rhapsodyv/voron-panel-holder/v12-fase3-juncao-tophat.png

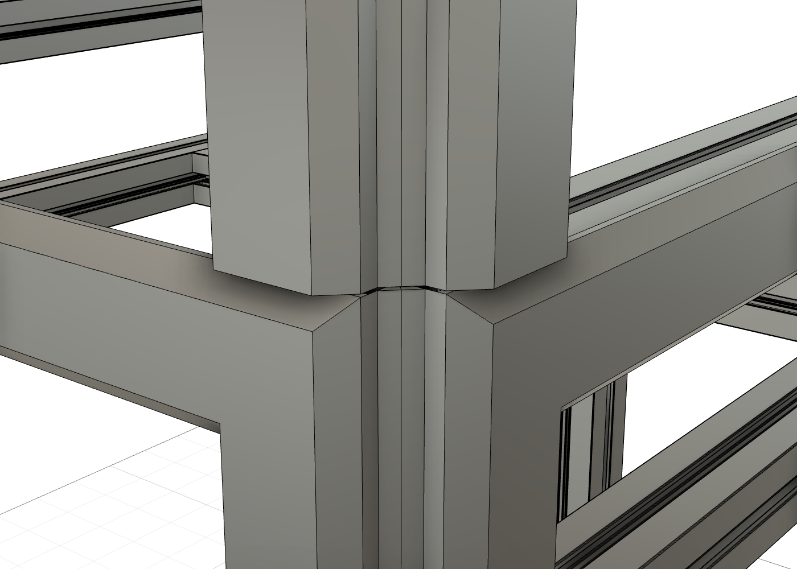
v12-fase3-juncao-tophat.png
