rhapsodyv/voron-panel-holder/aleta-porta-dobradica.png

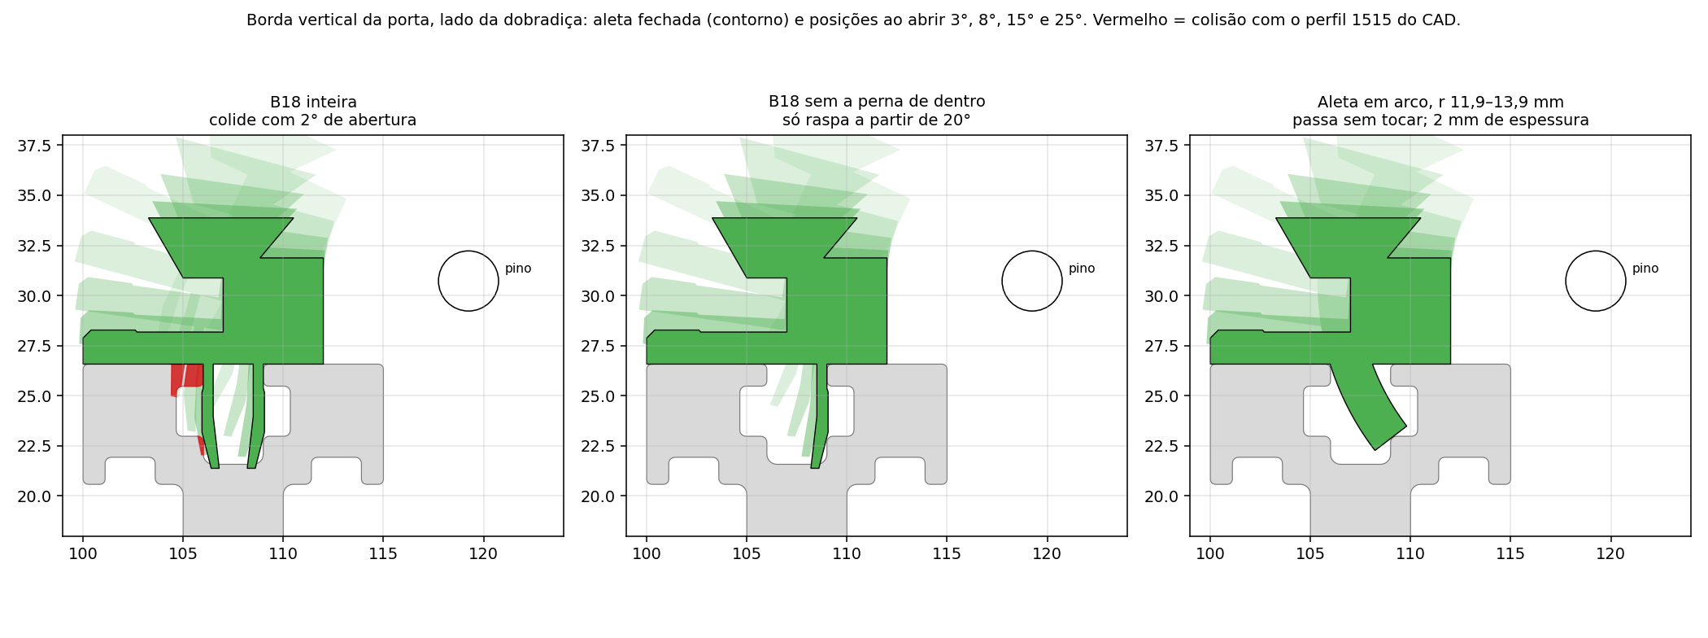
aleta-porta-dobradica.png
