rhapsodyv/voron-panel-holder/b18-rasgo-misumi.png

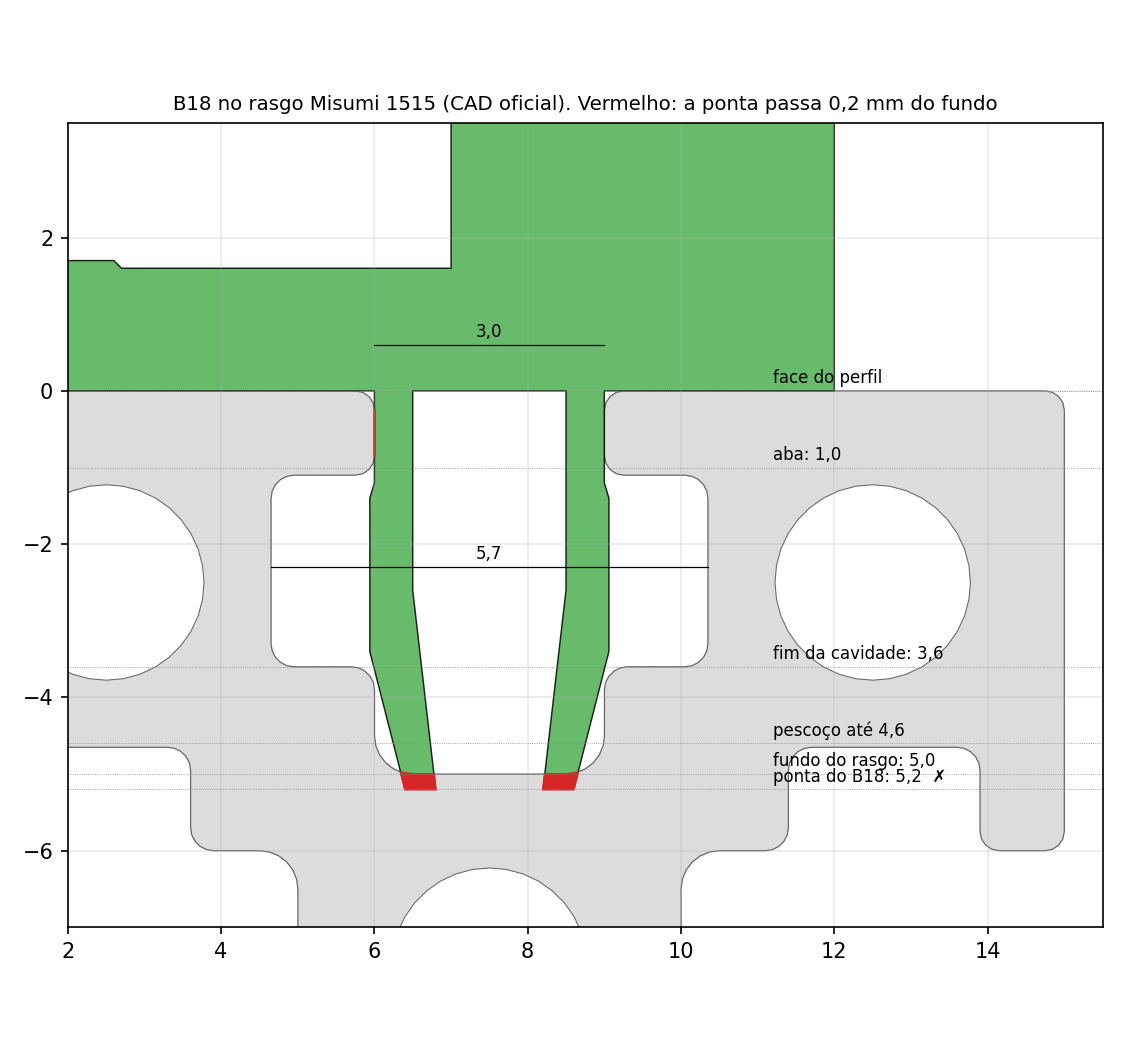
b18-rasgo-misumi.png
