rhapsodyv/voron-panel-holder/camadas-v0.png

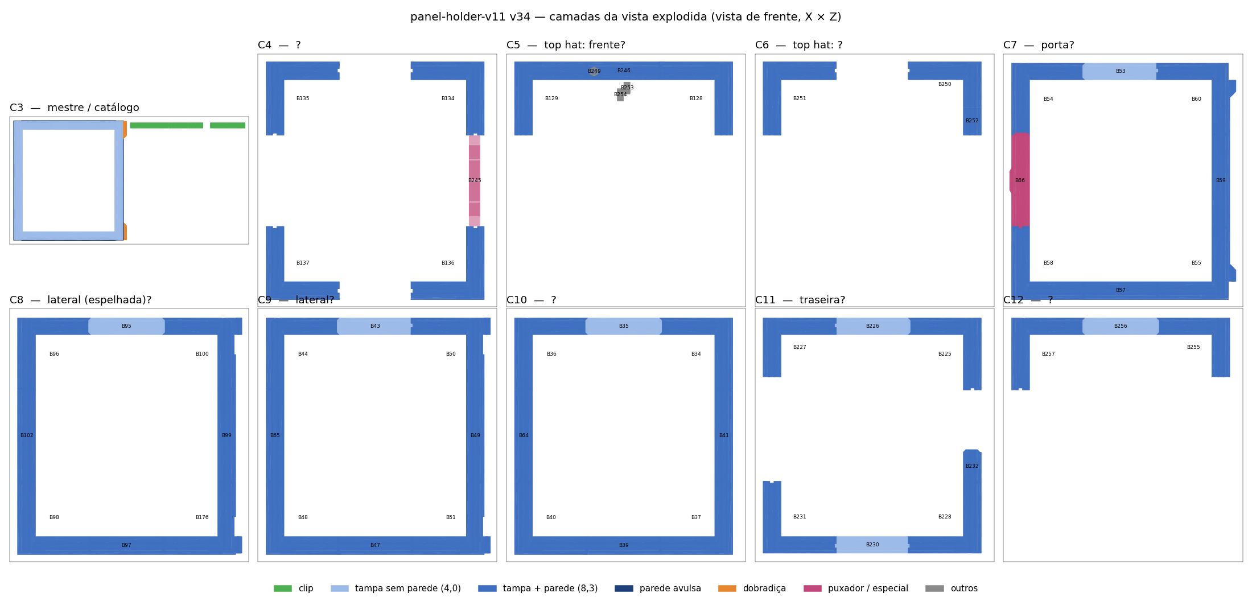
camadas-v0.png
