rhapsodyv/voron-panel-holder/canto-parede-hv-cortes.png

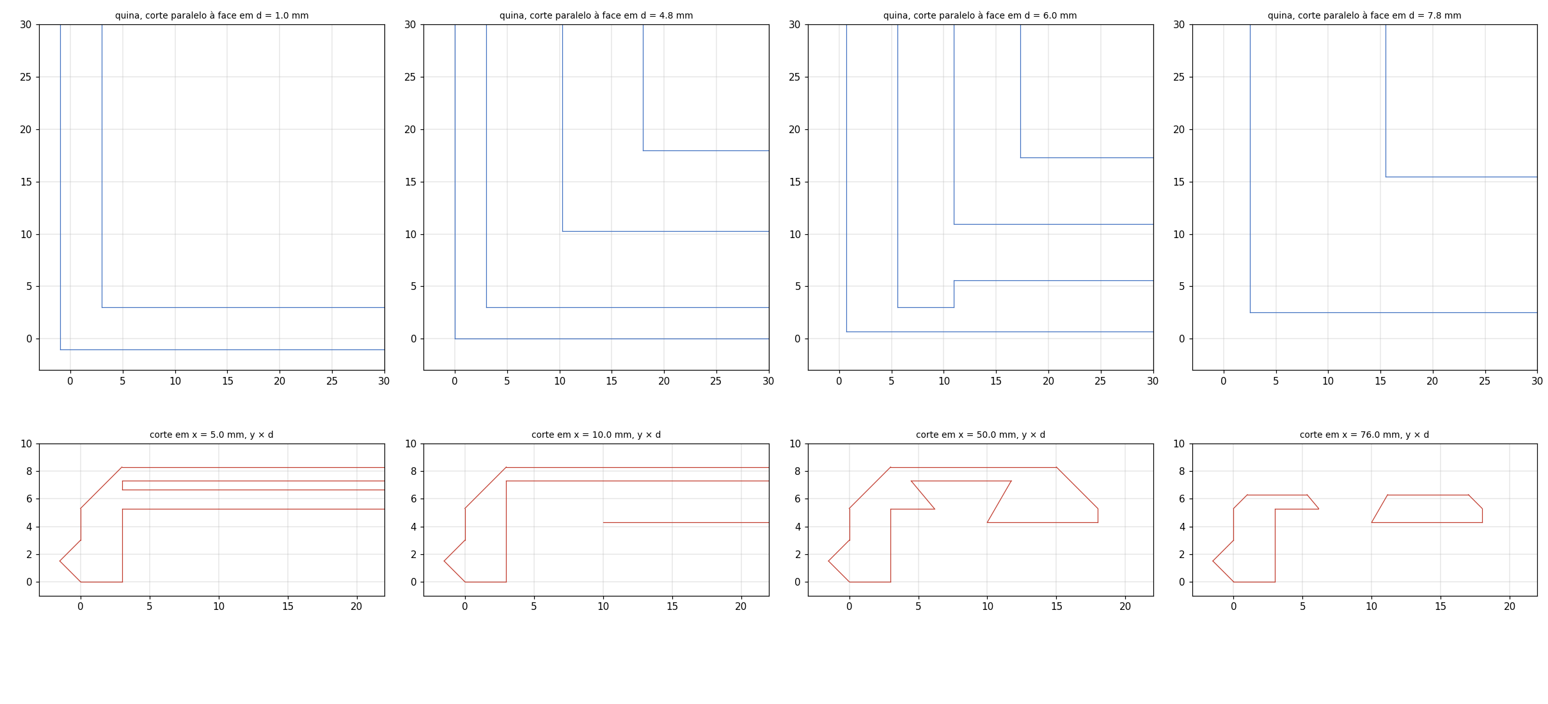
canto-parede-hv-cortes.png
