rhapsodyv/voron-panel-holder/clips-vs-tampa.png

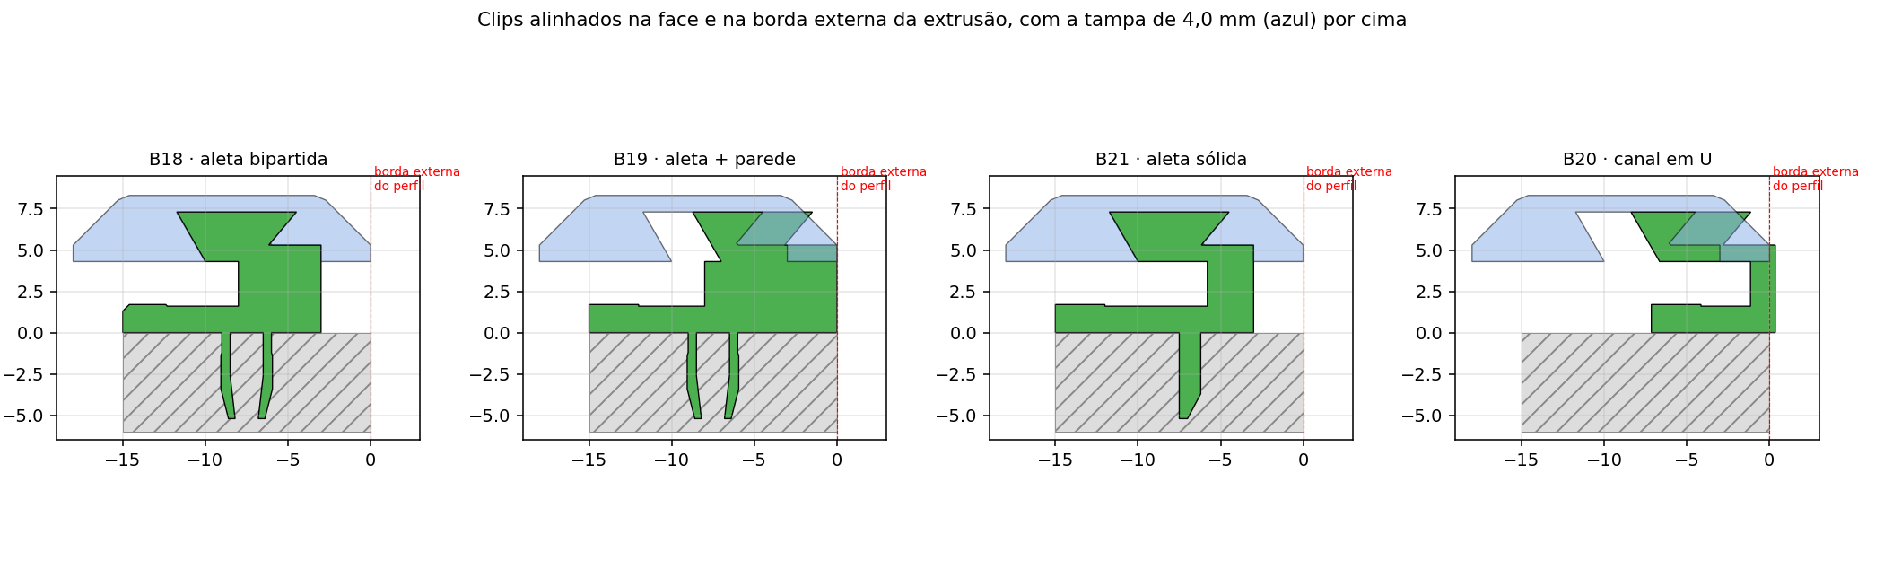
clips-vs-tampa.png
