rhapsodyv/voron-panel-holder/ideias-trava/peca-unica-aleta-iso.png

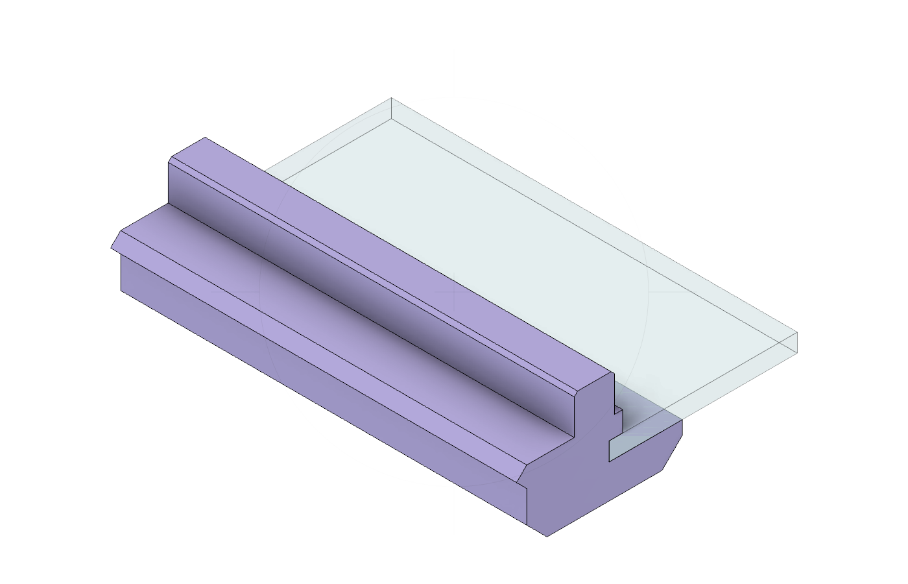
ideias-trava/peca-unica-aleta-iso.png
