rhapsodyv/voron-panel-holder/ideias-trava/peca-unica-aleta-ponta.png

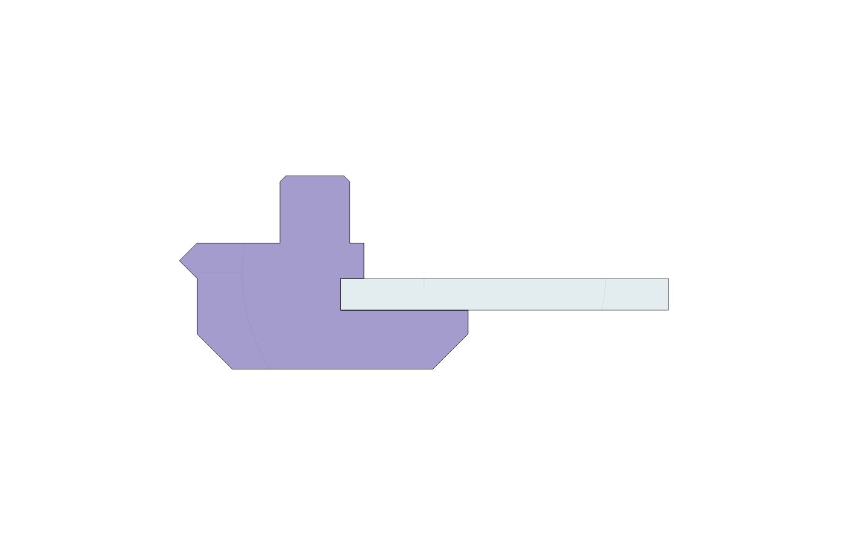
ideias-trava/peca-unica-aleta-ponta.png
