rhapsodyv/voron-panel-holder/ideias-trava/peca-unica-balanco.png

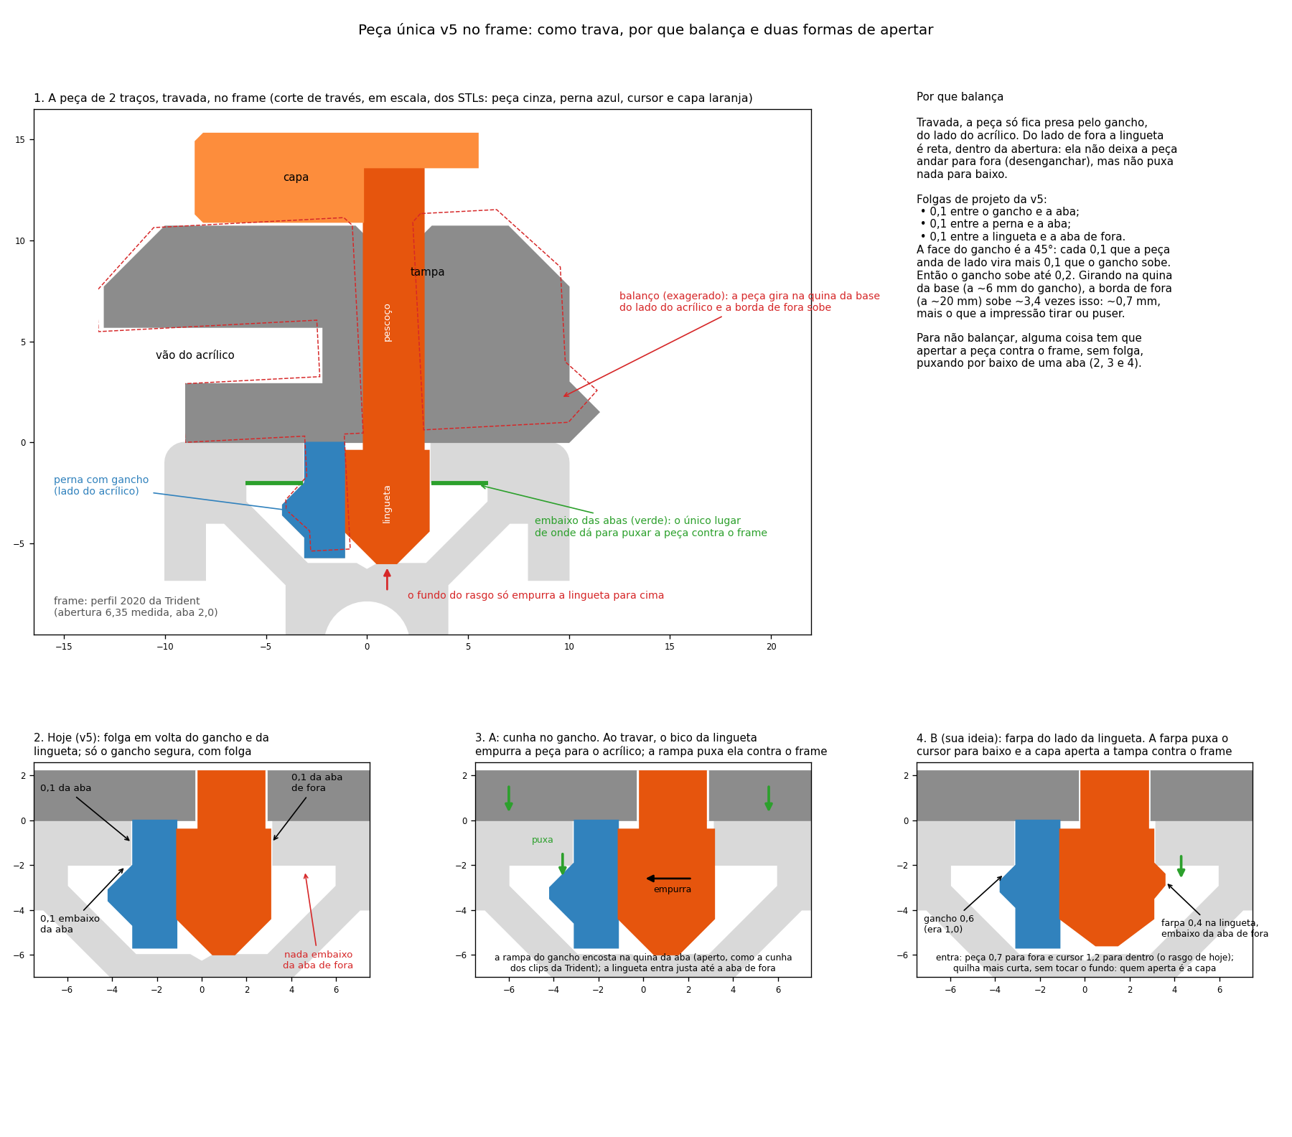
ideias-trava/peca-unica-balanco.png
