rhapsodyv/voron-panel-holder/ideias-trava/peca-unica-base-inteira-iso.png

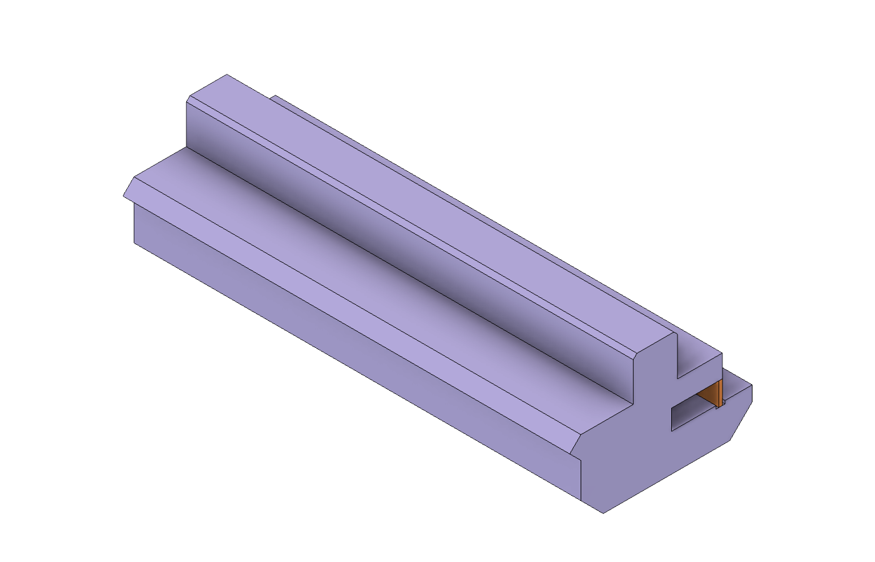
ideias-trava/peca-unica-base-inteira-iso.png
