rhapsodyv/voron-panel-holder/ideias-trava/peca-unica-base-inteira-ponta.png

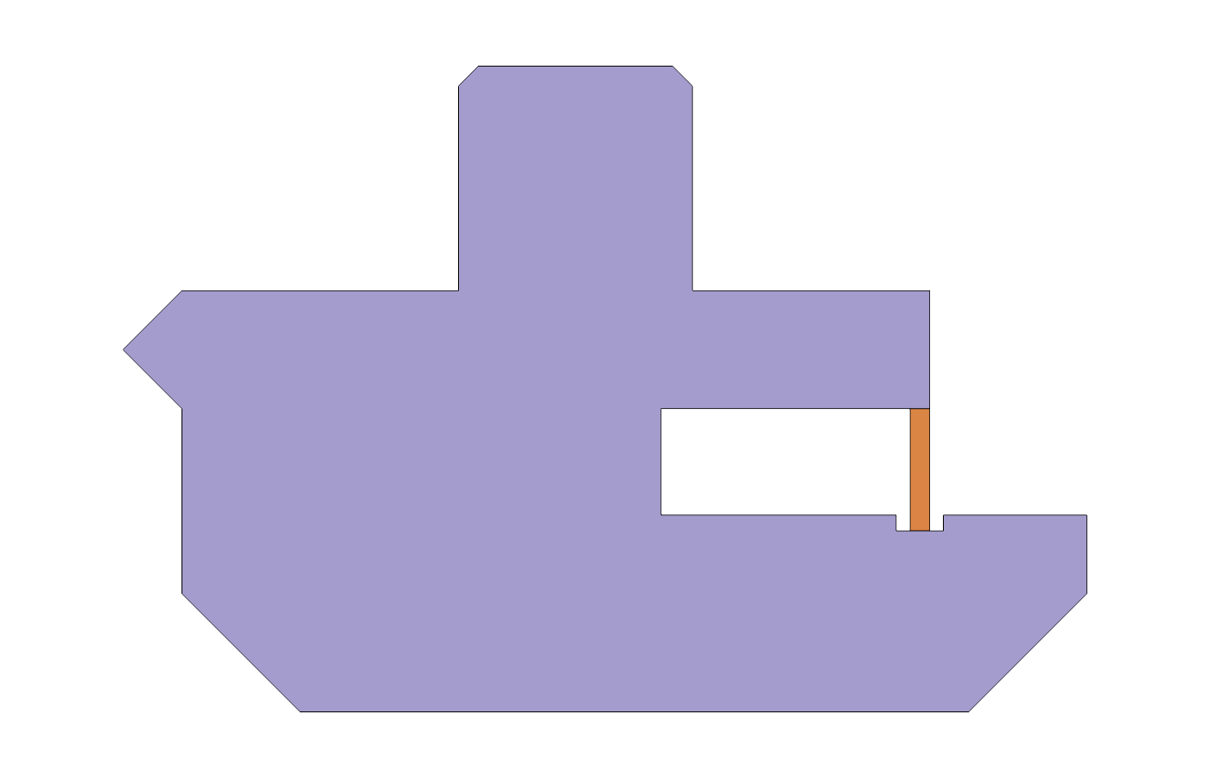
ideias-trava/peca-unica-base-inteira-ponta.png
