rhapsodyv/voron-panel-holder/ideias-trava/peca-unica-canto.png

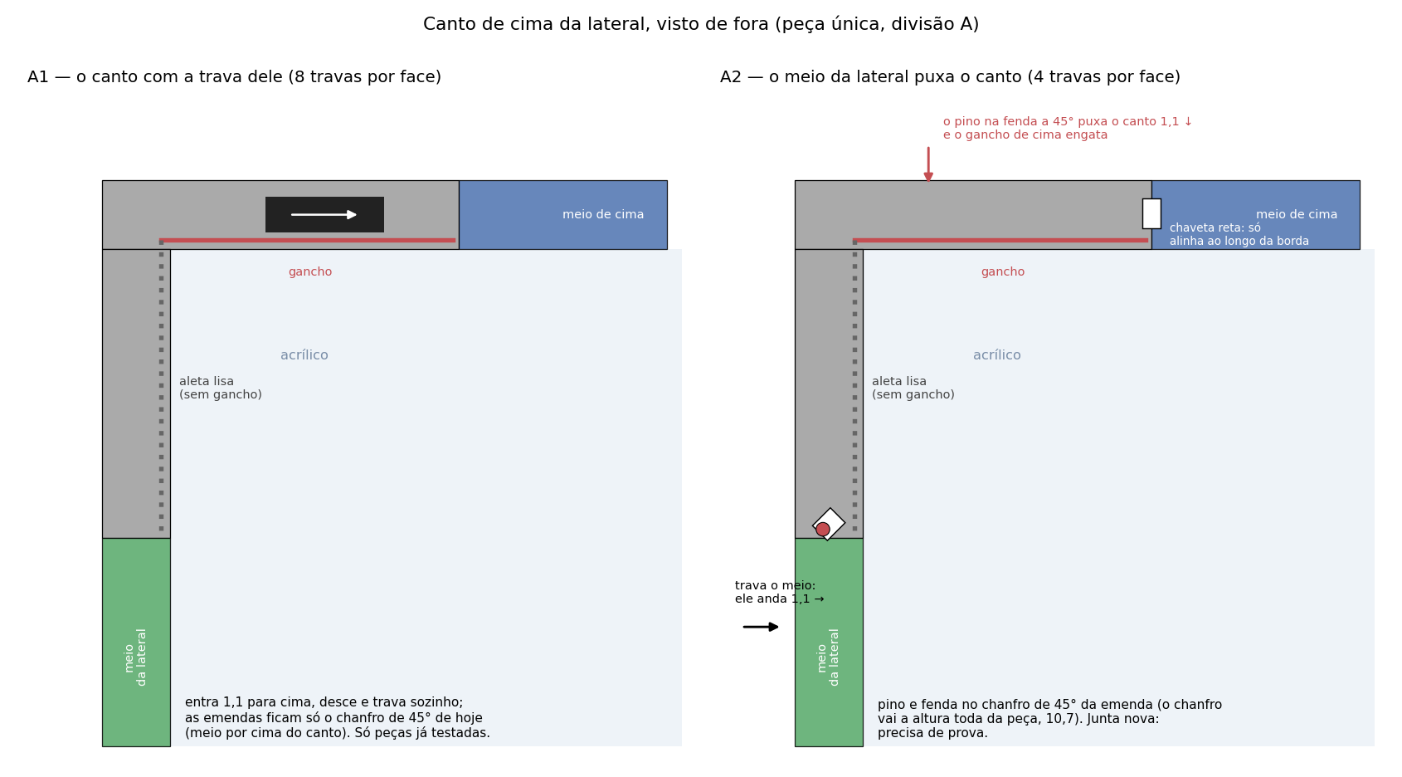
ideias-trava/peca-unica-canto.png
