rhapsodyv/voron-panel-holder/ideias-trava/peca-unica-cunha-canto.png

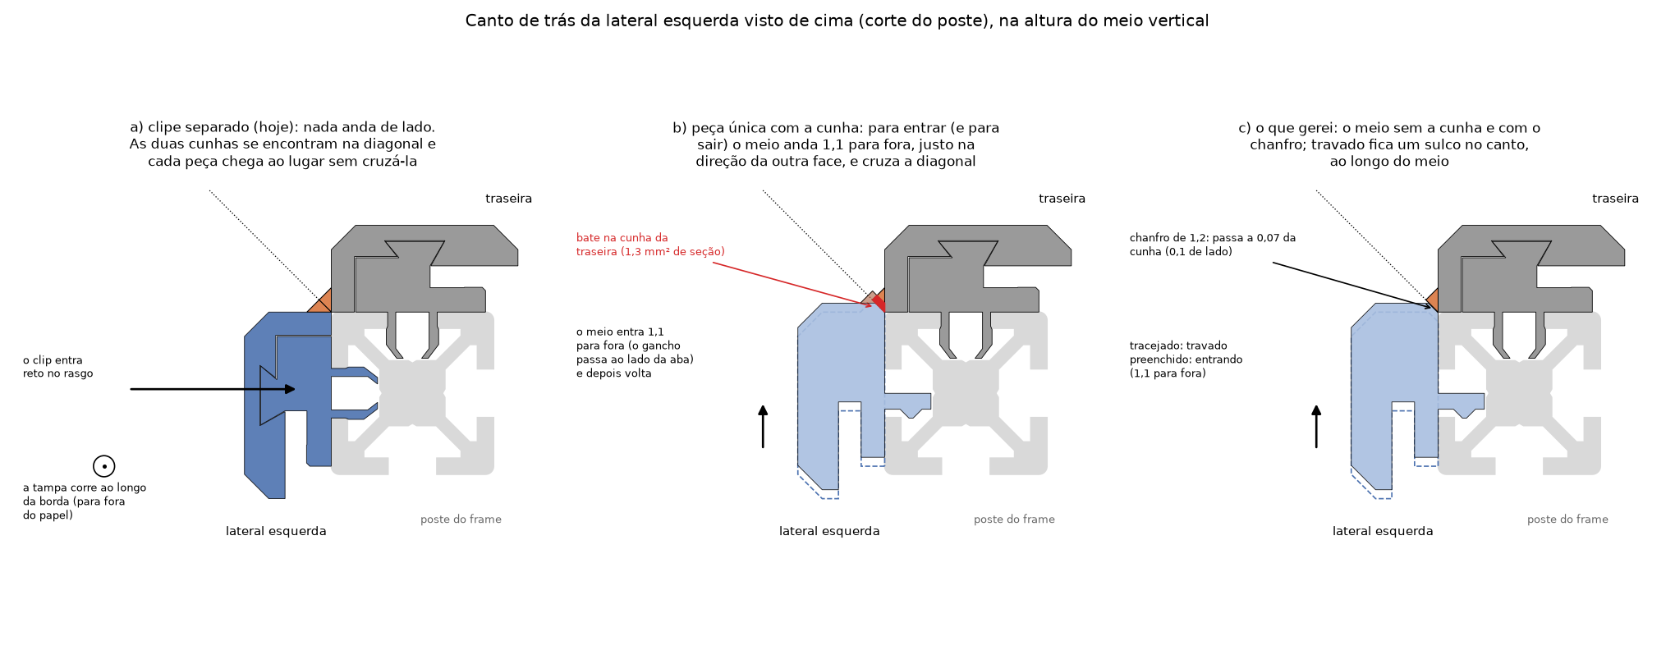
ideias-trava/peca-unica-cunha-canto.png
