rhapsodyv/voron-panel-holder/ideias-trava/peca-unica-deitada.png

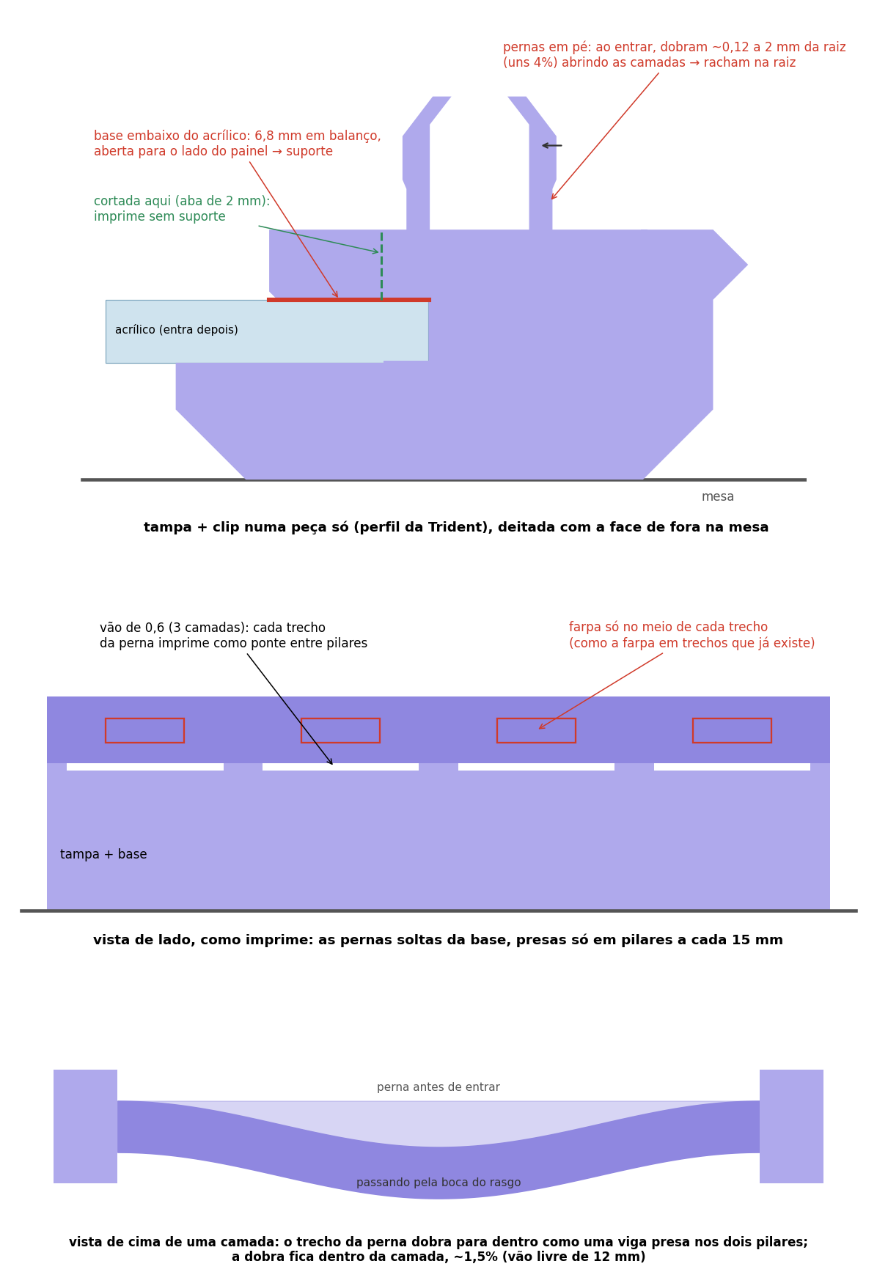
ideias-trava/peca-unica-deitada.png
