rhapsodyv/voron-panel-holder/ideias-trava/peca-unica-divisao.png

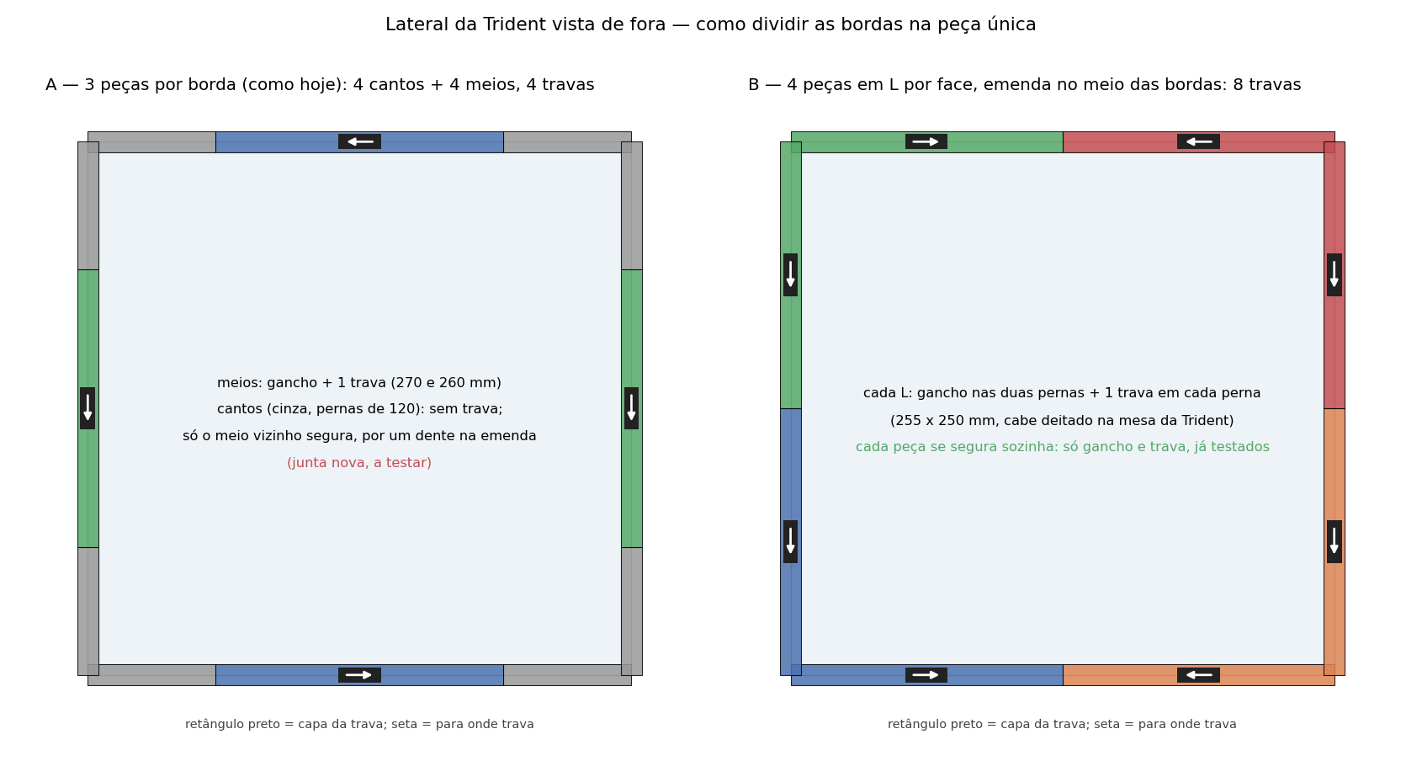
ideias-trava/peca-unica-divisao.png
