rhapsodyv/voron-panel-holder/ideias-trava/peca-unica-emenda.png

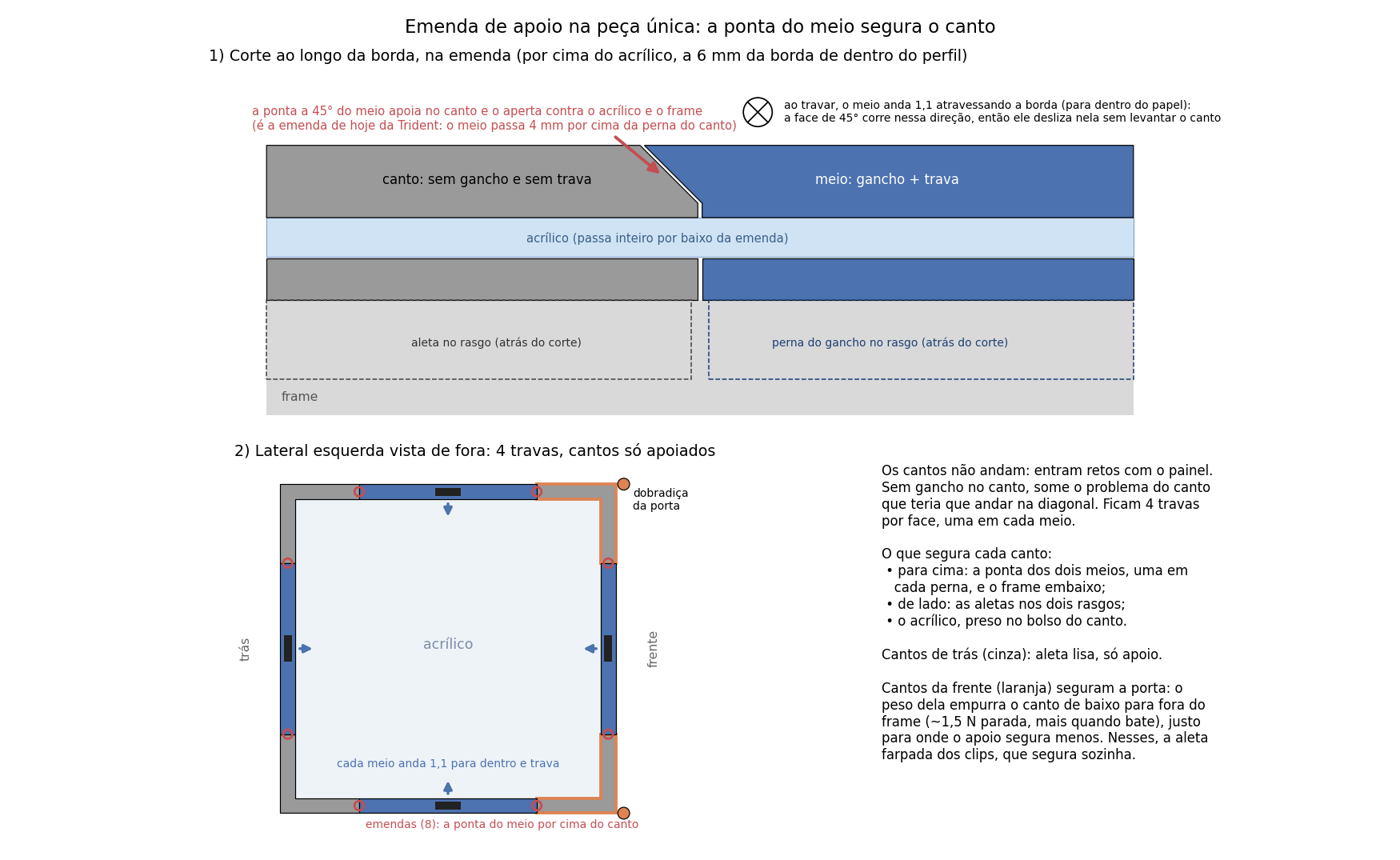
ideias-trava/peca-unica-emenda.png
