rhapsodyv/voron-panel-holder/ideias-trava/peca-unica-fusion-ponta.png

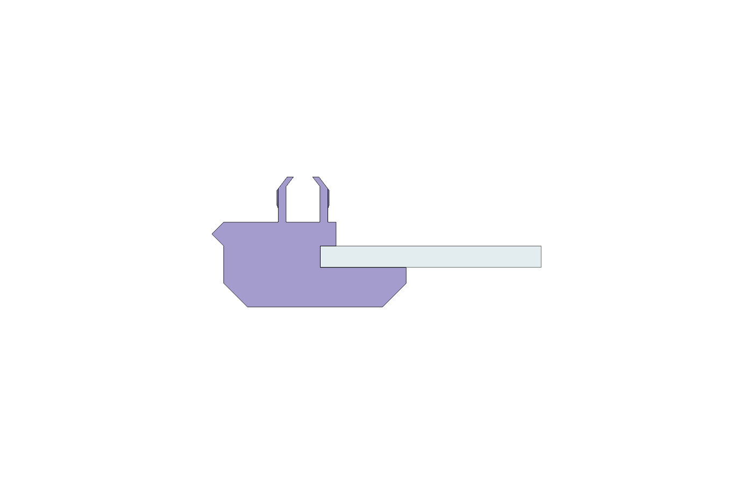
ideias-trava/peca-unica-fusion-ponta.png
