rhapsodyv/voron-panel-holder/ideias-trava/peca-unica-sem-deslocar.png

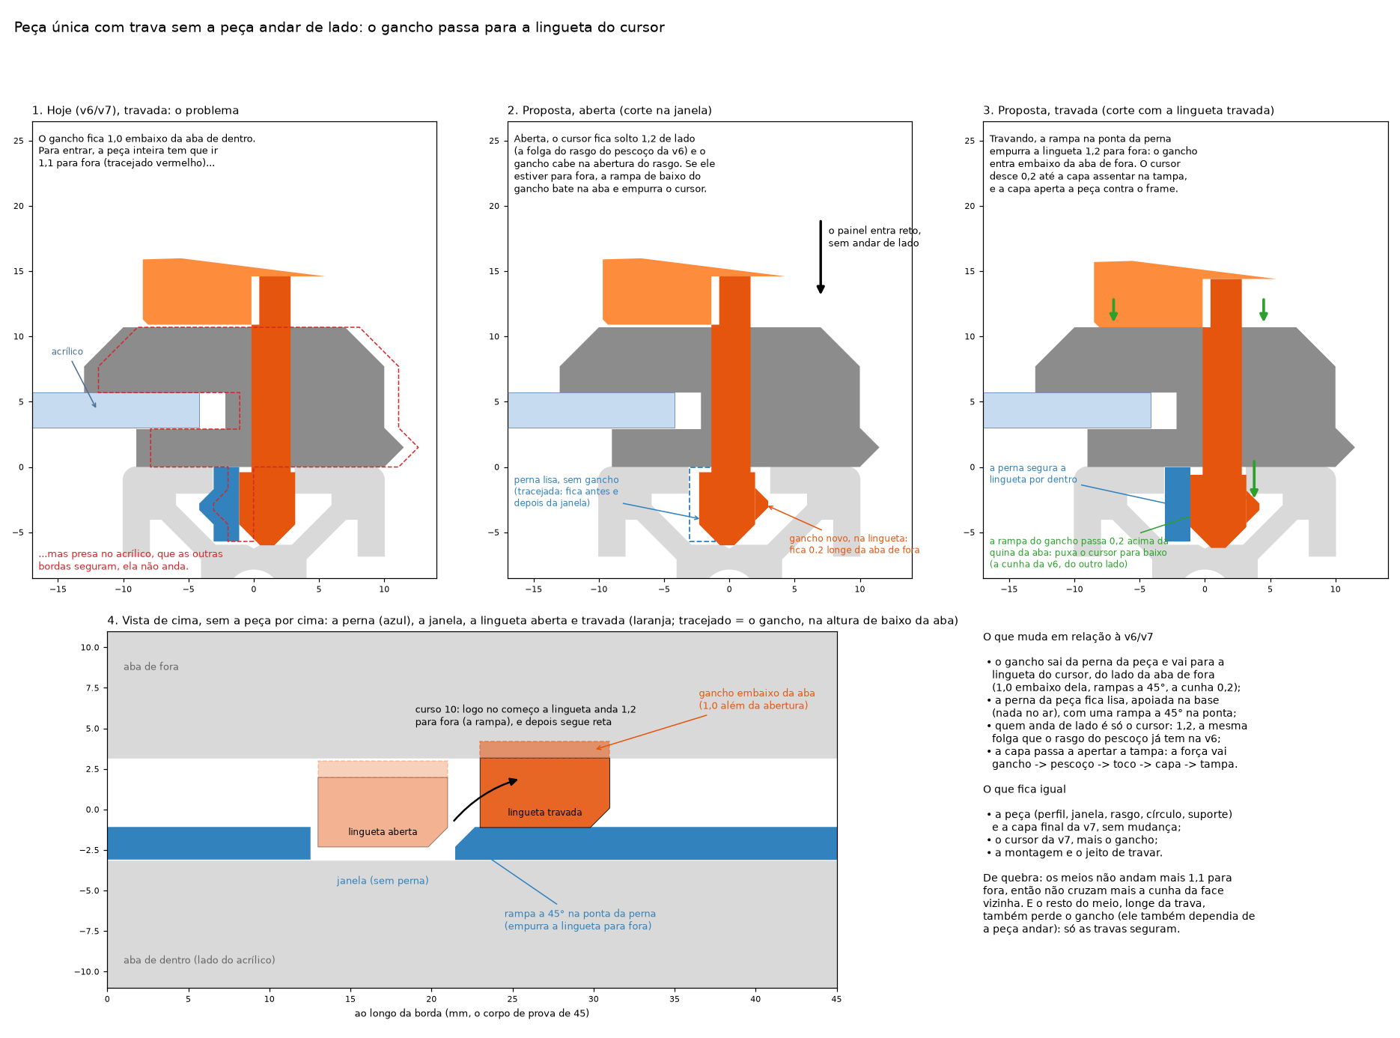
ideias-trava/peca-unica-sem-deslocar.png
