rhapsodyv/voron-panel-holder/ideias-trava/trava-bordas-proposta.png

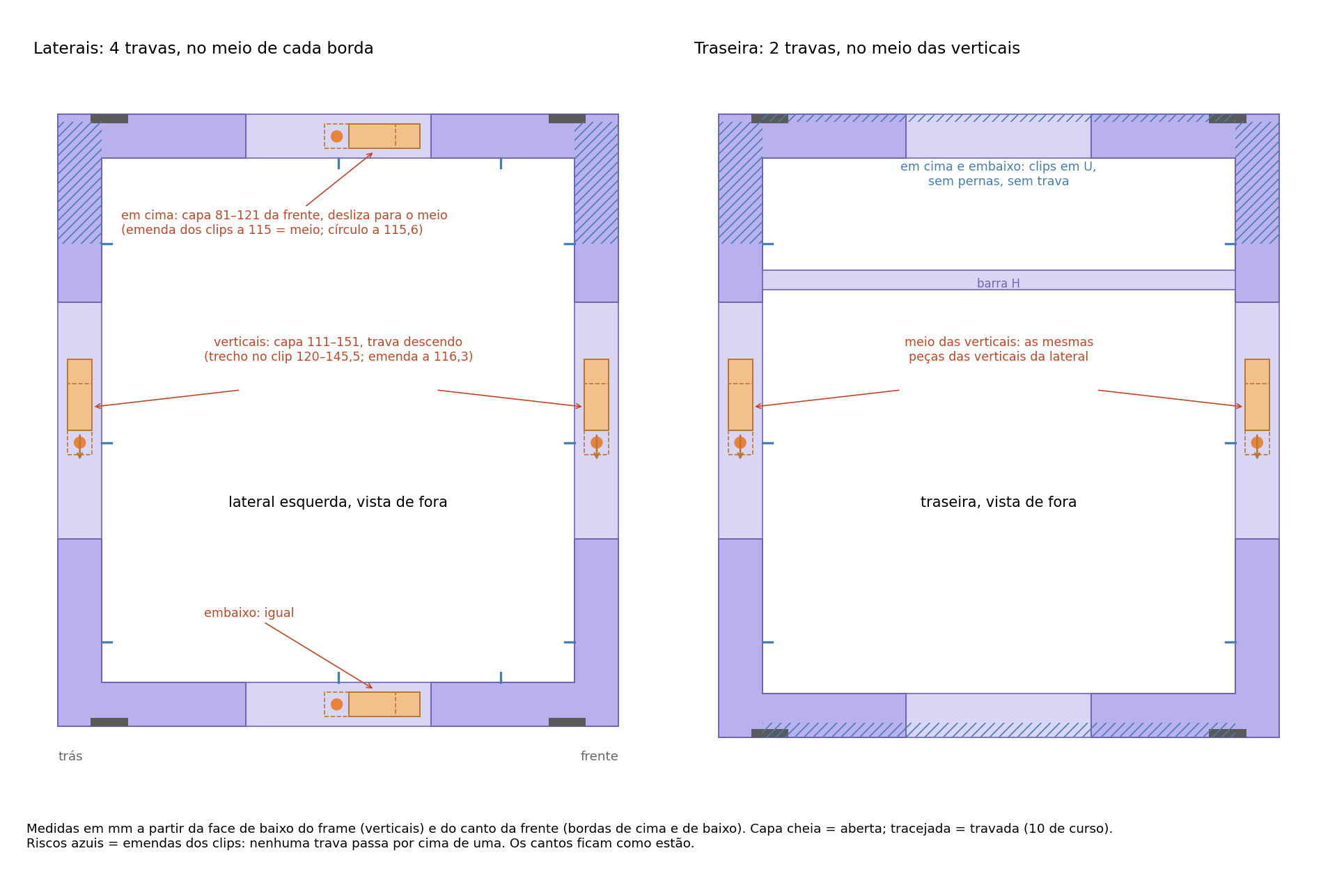
ideias-trava/trava-bordas-proposta.png
