rhapsodyv/voron-panel-holder/ideias-trava/trava-cantos-proposta-v2.png

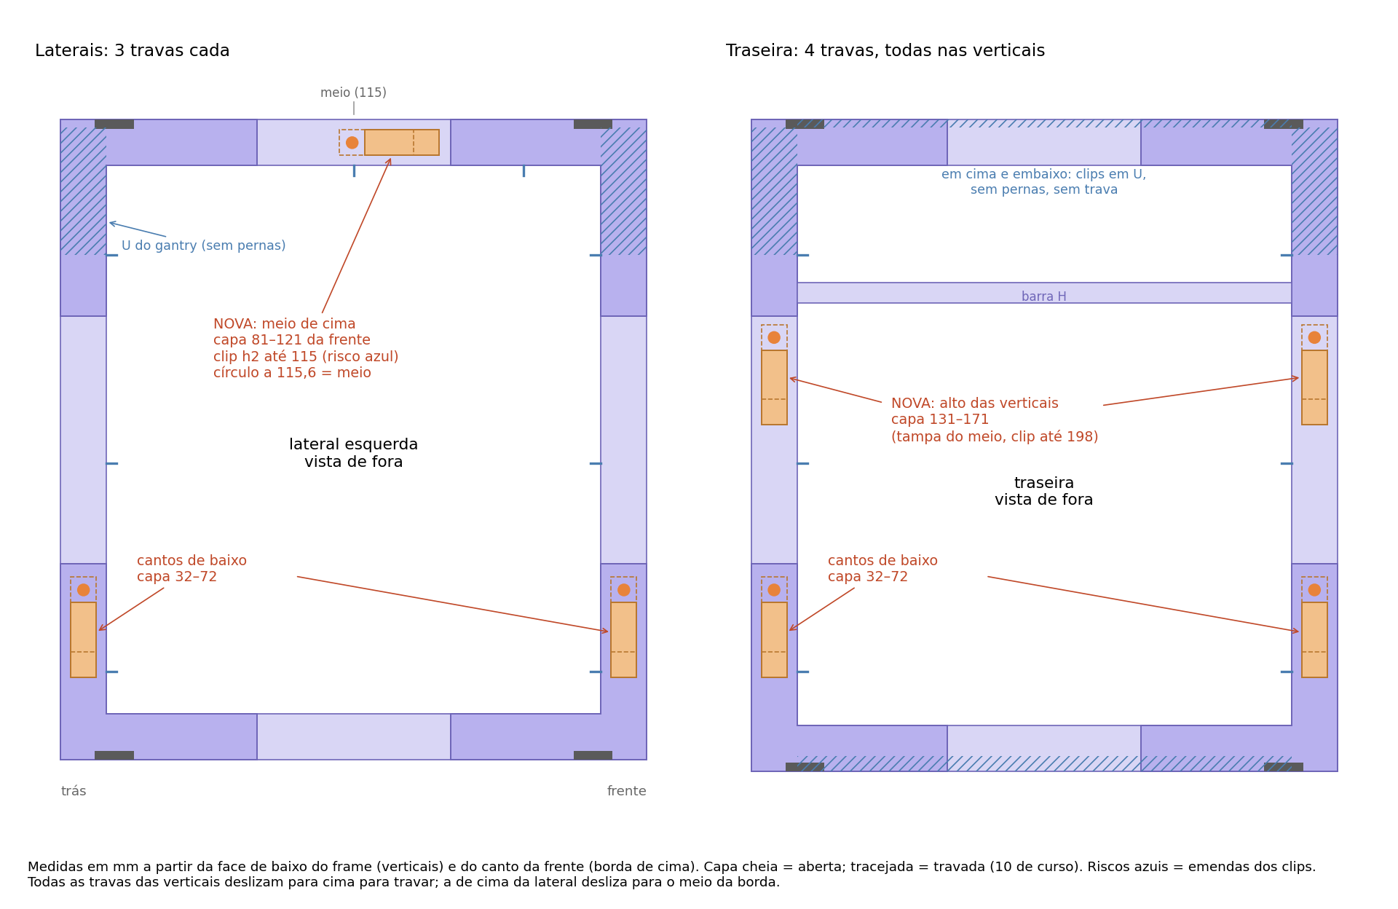
ideias-trava/trava-cantos-proposta-v2.png
