rhapsodyv/voron-panel-holder/ideias-trava/trava-cantos-proposta.png

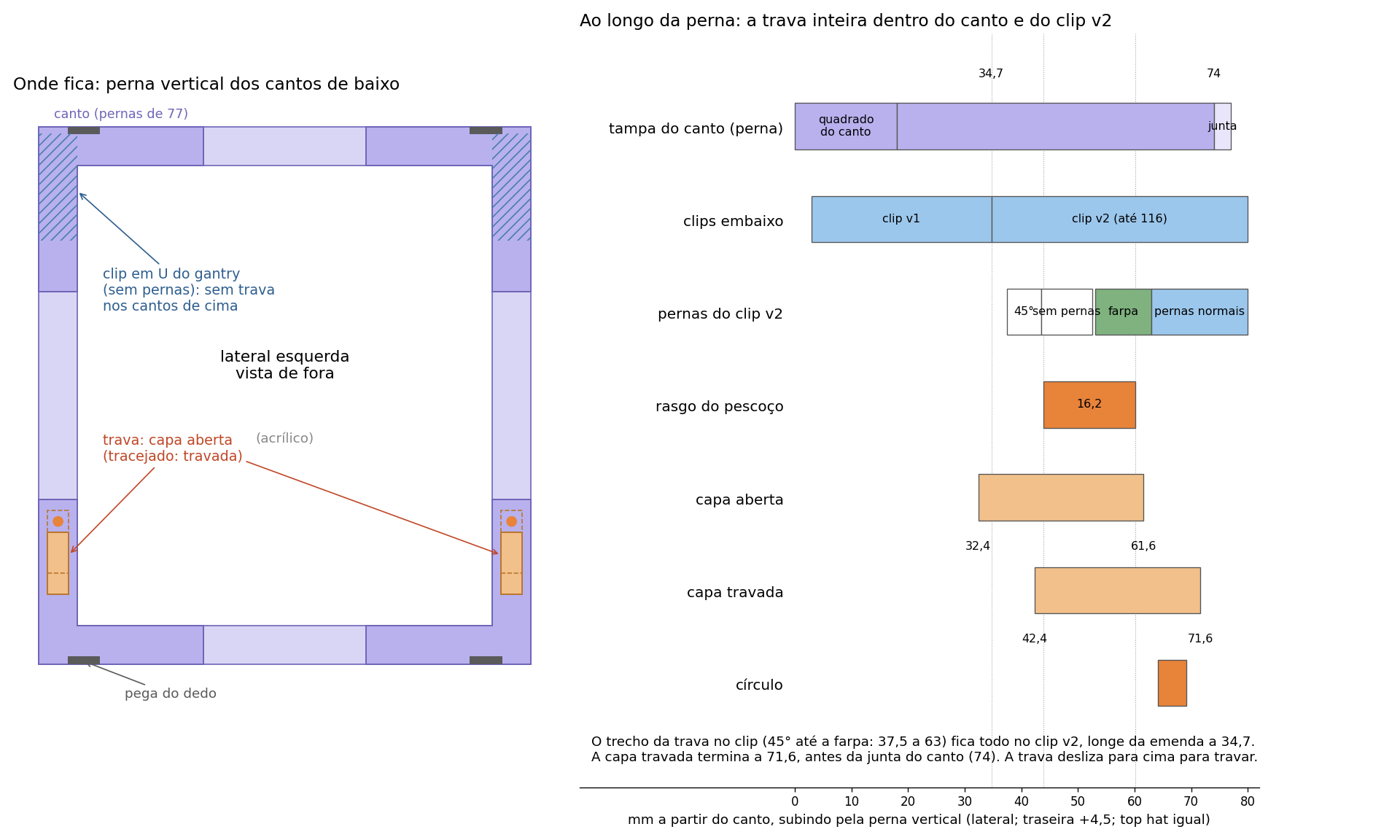
ideias-trava/trava-cantos-proposta.png
