rhapsodyv/voron-panel-holder/ideias-trava/trava-capa-folga.png

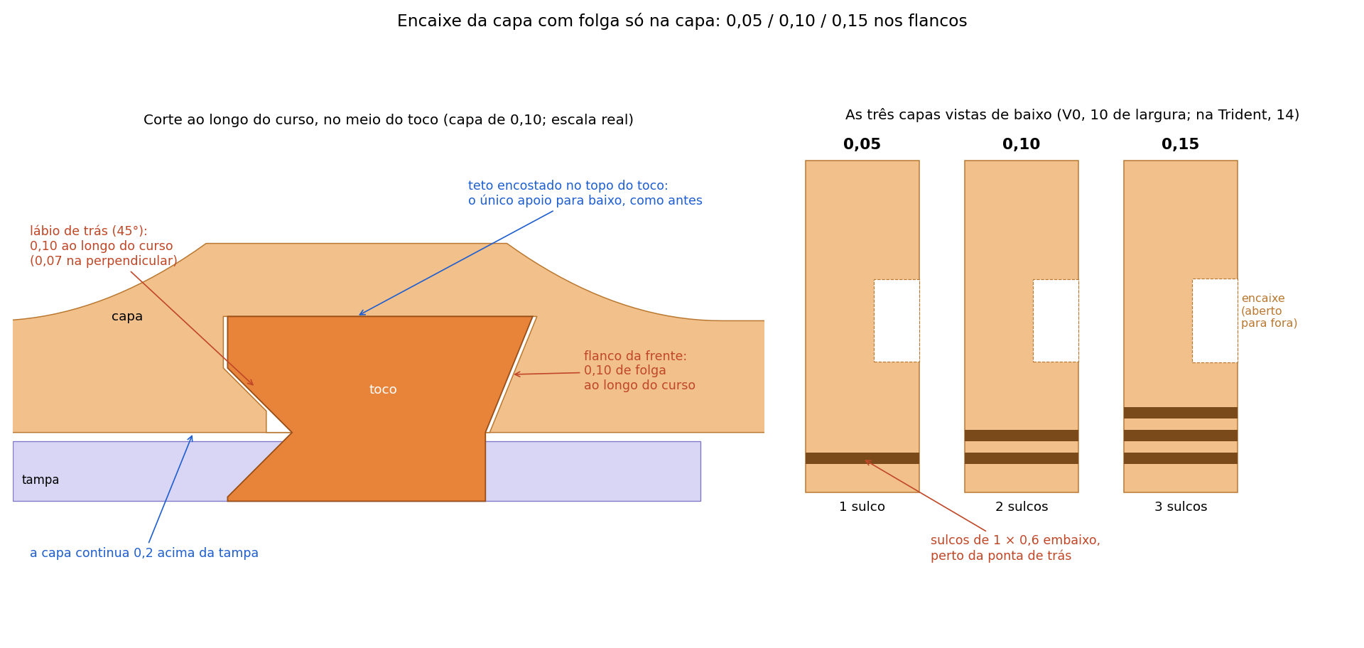
ideias-trava/trava-capa-folga.png
