rhapsodyv/voron-panel-holder/ideias-trava/trava-corpo-de-prova.png

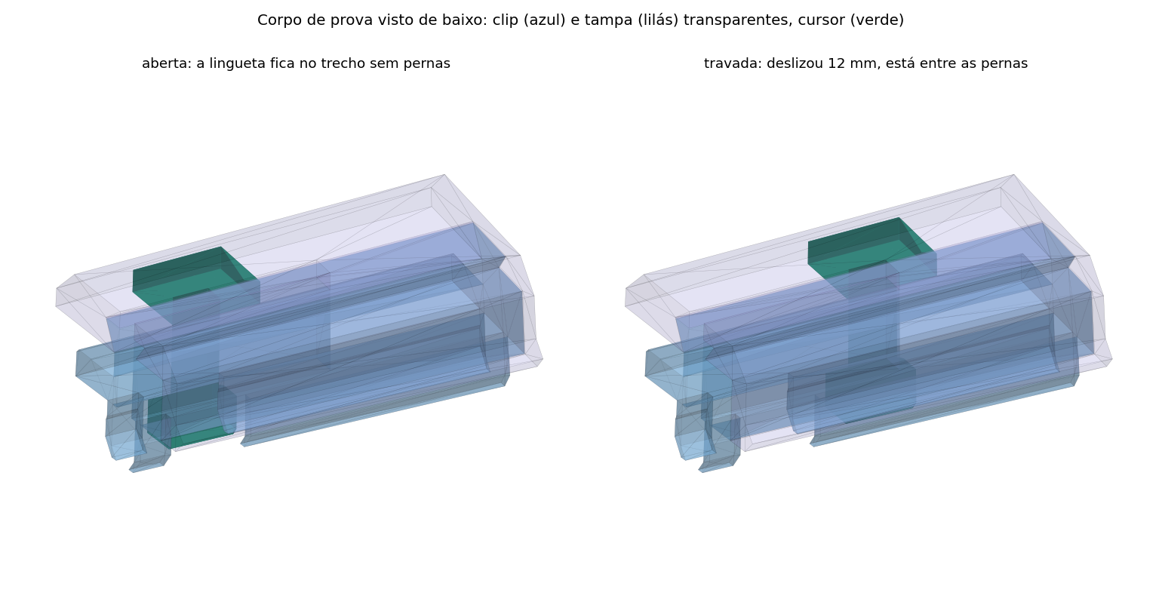
ideias-trava/trava-corpo-de-prova.png
