rhapsodyv/voron-panel-holder/ideias-trava/trava-deslizante.png

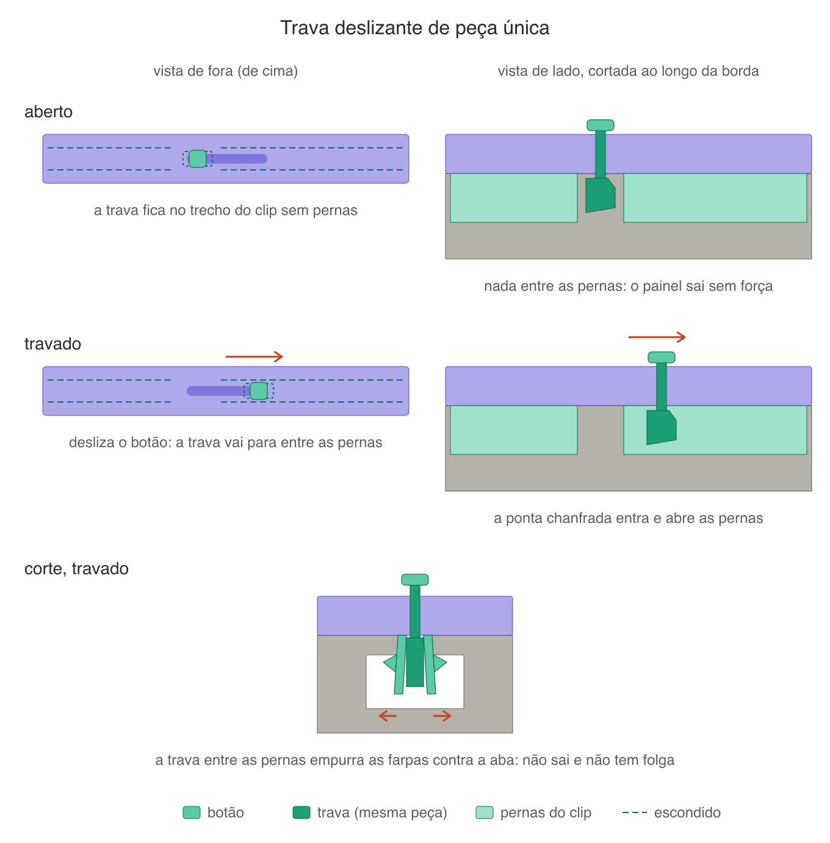
ideias-trava/trava-deslizante.png
