rhapsodyv/voron-panel-holder/ideias-trava/trava-v0-pescoco-largo.png

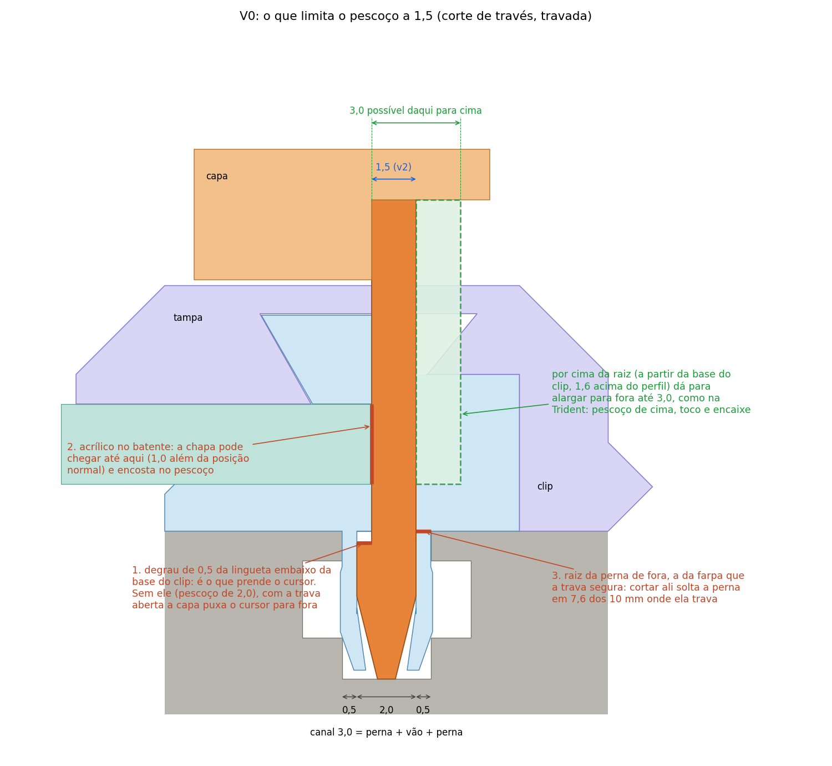
ideias-trava/trava-v0-pescoco-largo.png
