rhapsodyv/voron-panel-holder/ideias-trava/trava-v0-v1.png

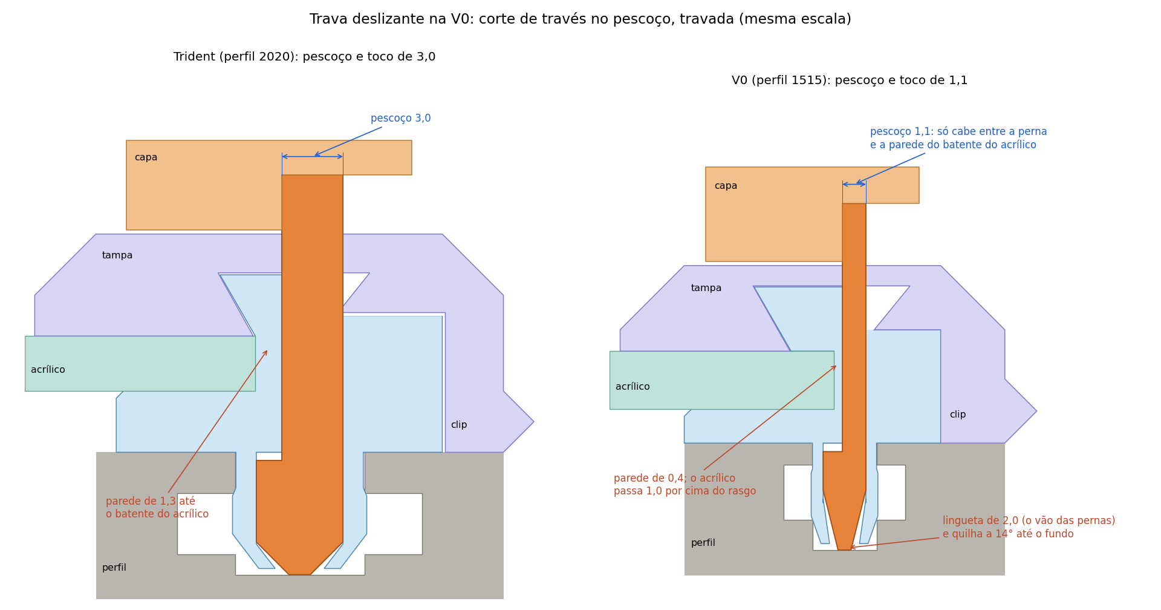
ideias-trava/trava-v0-v1.png
