rhapsodyv/voron-panel-holder/ideias-trava/trava-v0-v3.png

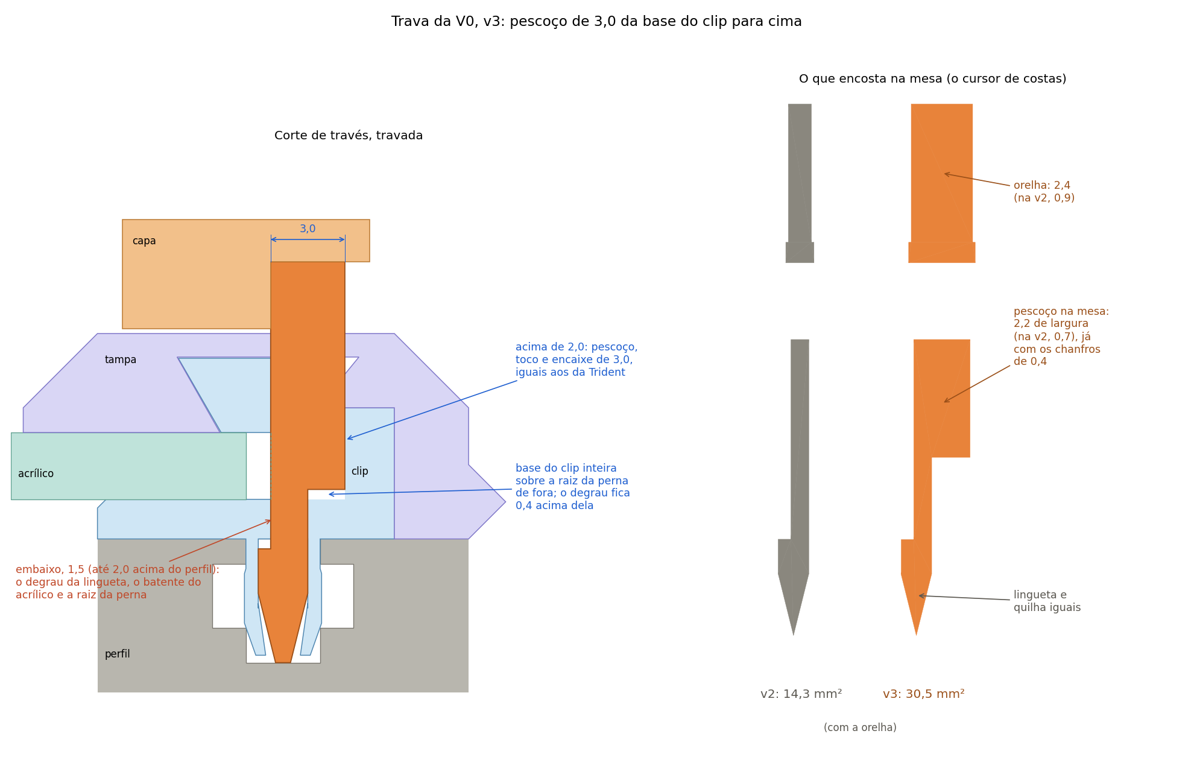
ideias-trava/trava-v0-v3.png
