rhapsodyv/voron-panel-holder/ideias-trava/trava-v3.png

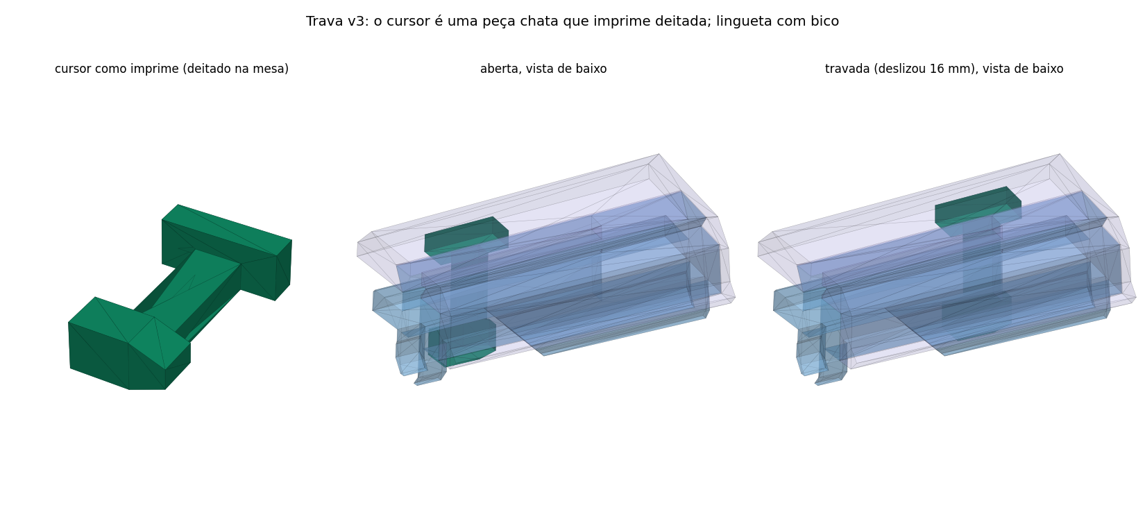
ideias-trava/trava-v3.png
