rhapsodyv/voron-panel-holder/ideias-trava/trava-v4-proposta.png

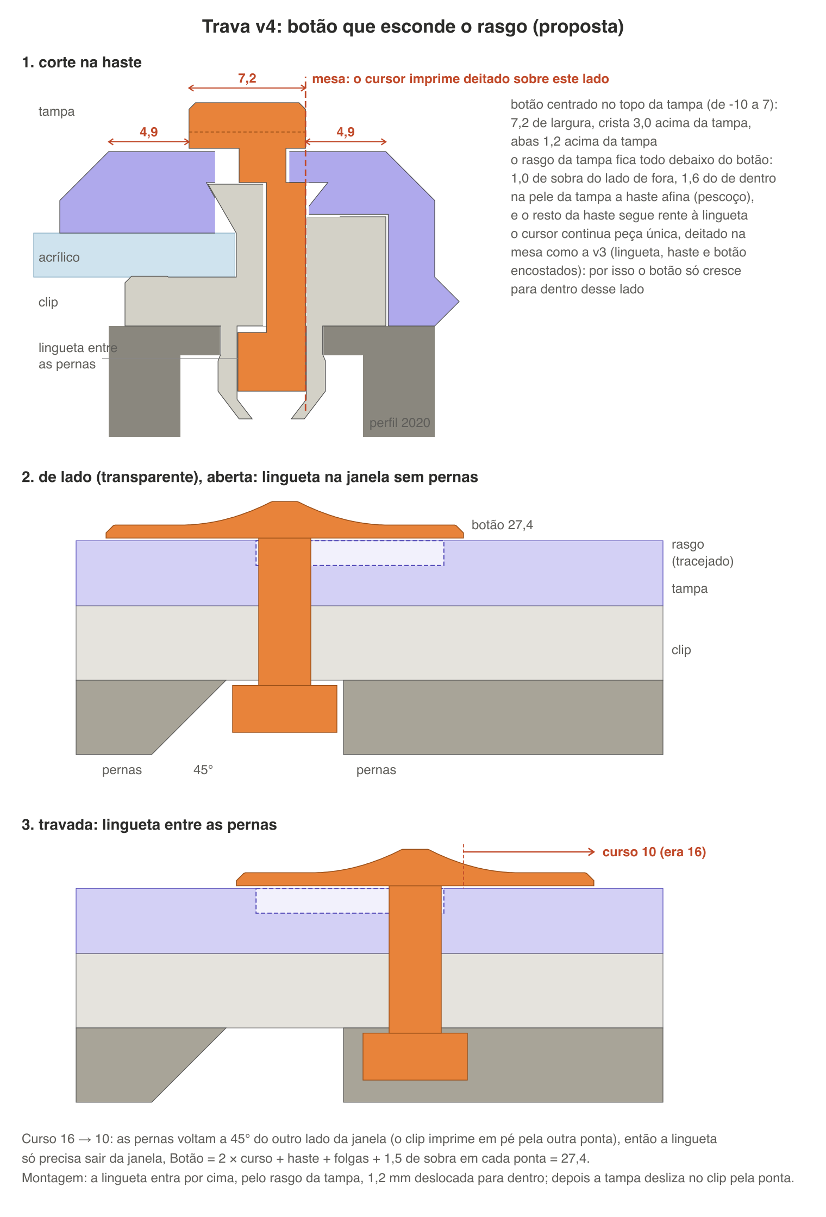
ideias-trava/trava-v4-proposta.png
