rhapsodyv/voron-panel-holder/ideias-trava/trava-v4.png

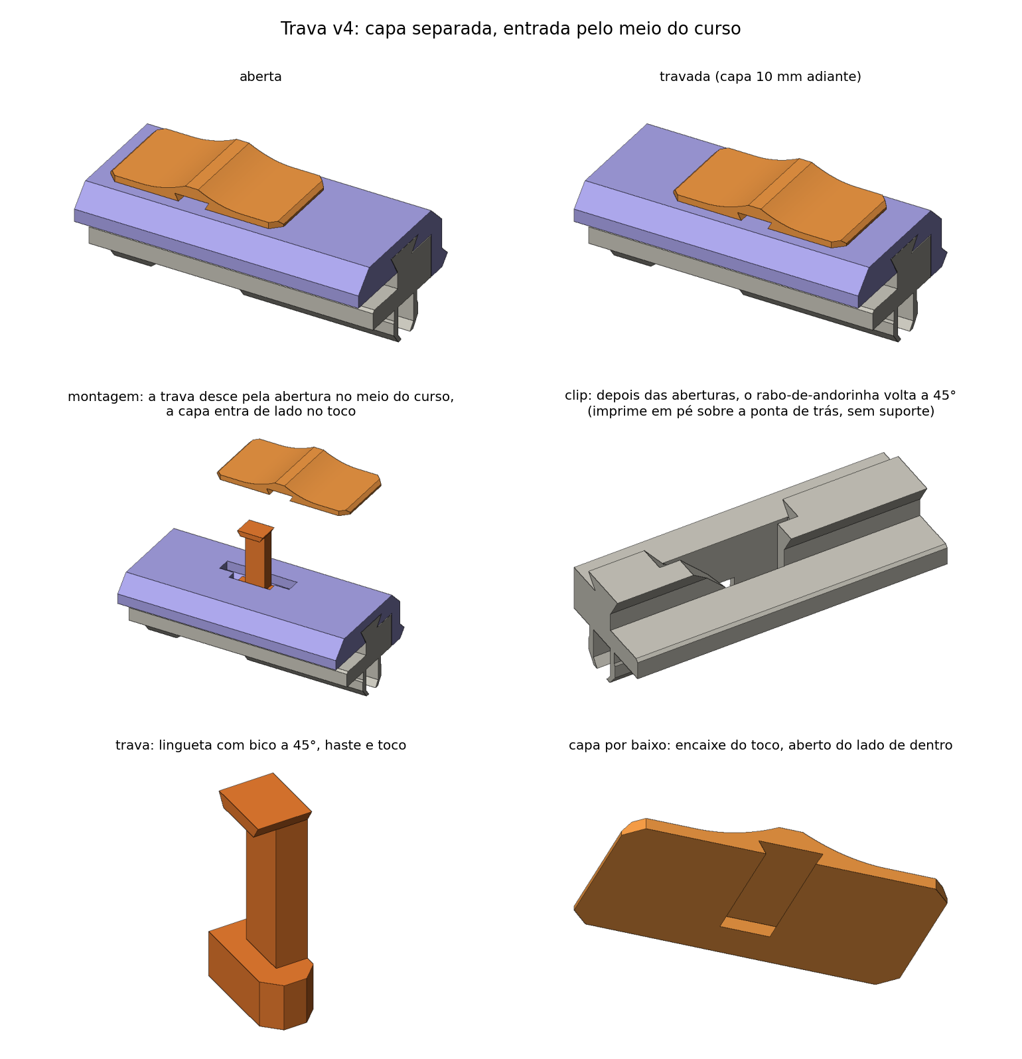
ideias-trava/trava-v4.png
