rhapsodyv/voron-panel-holder/ideias-trava/trava-v5-robusta.png

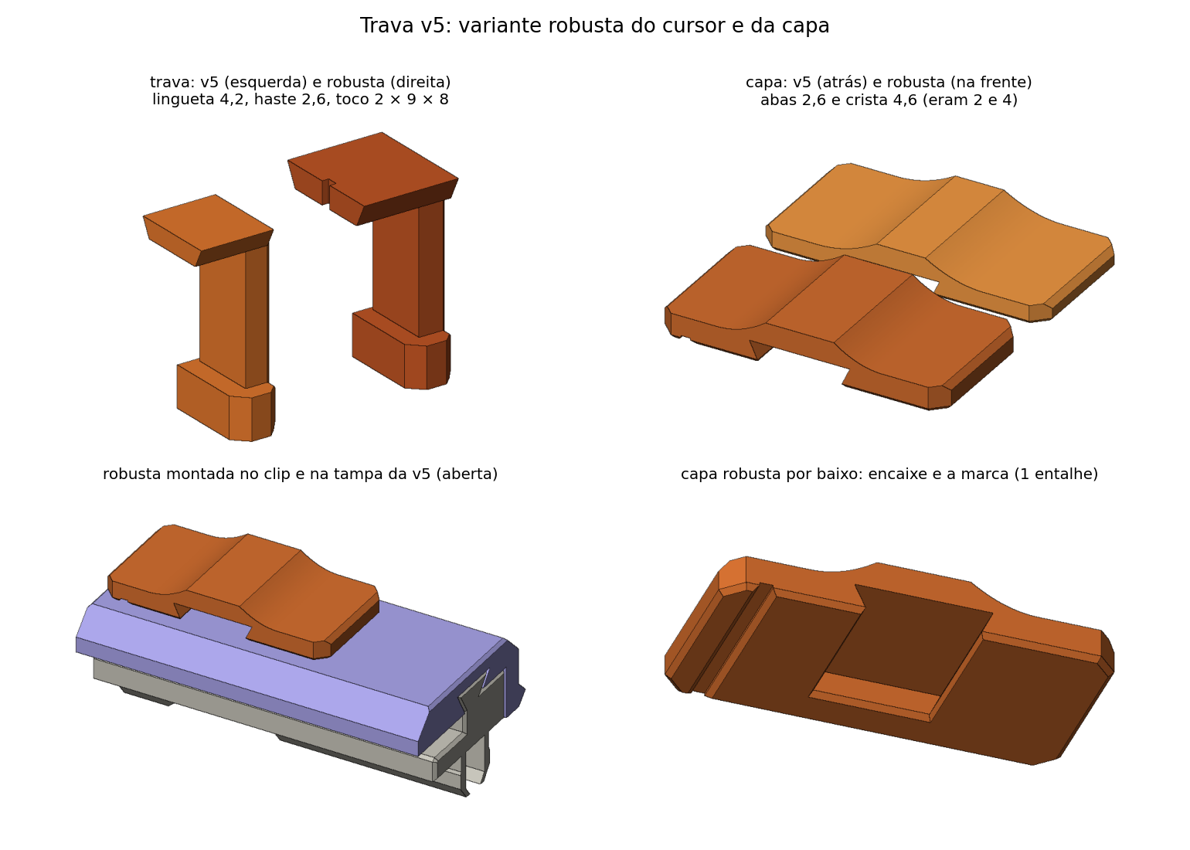
ideias-trava/trava-v5-robusta.png
