rhapsodyv/voron-panel-holder/ideias-trava/trava-v6-corte.png

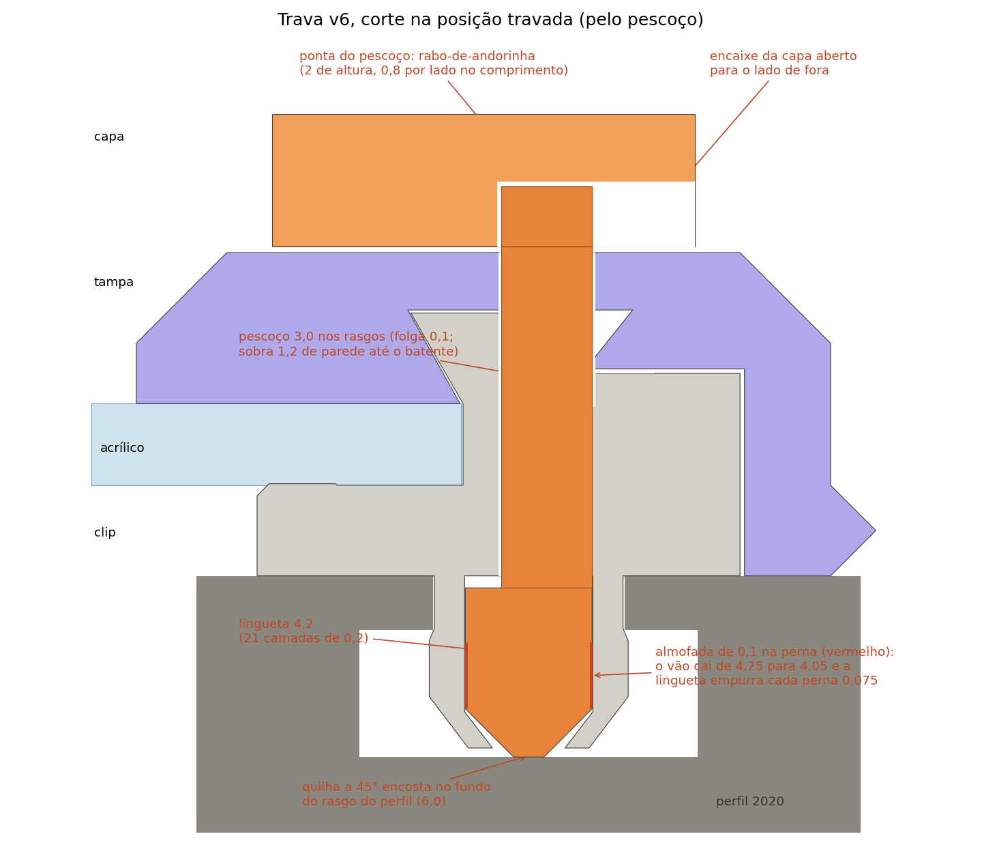
ideias-trava/trava-v6-corte.png
