rhapsodyv/voron-panel-holder/ideias-trava/trava-v6-medidas.png

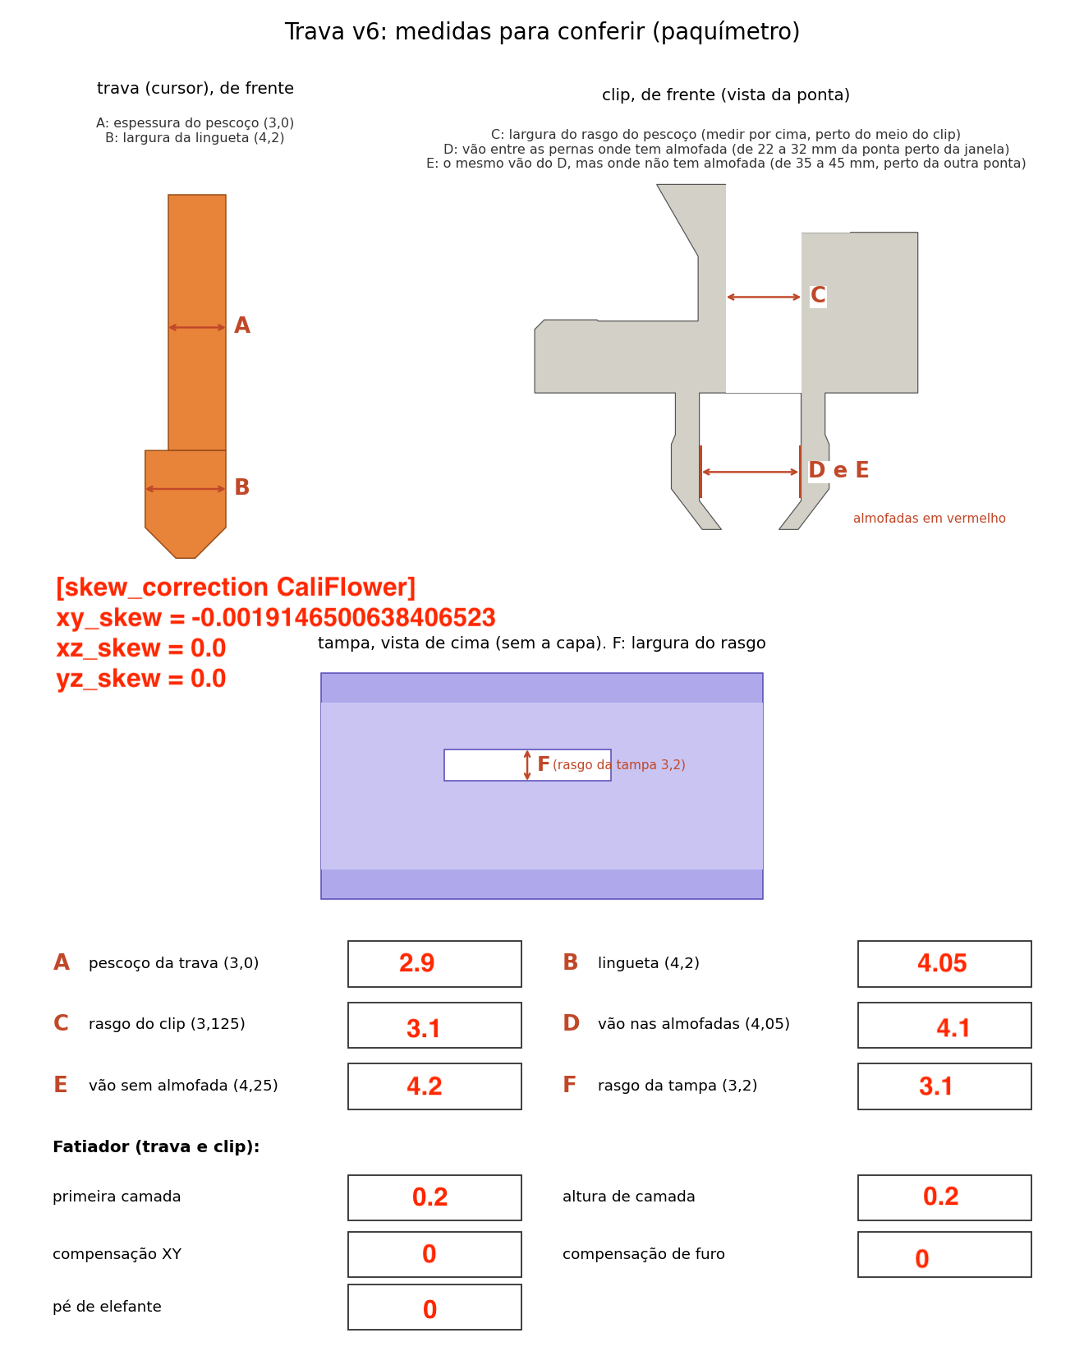
ideias-trava/trava-v6-medidas.png
