rhapsodyv/voron-panel-holder/ideias-trava/trava-v6.png

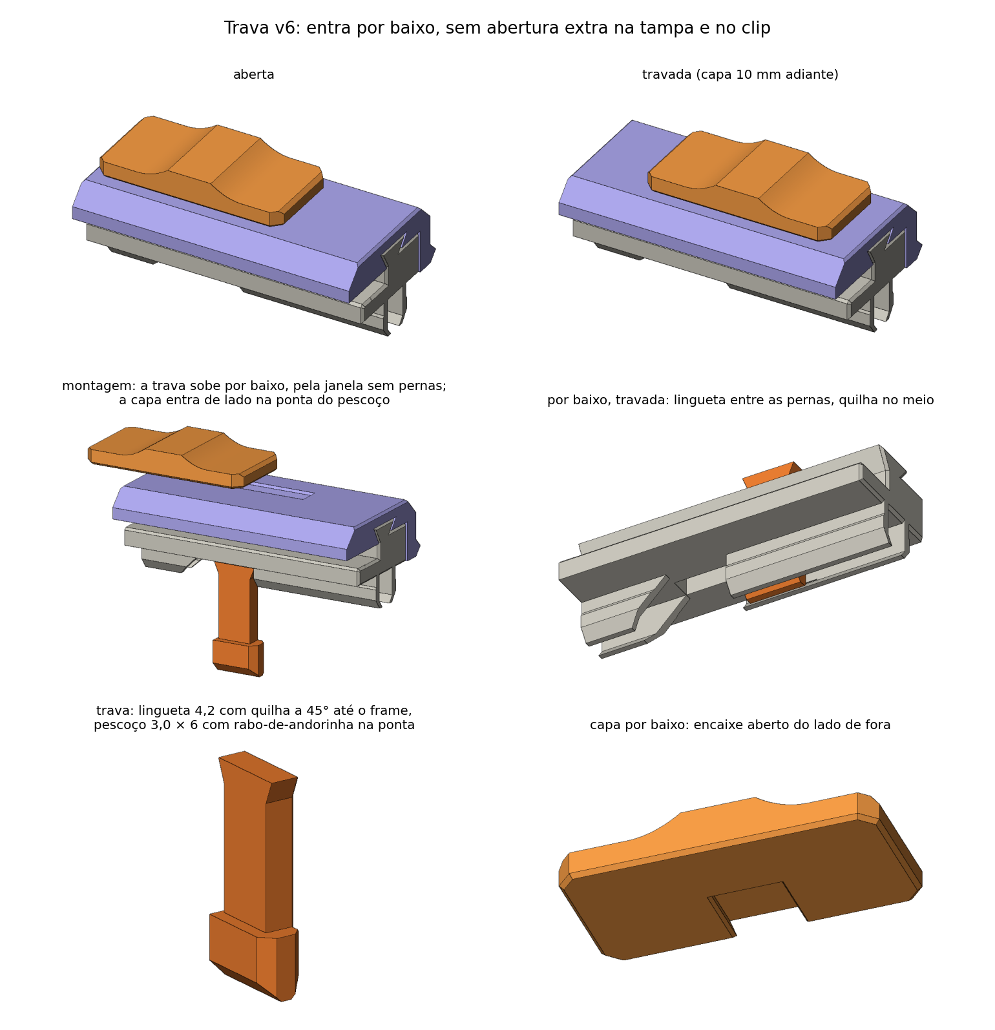
ideias-trava/trava-v6.png
