rhapsodyv/voron-panel-holder/ideias-trava/trava-v8-proposta.png

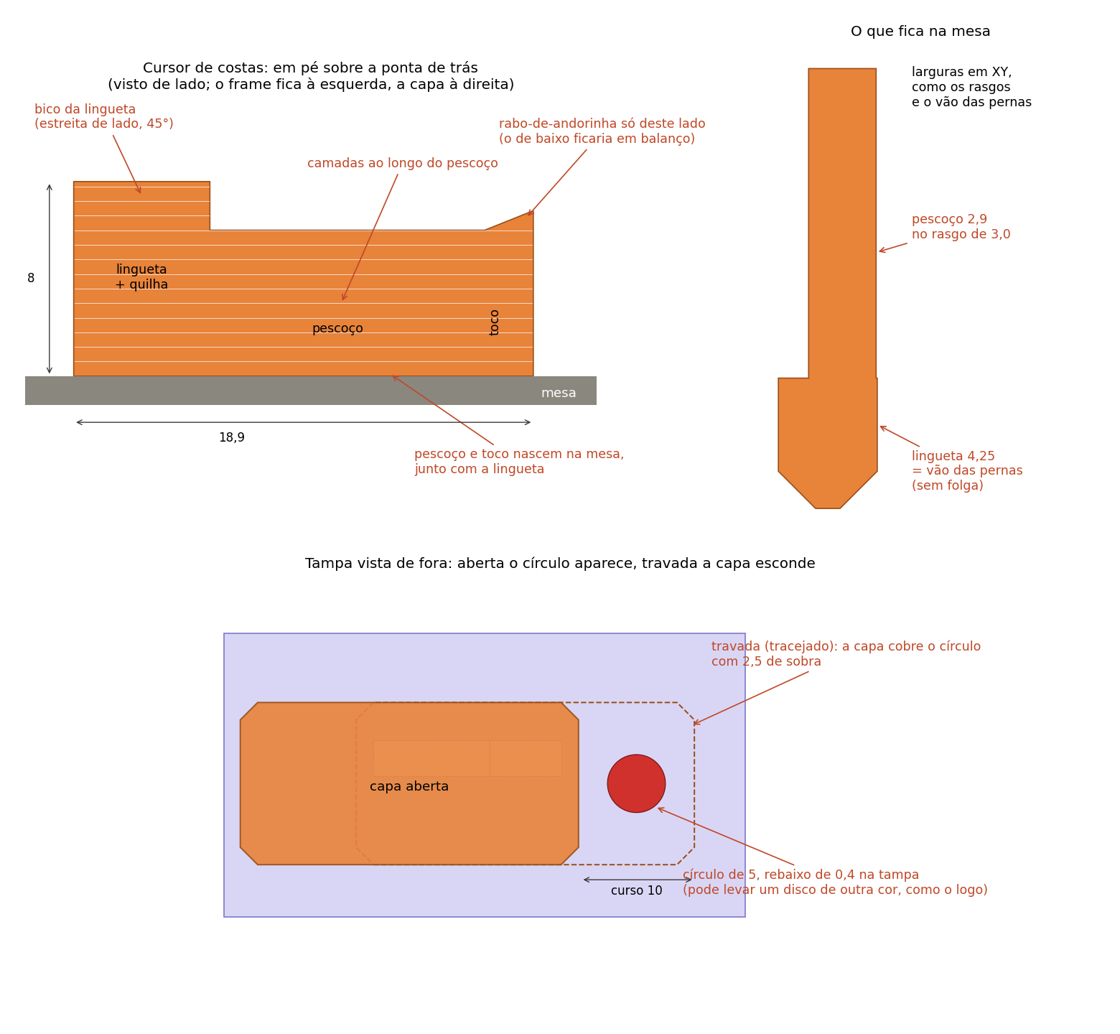
ideias-trava/trava-v8-proposta.png
