rhapsodyv/voron-panel-holder/ideias-trava/trava-v8.png

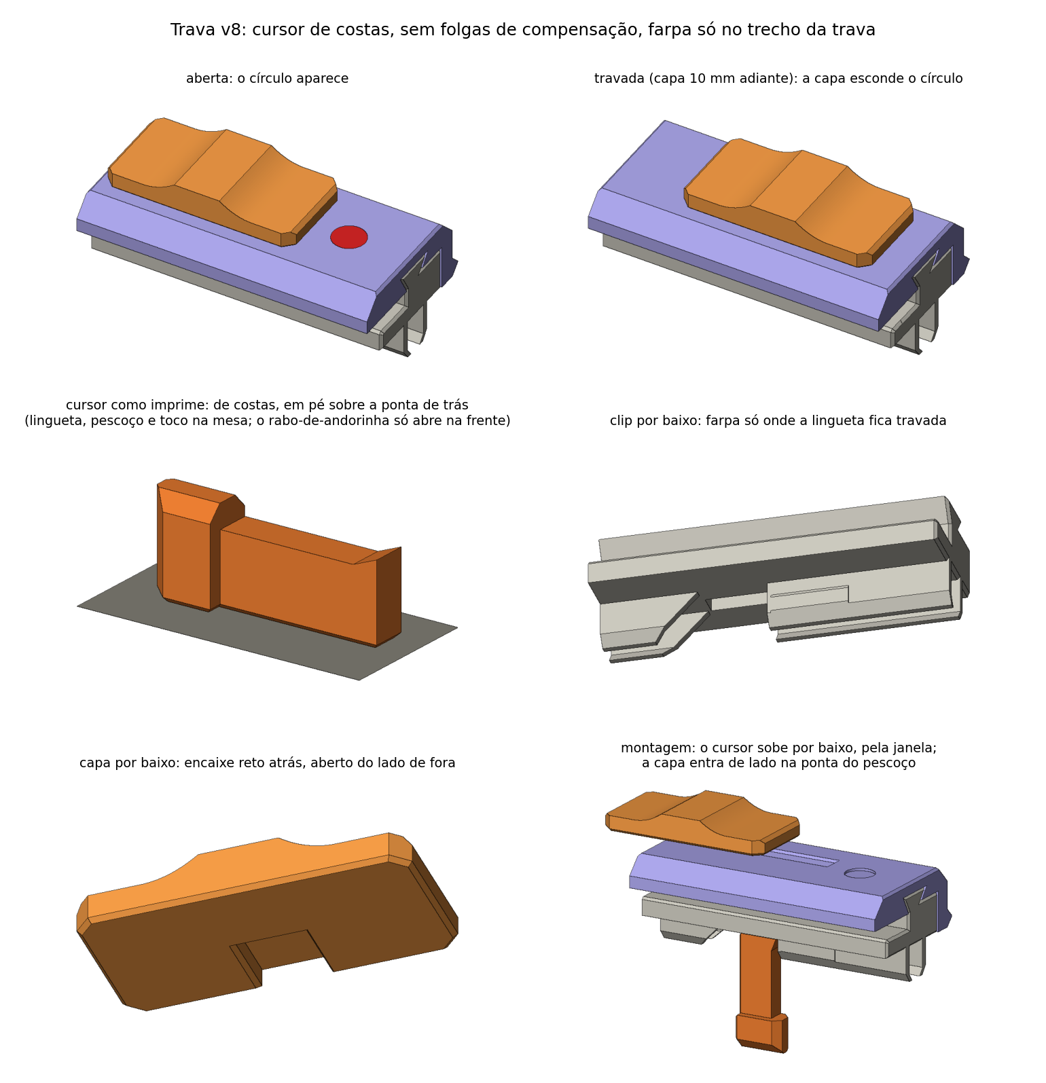
ideias-trava/trava-v8.png
