rhapsodyv/voron-panel-holder/ideias-trava/trava-v9-toco.png

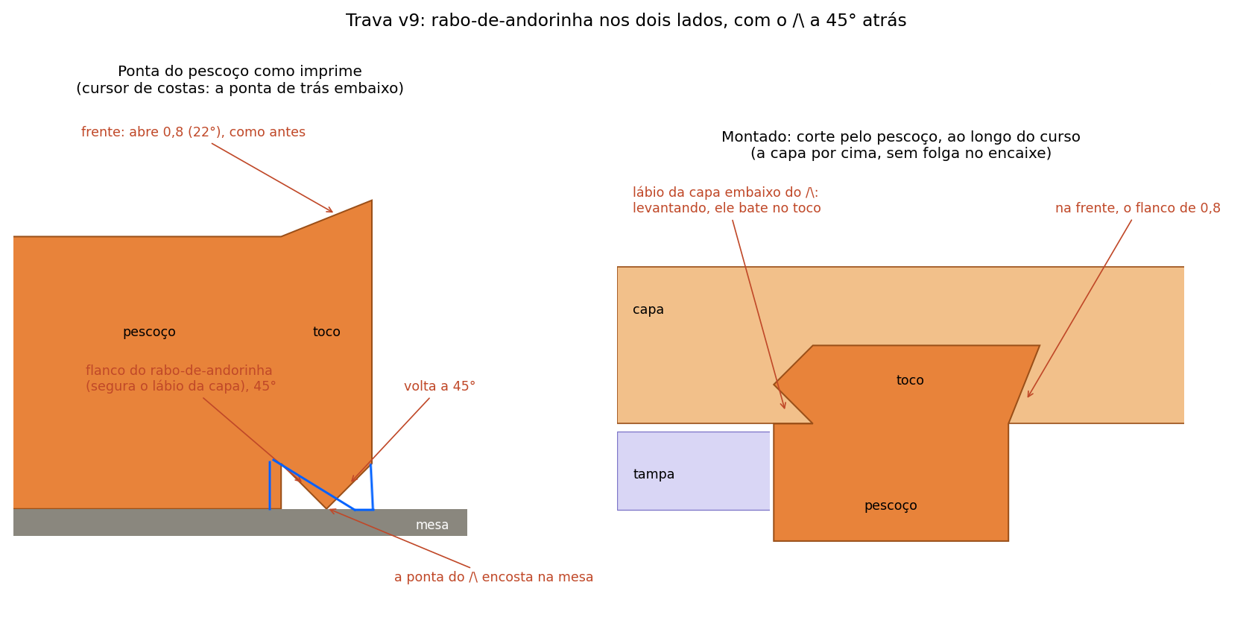
ideias-trava/trava-v9-toco.png
