rhapsodyv/voron-panel-holder/ideias-trava/trava-v11-capa.png

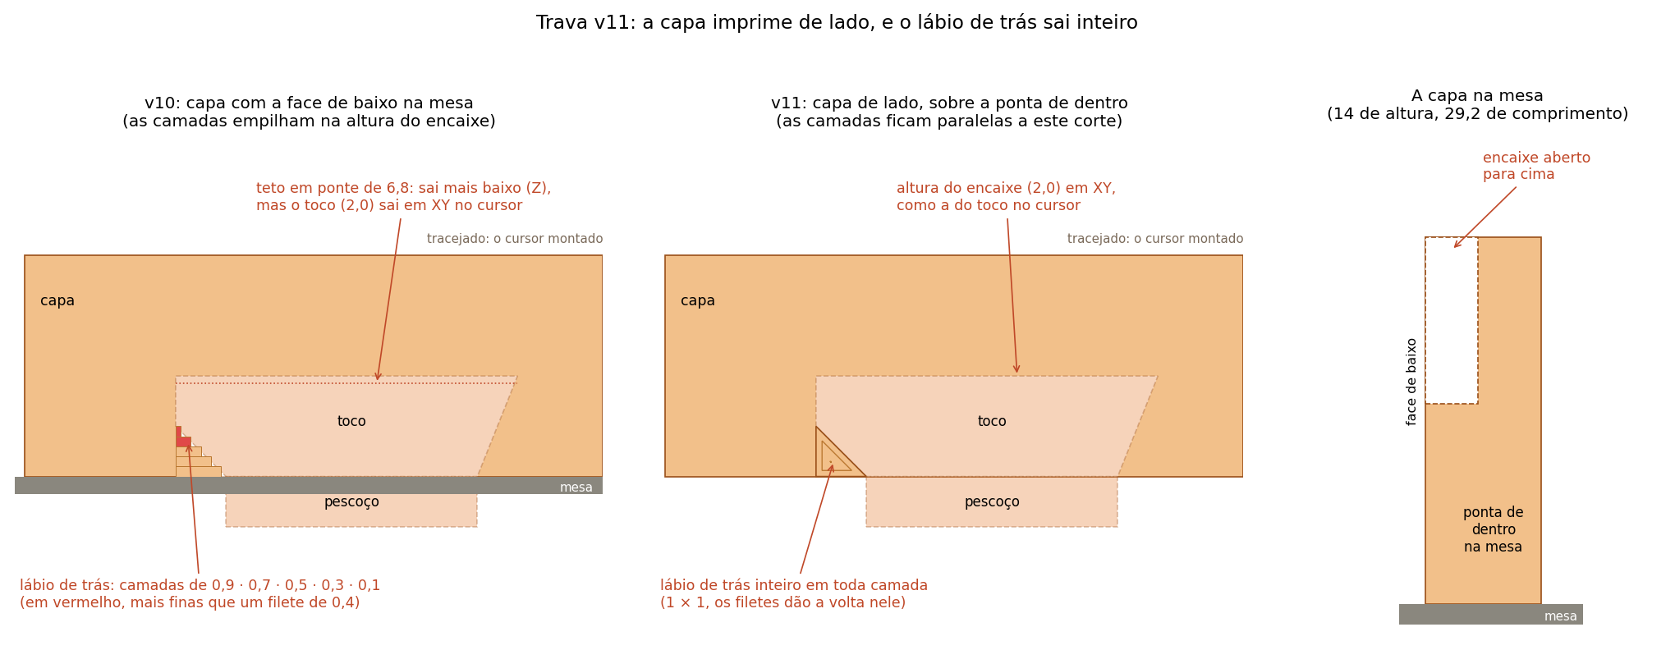
ideias-trava/trava-v11-capa.png
