rhapsodyv/voron-panel-holder/ideias-trava/trava-v13-labio.png

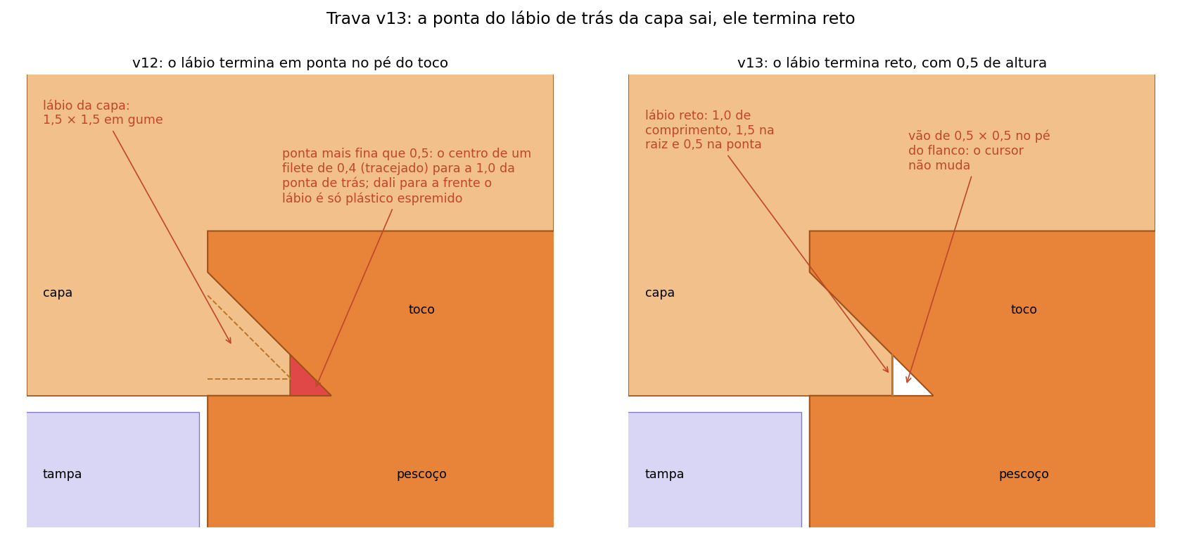
ideias-trava/trava-v13-labio.png
