rhapsodyv/voron-panel-holder/ideias-trava/trava-v14-orelha.png

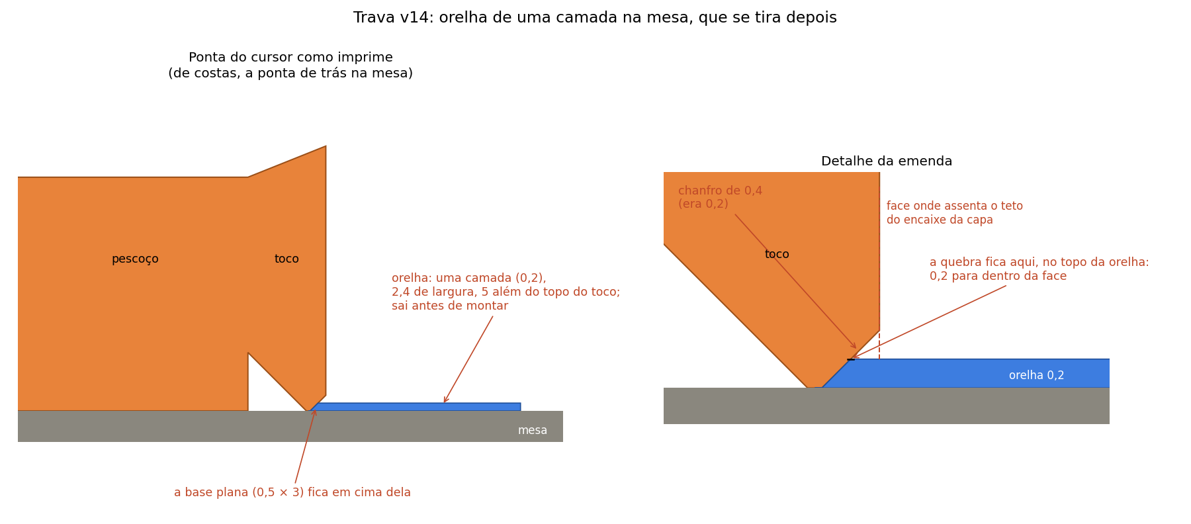
ideias-trava/trava-v14-orelha.png
