rhapsodyv/voron-panel-holder/ideias-trava/trava-v15-toco.png

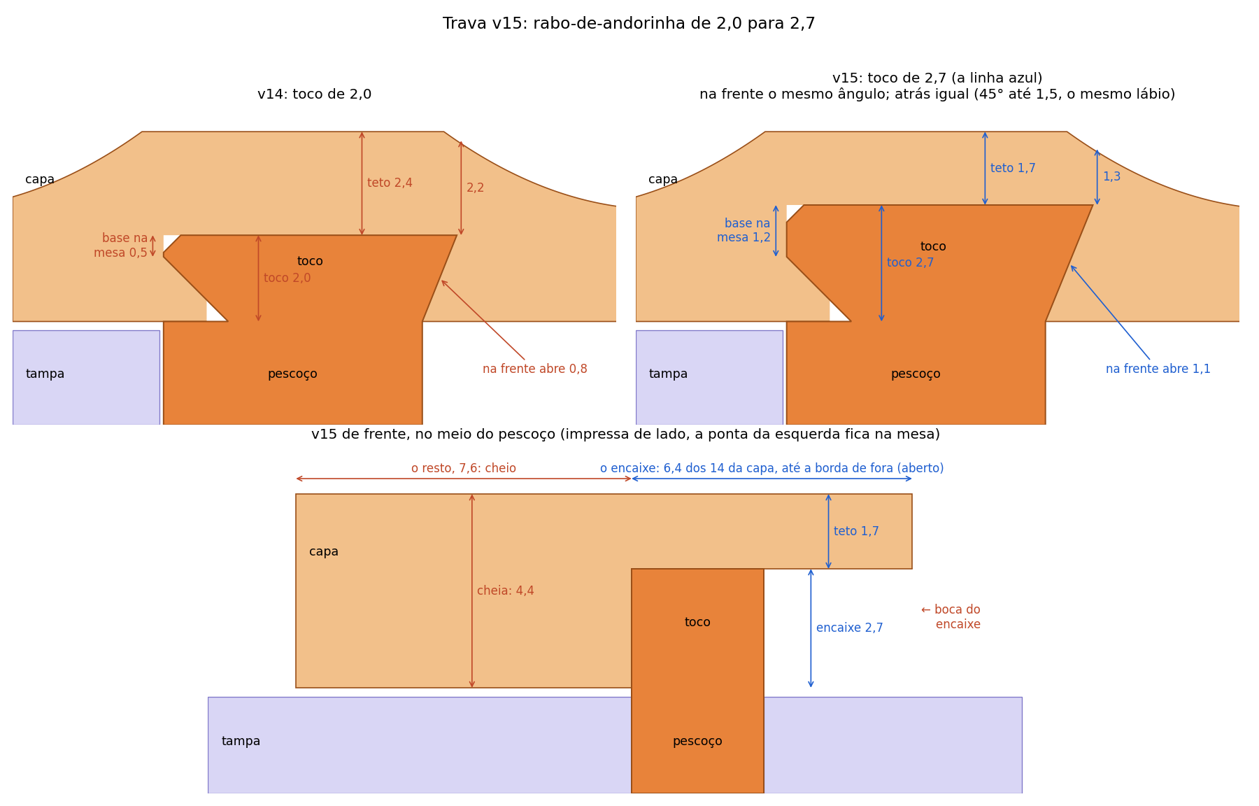
ideias-trava/trava-v15-toco.png
