rhapsodyv/voron-panel-holder/ideias-trava/trava-v16-pescoco.png

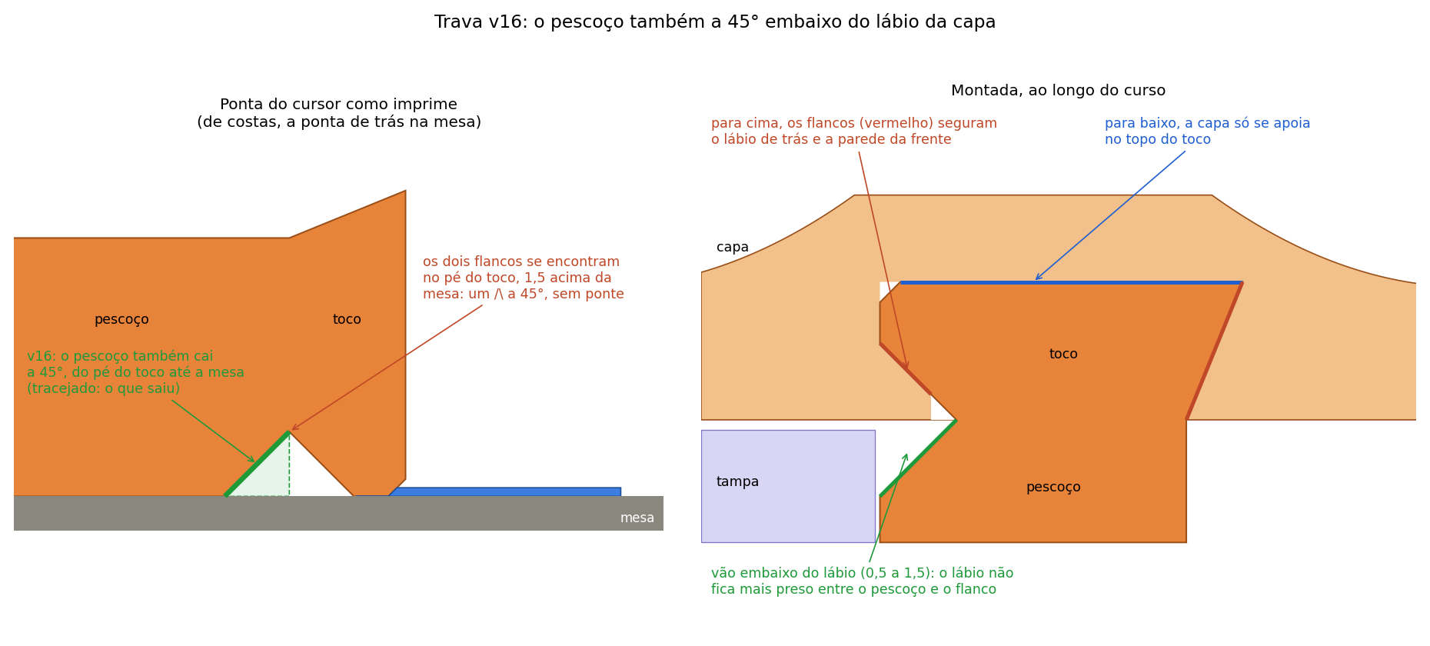
ideias-trava/trava-v16-pescoco.png
