rhapsodyv/voron-panel-holder/ideias-trava/travas-aparencia.png

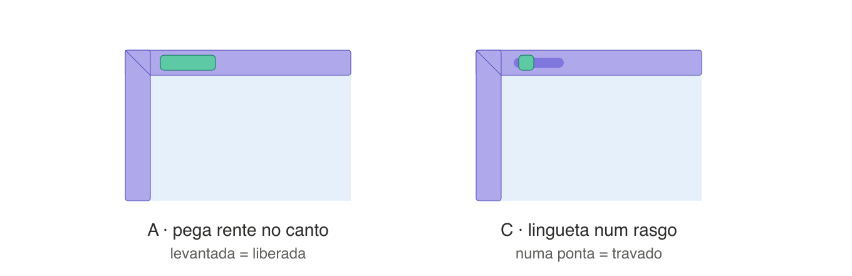
ideias-trava/travas-aparencia.png
