rhapsodyv/voron-panel-holder/ideias-trava/travas-estados.png

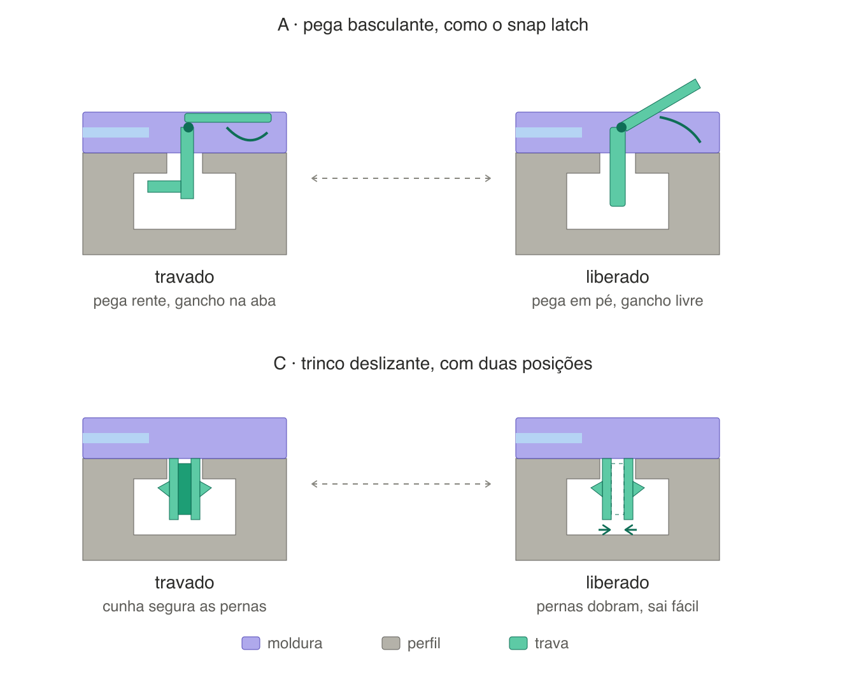
ideias-trava/travas-estados.png
