rhapsodyv/voron-panel-holder/ideias-trava/travas-mecanismo.png

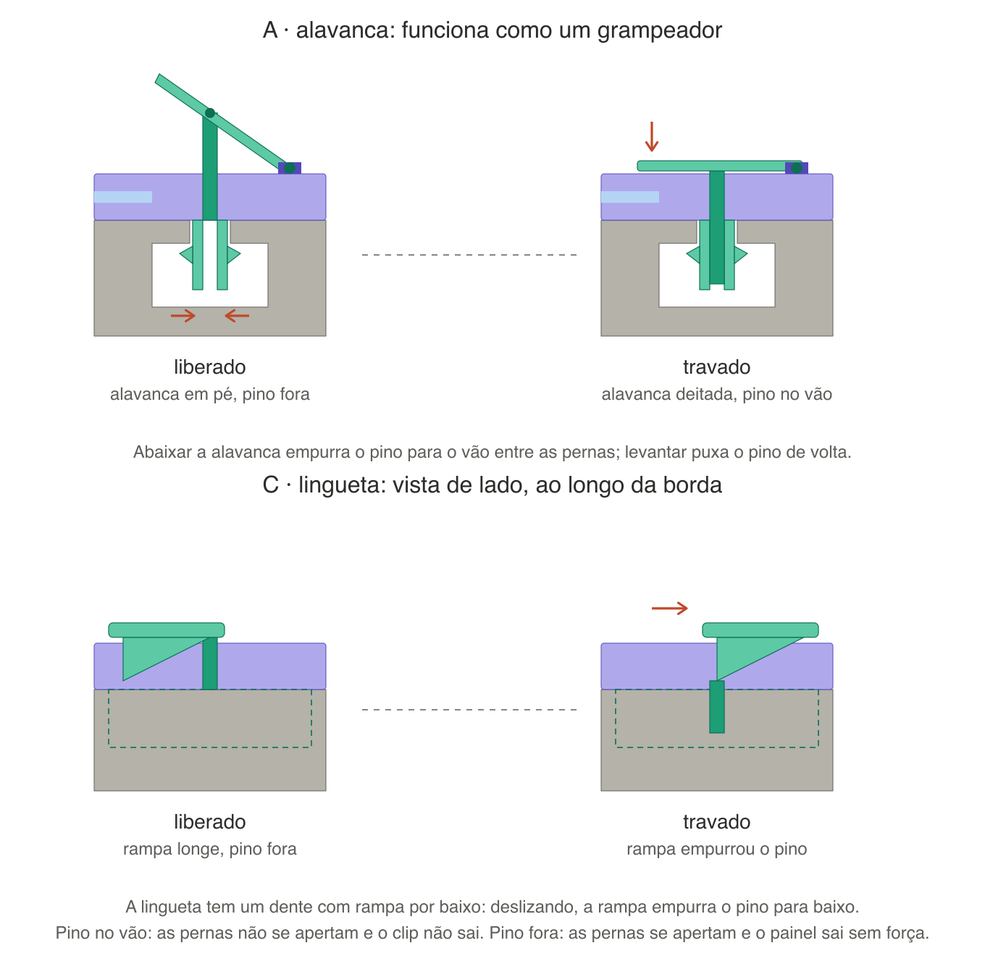
ideias-trava/travas-mecanismo.png
