rhapsodyv/voron-panel-holder/ideias-trava/travas-passos-a.png

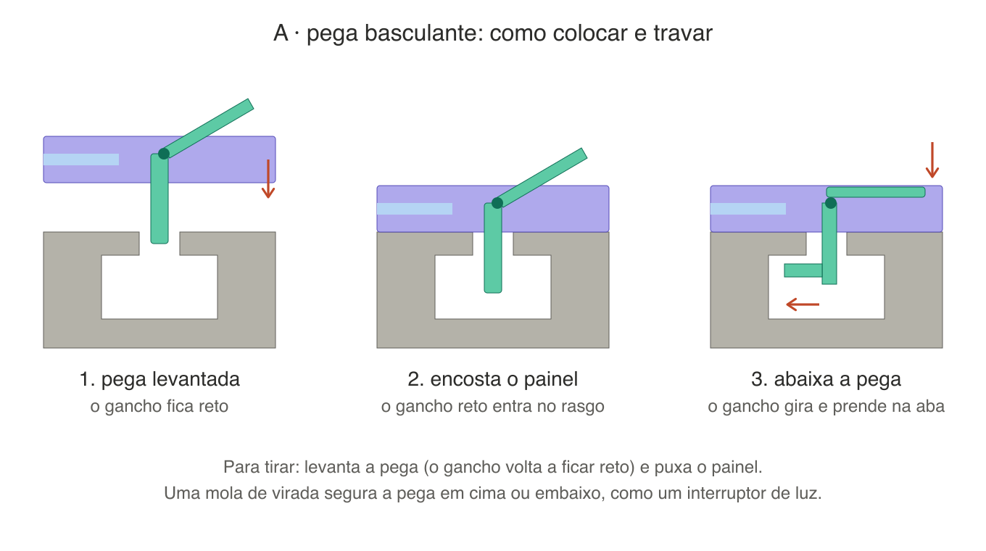
ideias-trava/travas-passos-a.png
