rhapsodyv/voron-panel-holder/ideias-trava/travas-passos-c.png

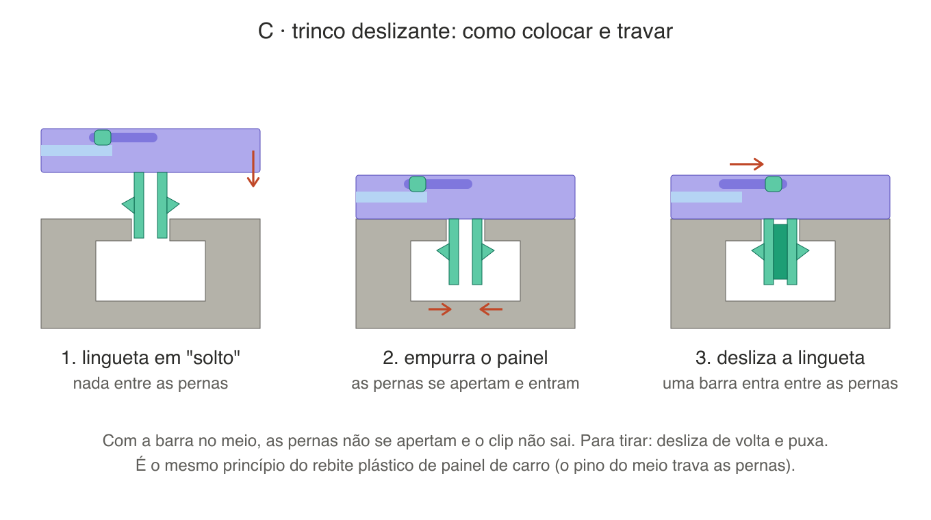
ideias-trava/travas-passos-c.png
