rhapsodyv/voron-panel-holder/ideias-trava/travas-trilho.png

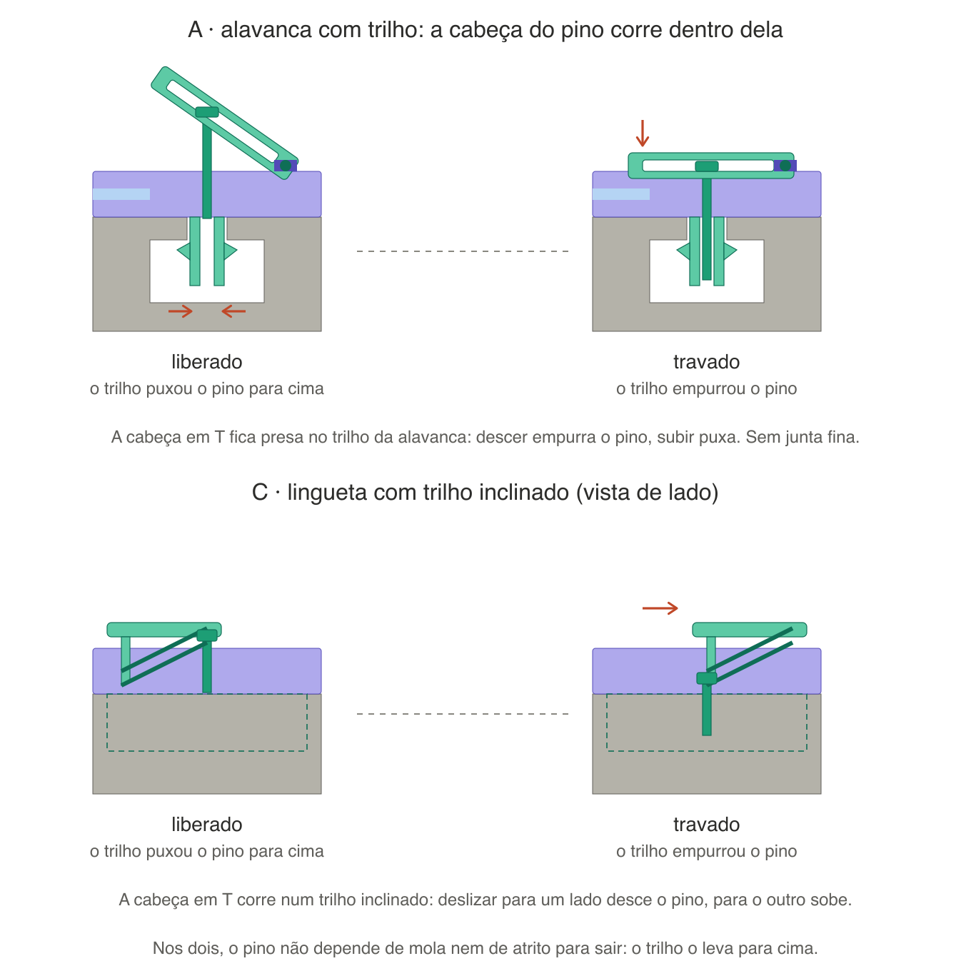
ideias-trava/travas-trilho.png
