rhapsodyv/voron-panel-holder/ideias-trava/v0-peca-unica-trava-v8.png

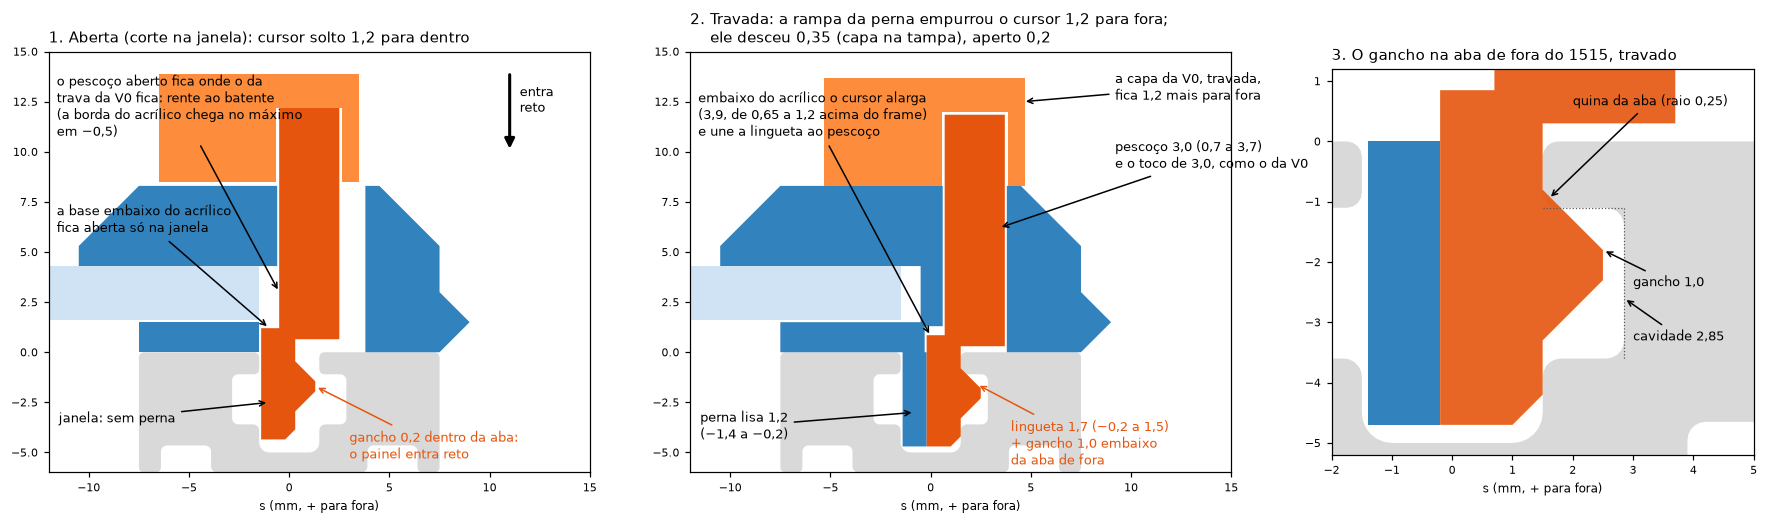
ideias-trava/v0-peca-unica-trava-v8.png
