rhapsodyv/voron-panel-holder/leitura-secao.png

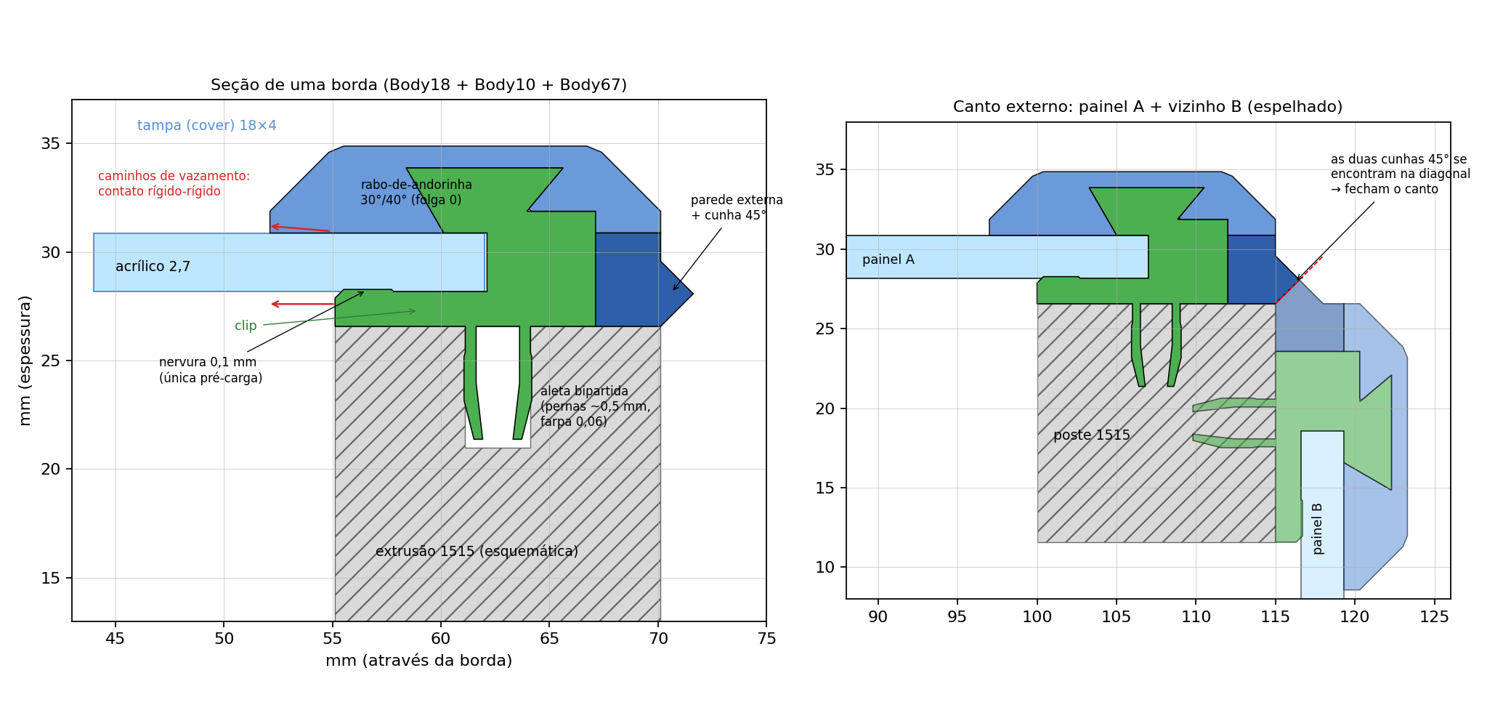
leitura-secao.png
