rhapsodyv/voron-panel-holder/perfil-2020.png

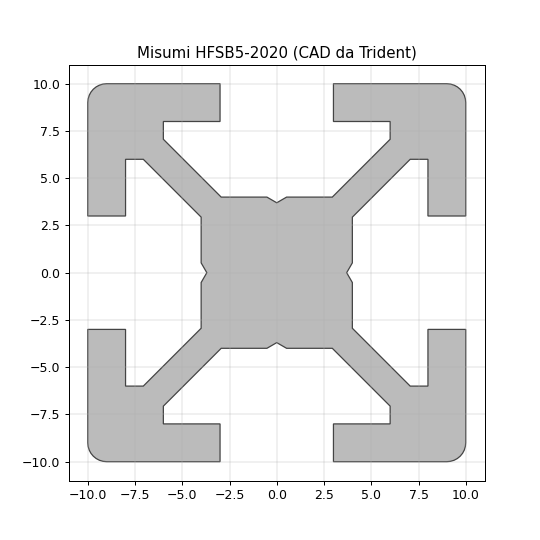
perfil-2020.png
