rhapsodyv/voron-panel-holder/traseira-proposta.png

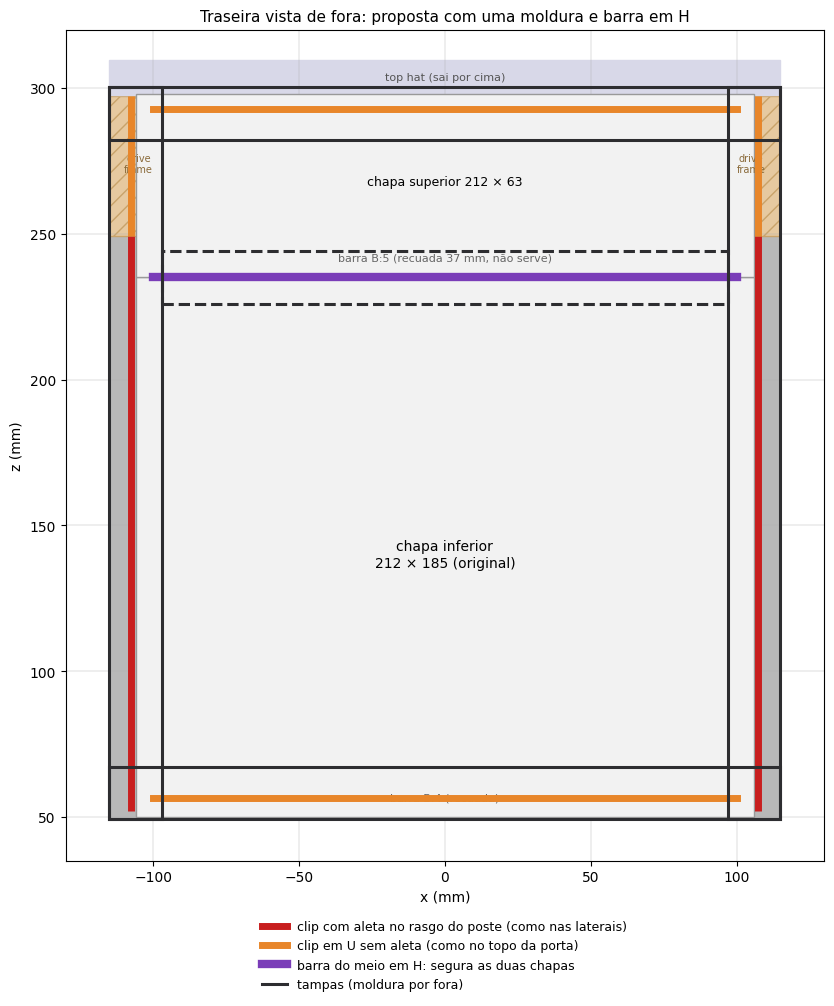
traseira-proposta.png
