rhapsodyv/voron-panel-holder/trident-350-v1.png

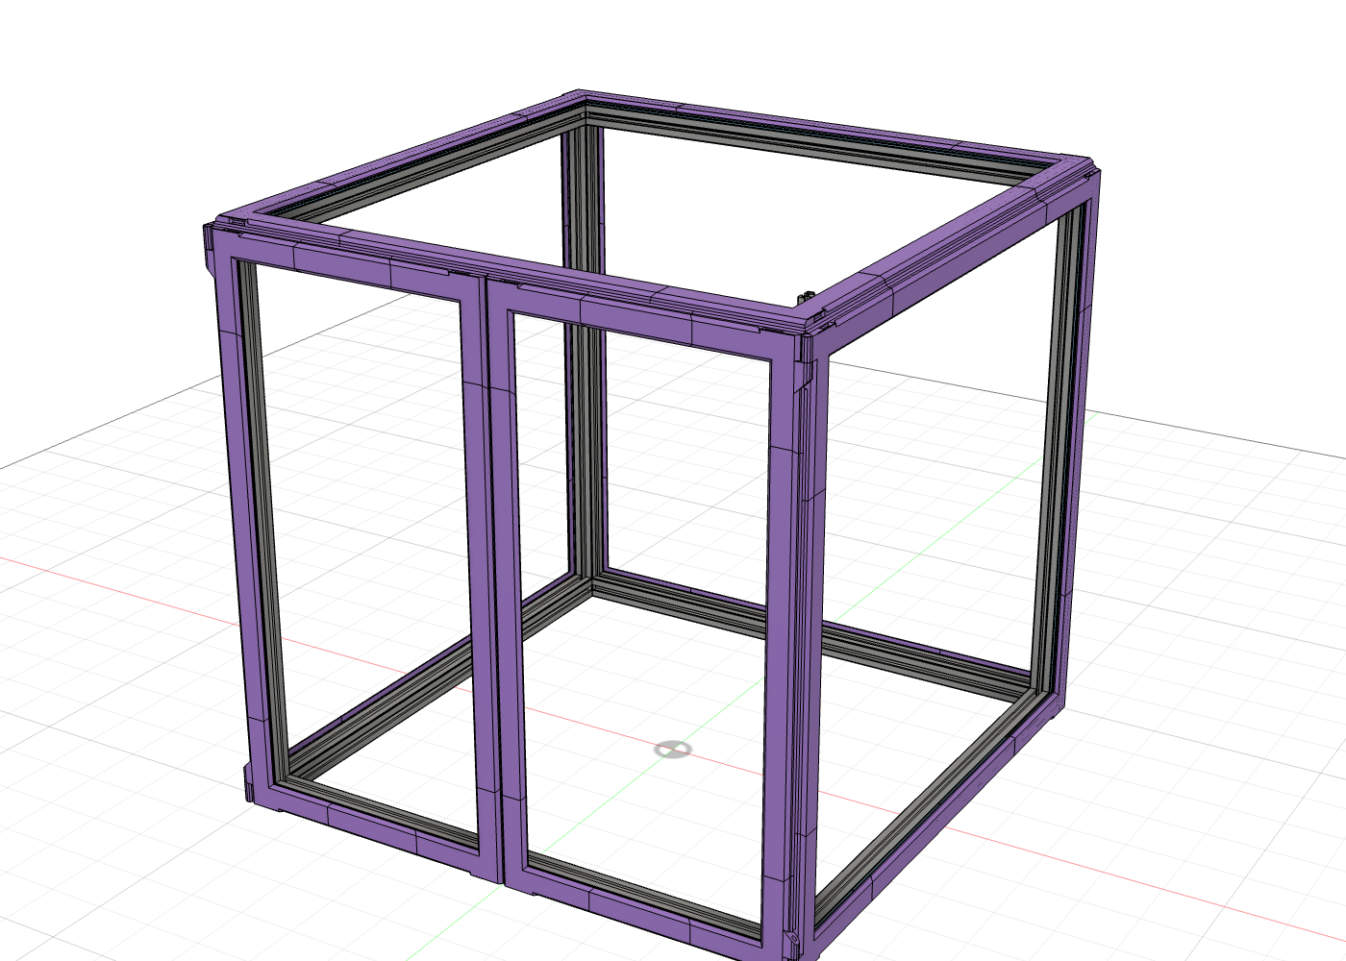
trident-350-v1.png
