rhapsodyv/voron-panel-holder/trident-alivio-pernas.png

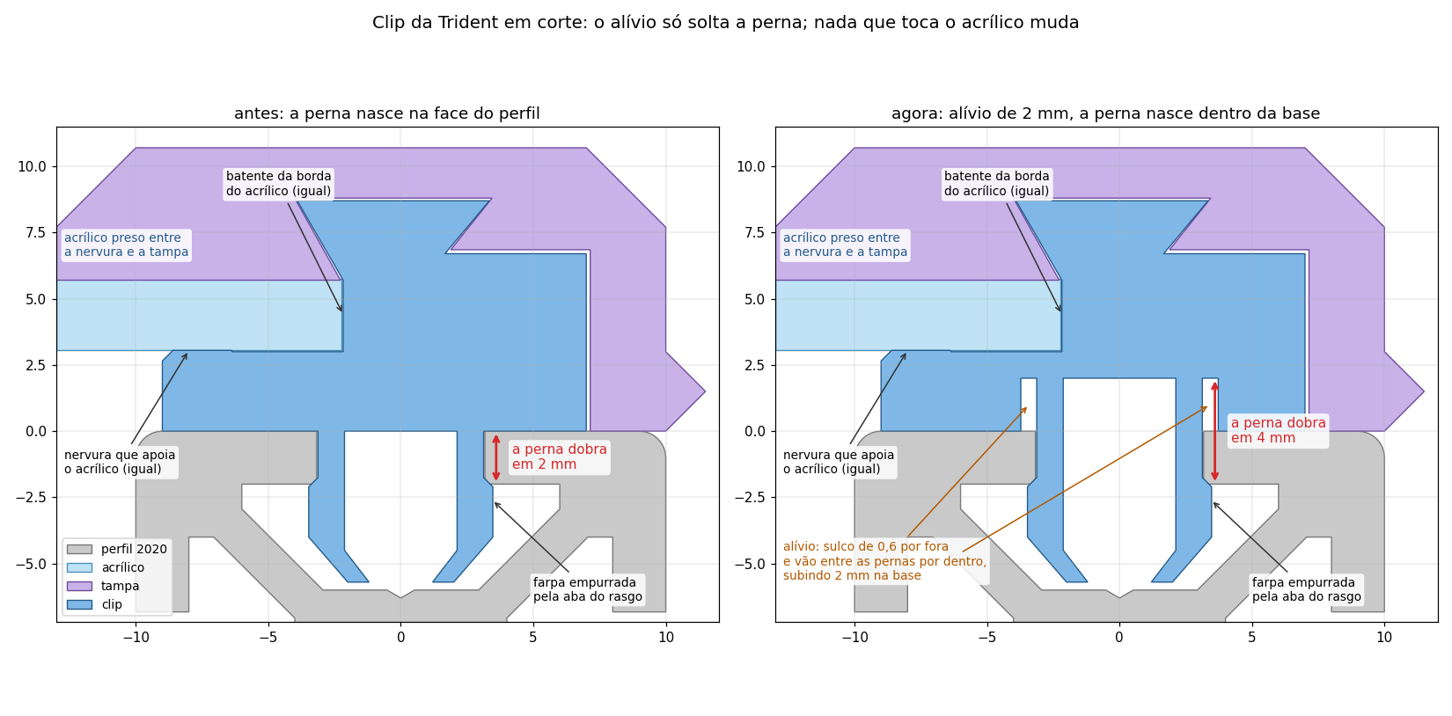
trident-alivio-pernas.png
