rhapsodyv/voron-panel-holder/trident-dobradica-giro.png

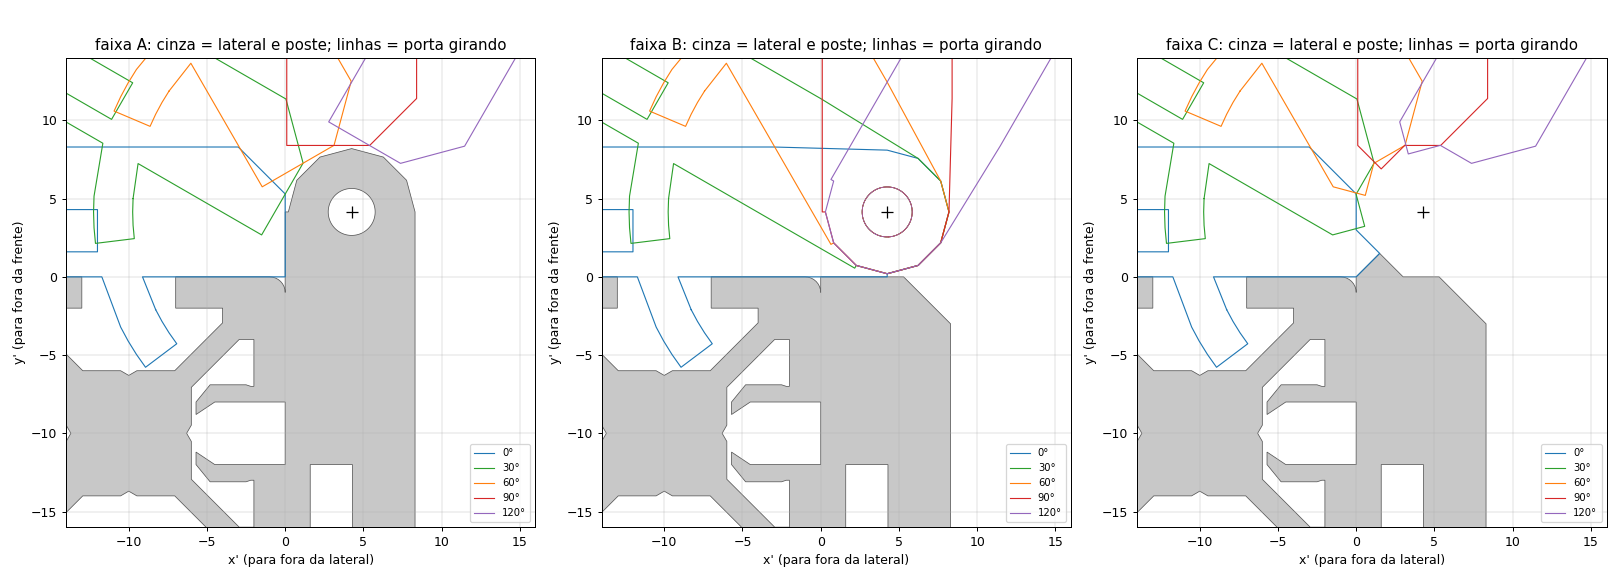
trident-dobradica-giro.png
