rhapsodyv/voron-panel-holder/trident-farpa-cunha.png

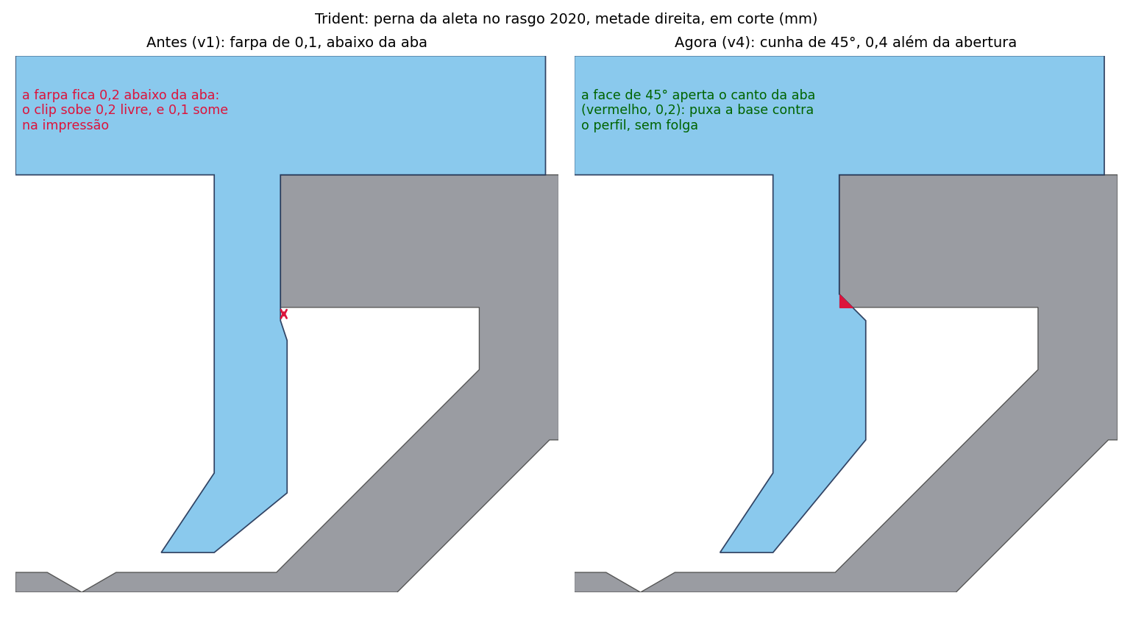
trident-farpa-cunha.png
