rhapsodyv/voron-panel-holder/trident-passa-bowden.png

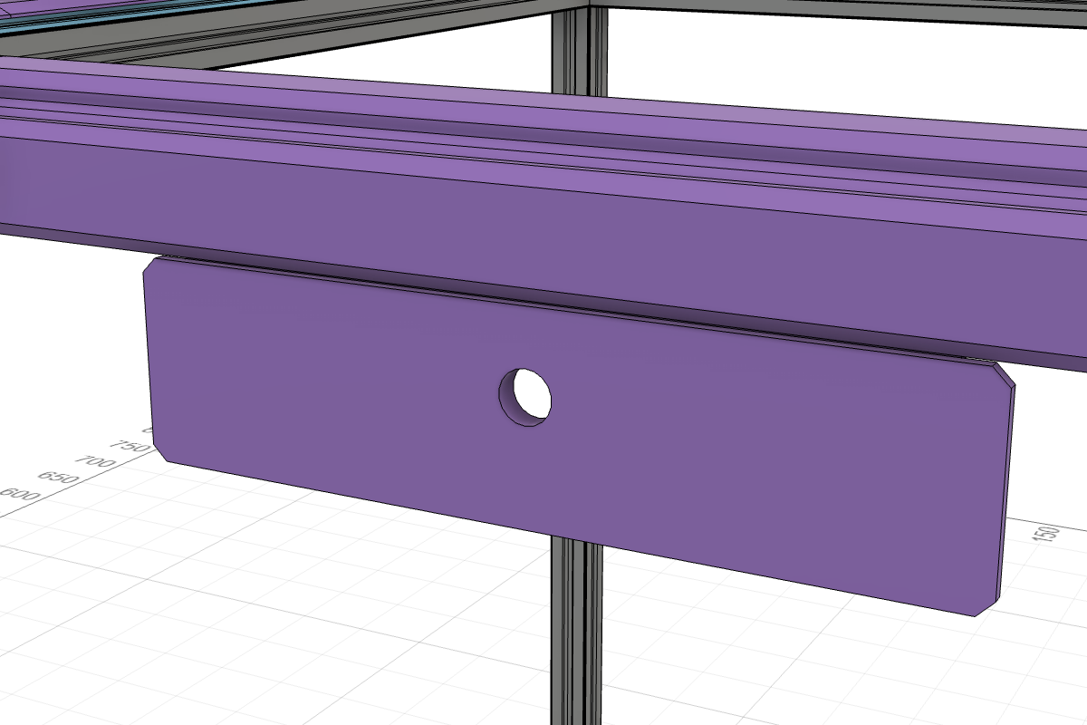
trident-passa-bowden.png
