rhapsodyv/voron-panel-holder/trident-portas-centro.png

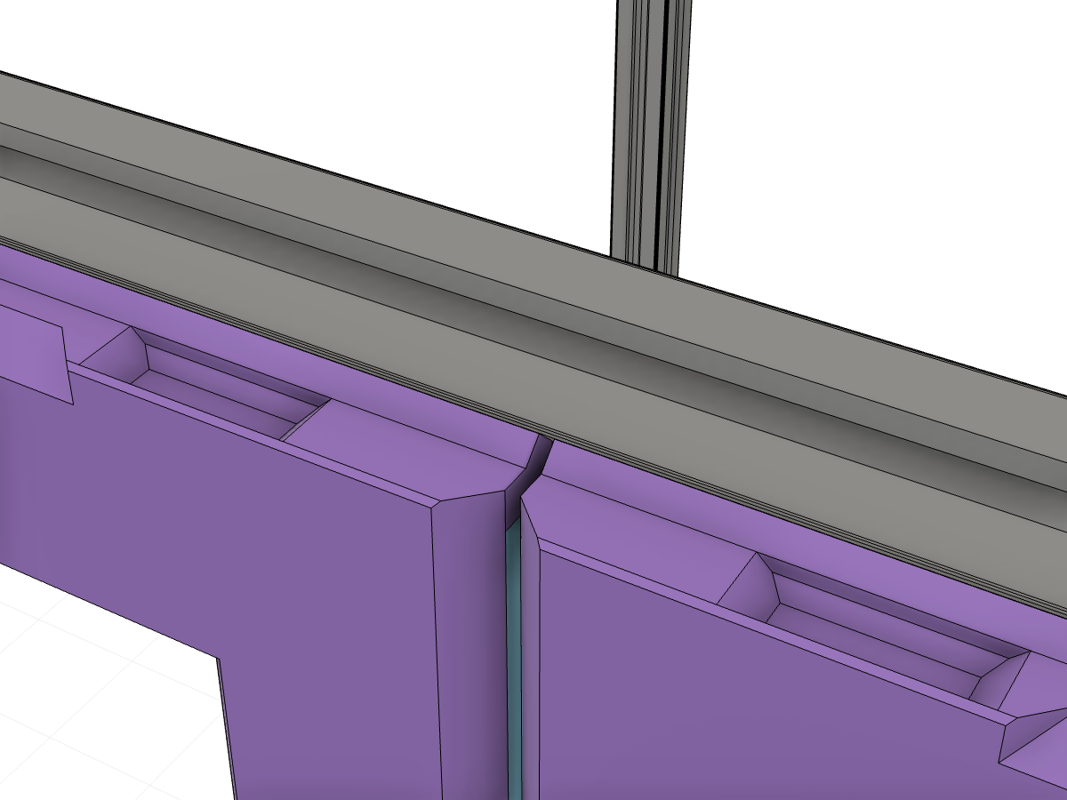
trident-portas-centro.png
