rhapsodyv/voron-panel-holder/trident-provas-v1.png

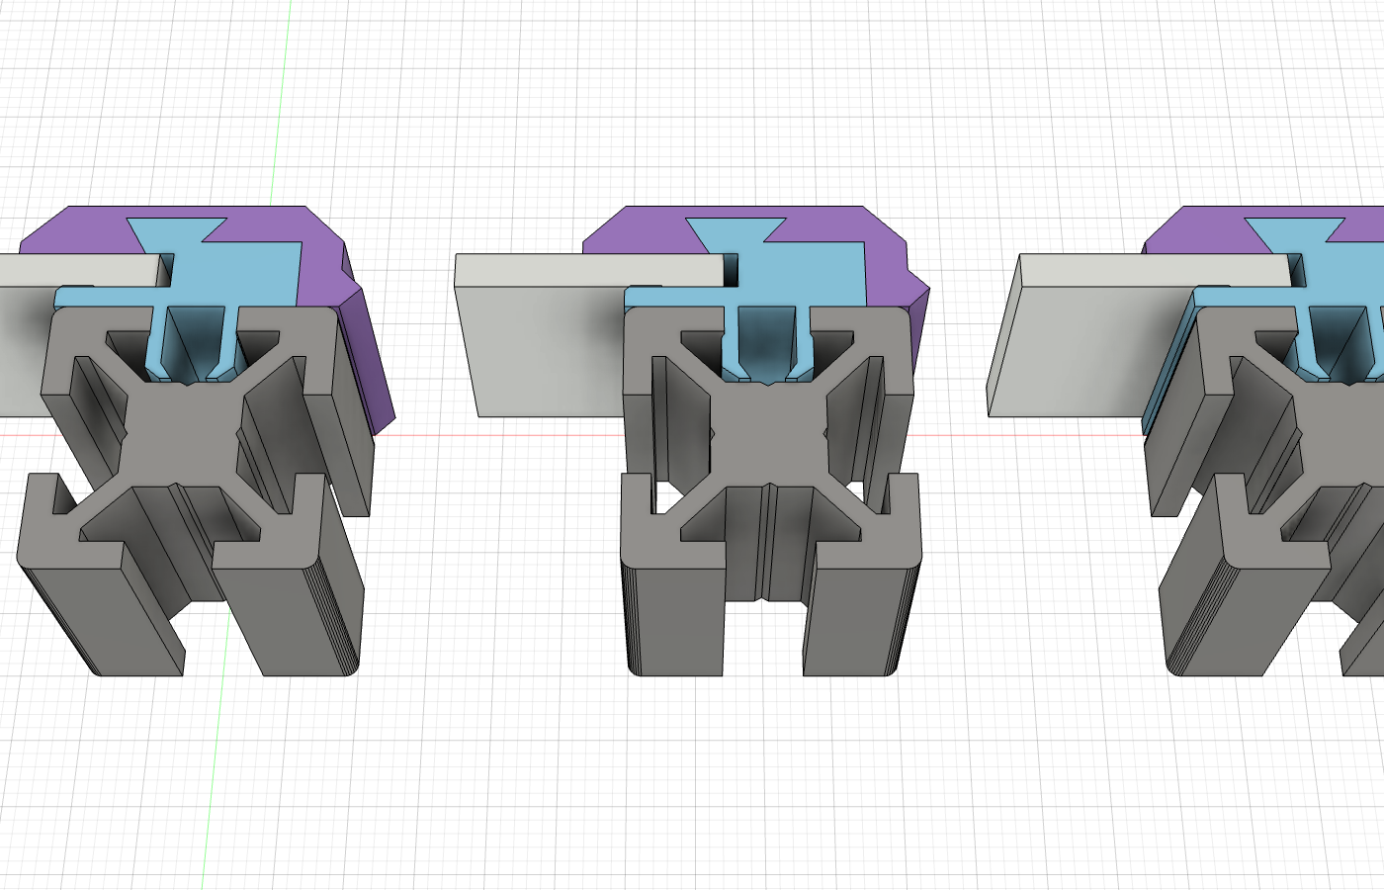
trident-provas-v1.png
