rhapsodyv/voron-panel-holder/trident-puxador-opcoes.png

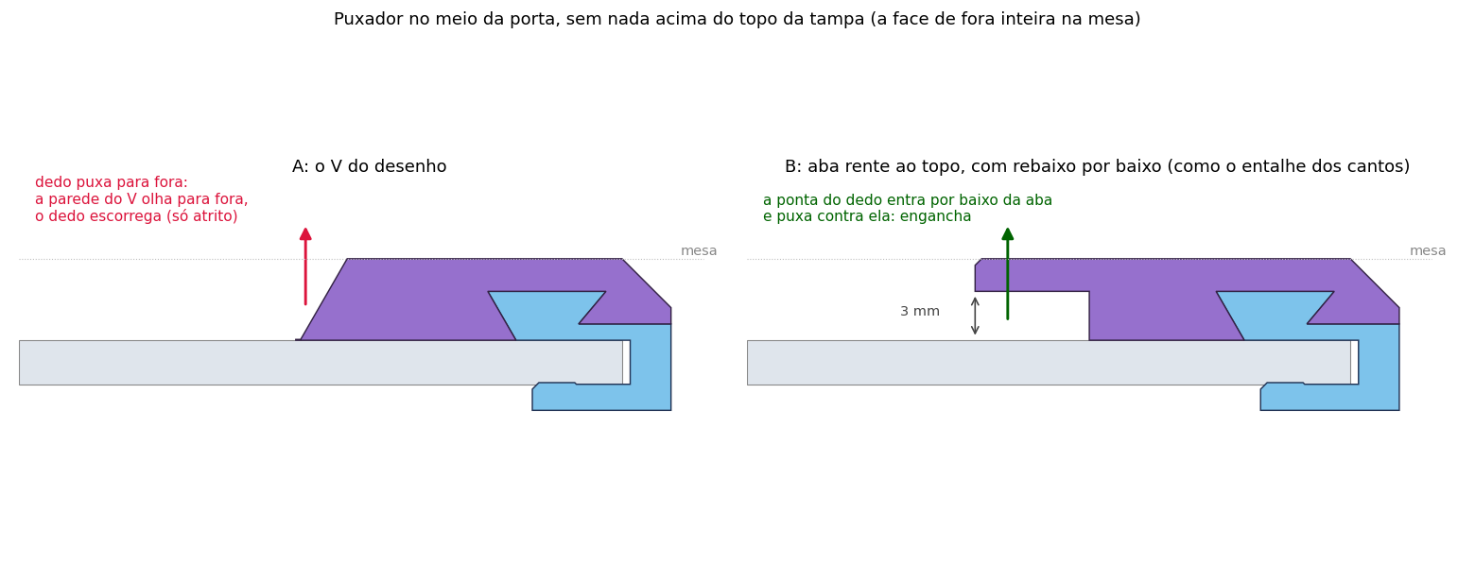
trident-puxador-opcoes.png
