rhapsodyv/voron-panel-holder/trident-puxador-proposta.png

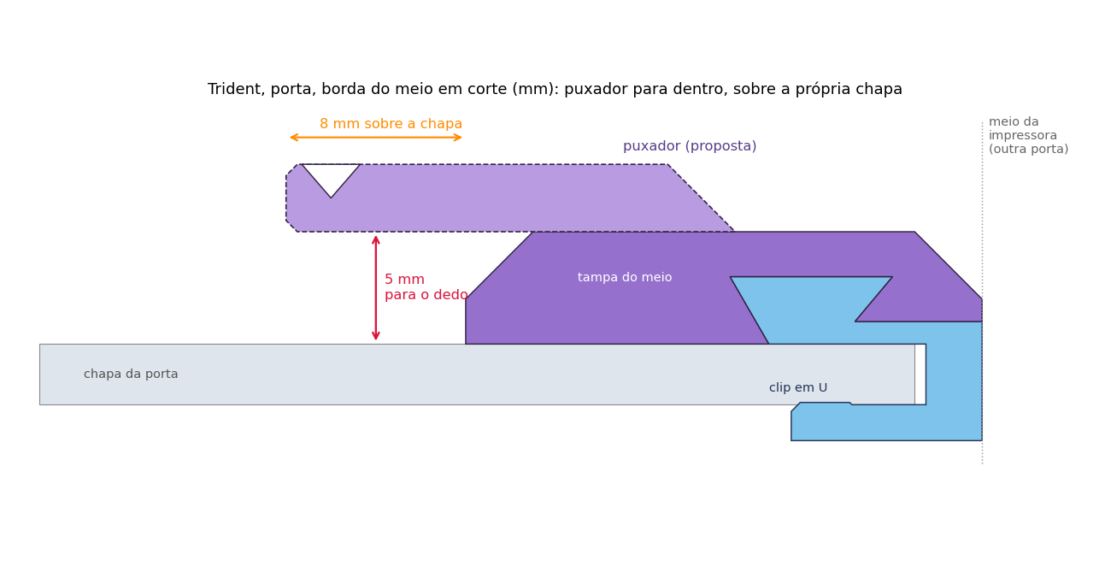
trident-puxador-proposta.png
