rhapsodyv/voron-panel-holder/trident-puxador.png

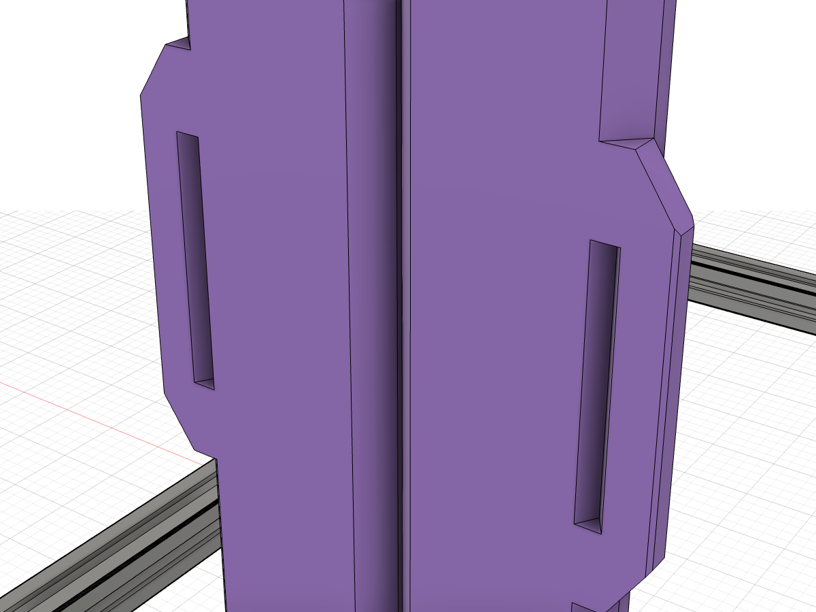
trident-puxador.png
