rhapsodyv/voron-panel-holder/trident-tampa-mais-alta.png

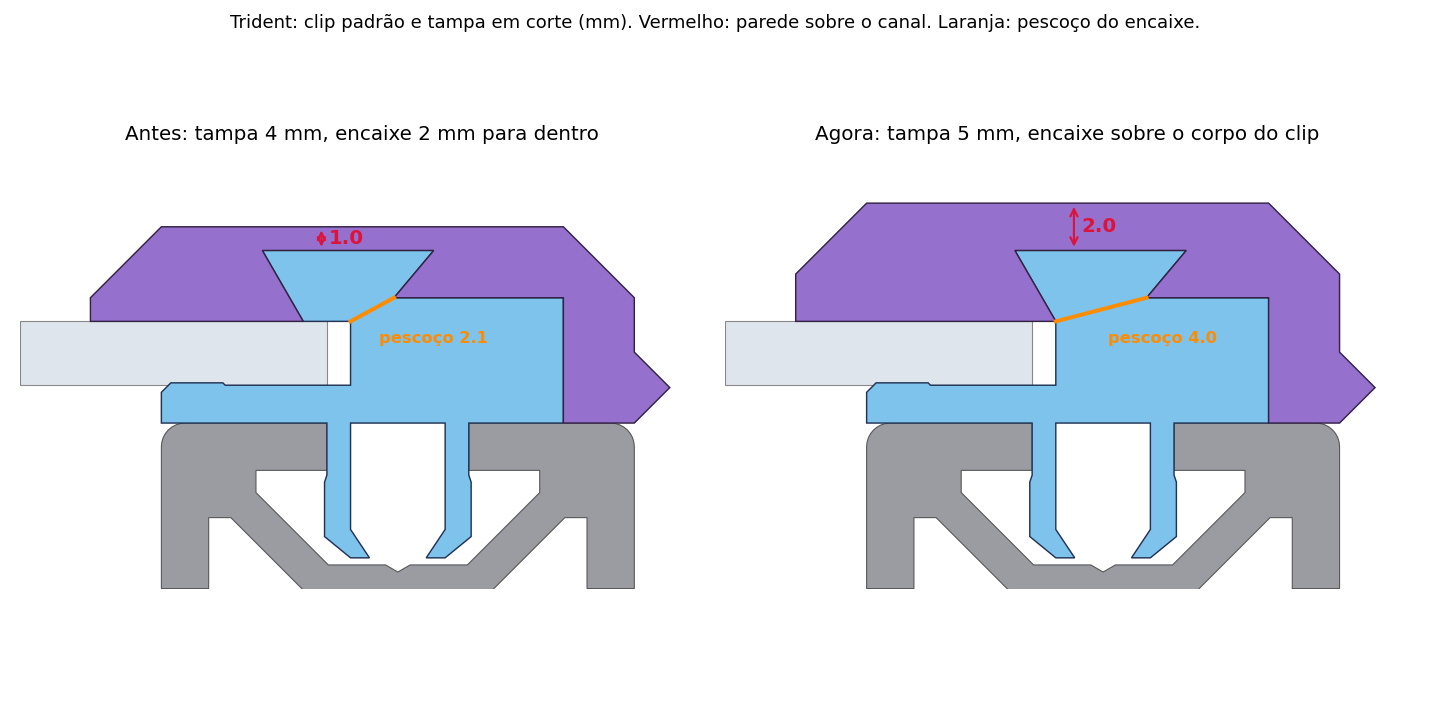
trident-tampa-mais-alta.png
