rhapsodyv/voron-panel-holder/v12-dobradica-3d.png

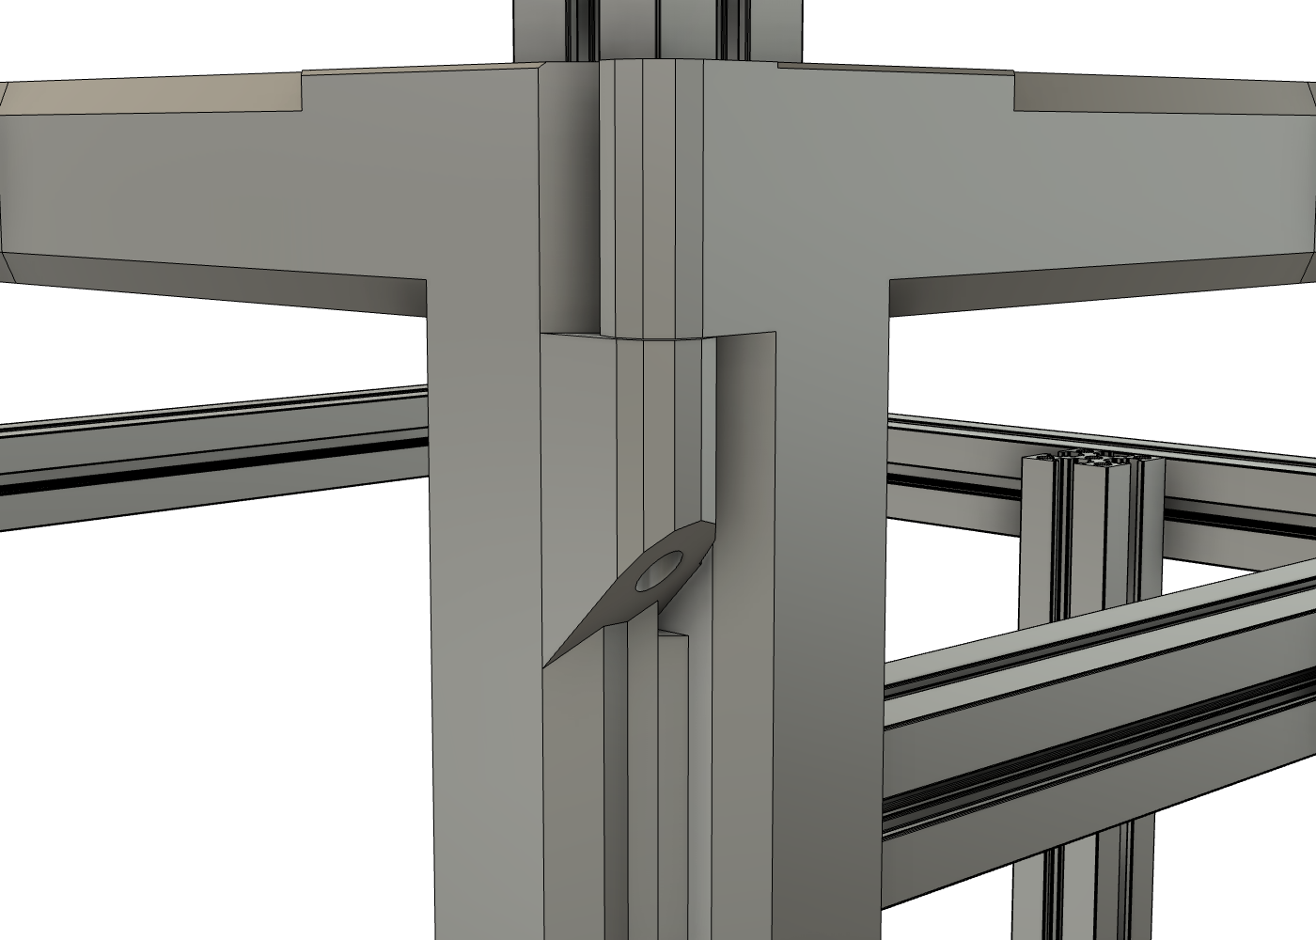
v12-dobradica-3d.png
