rhapsodyv/voron-panel-holder/v12-dobradica-giro.png

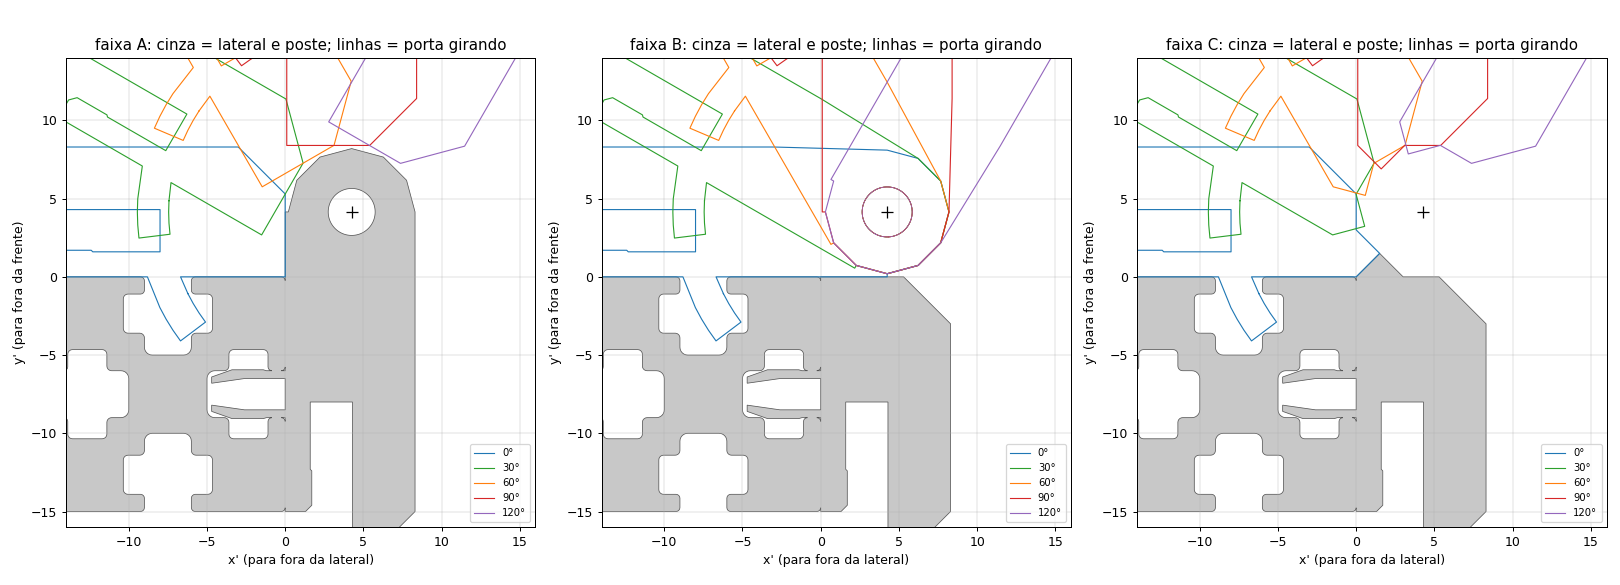
v12-dobradica-giro.png
