rhapsodyv/voron-panel-holder/v12-fase4-entalhe-lado.png

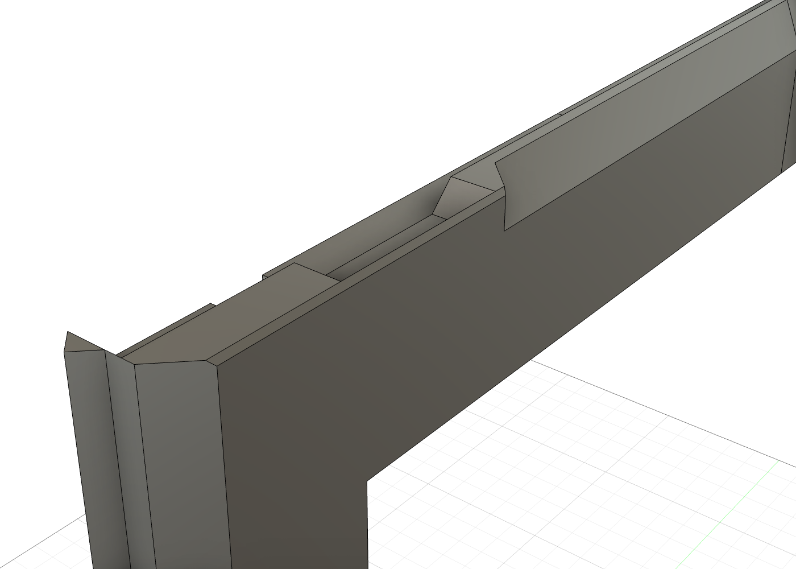
v12-fase4-entalhe-lado.png
