rhapsodyv/voron-panel-holder/v12-fase4-entalhe-topo.png

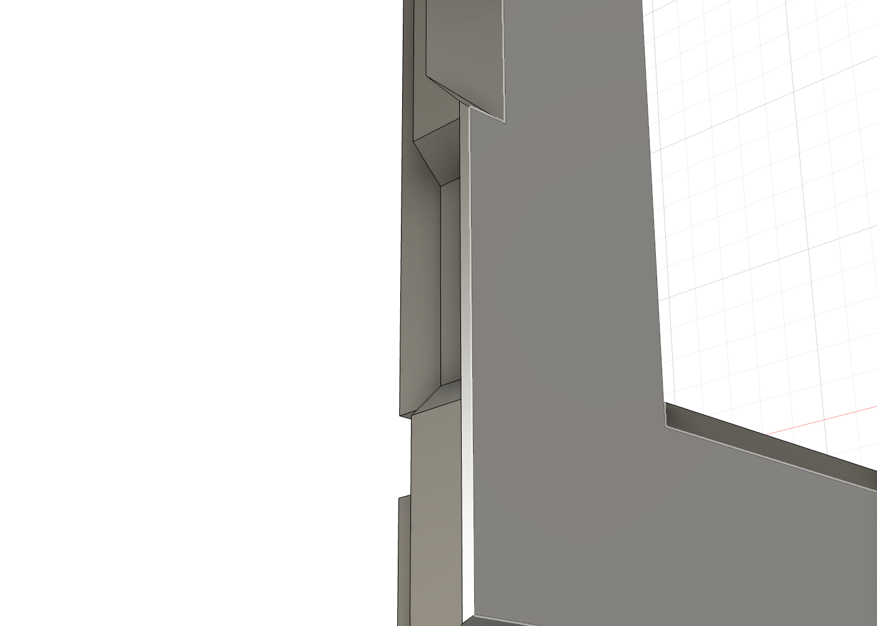
v12-fase4-entalhe-topo.png
