rhapsodyv/voron-panel-holder/v12-fusion-conjuntos.png

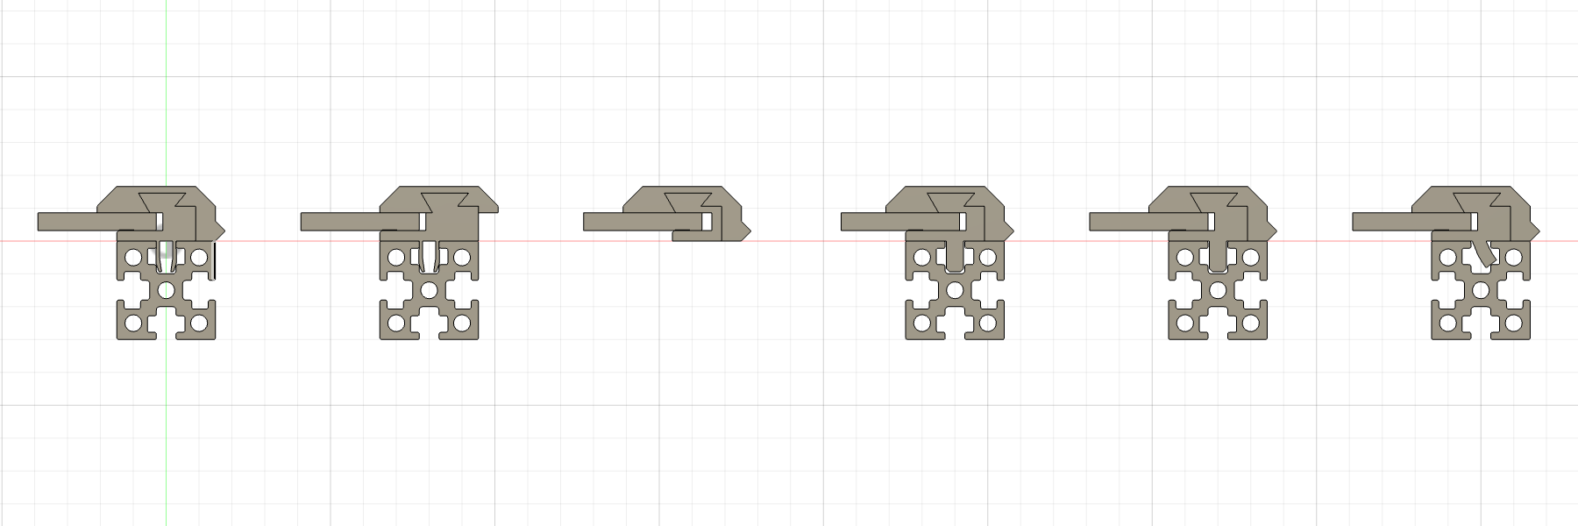
v12-fusion-conjuntos.png
