rhapsodyv/voron-panel-holder/v12-perfis-local.png

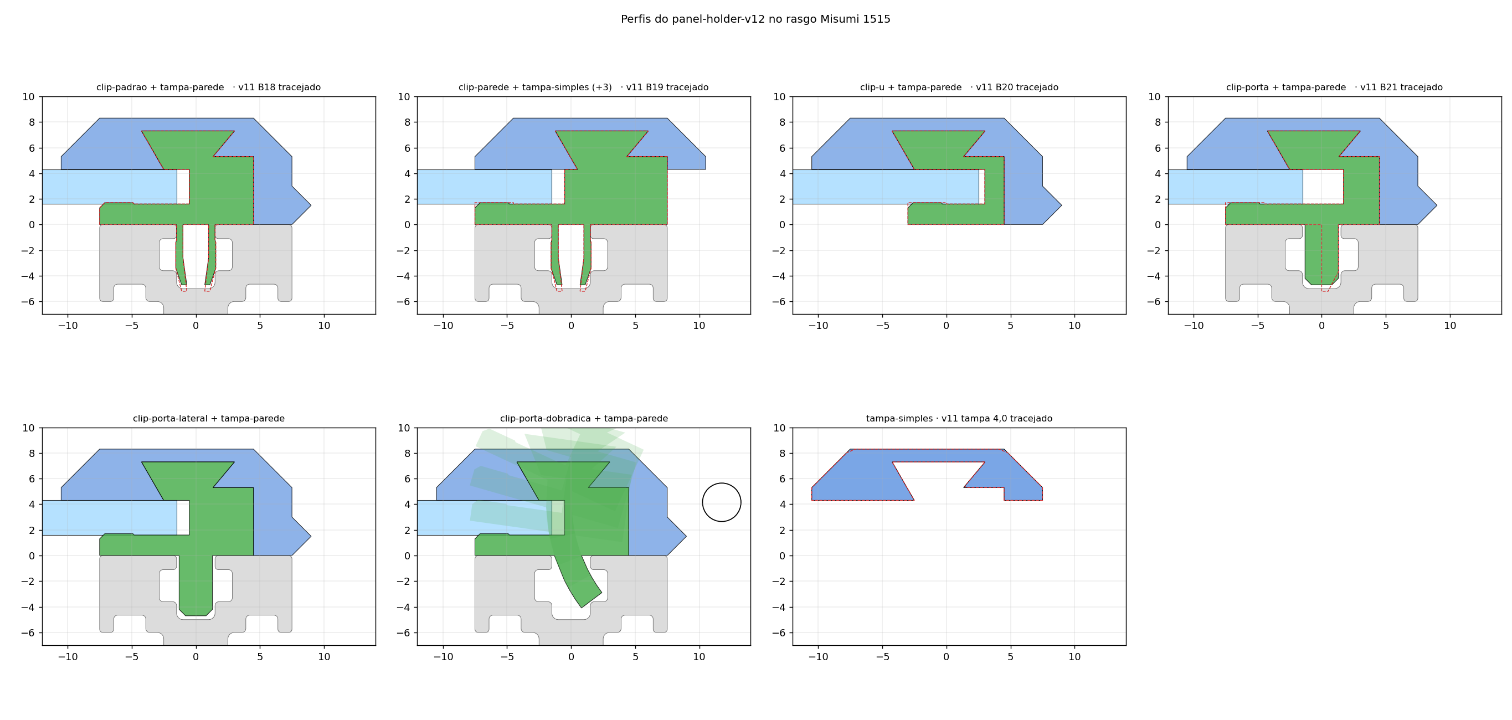
v12-perfis-local.png
