rhapsodyv/voron-panel-holder/v12-puxador-3d.png

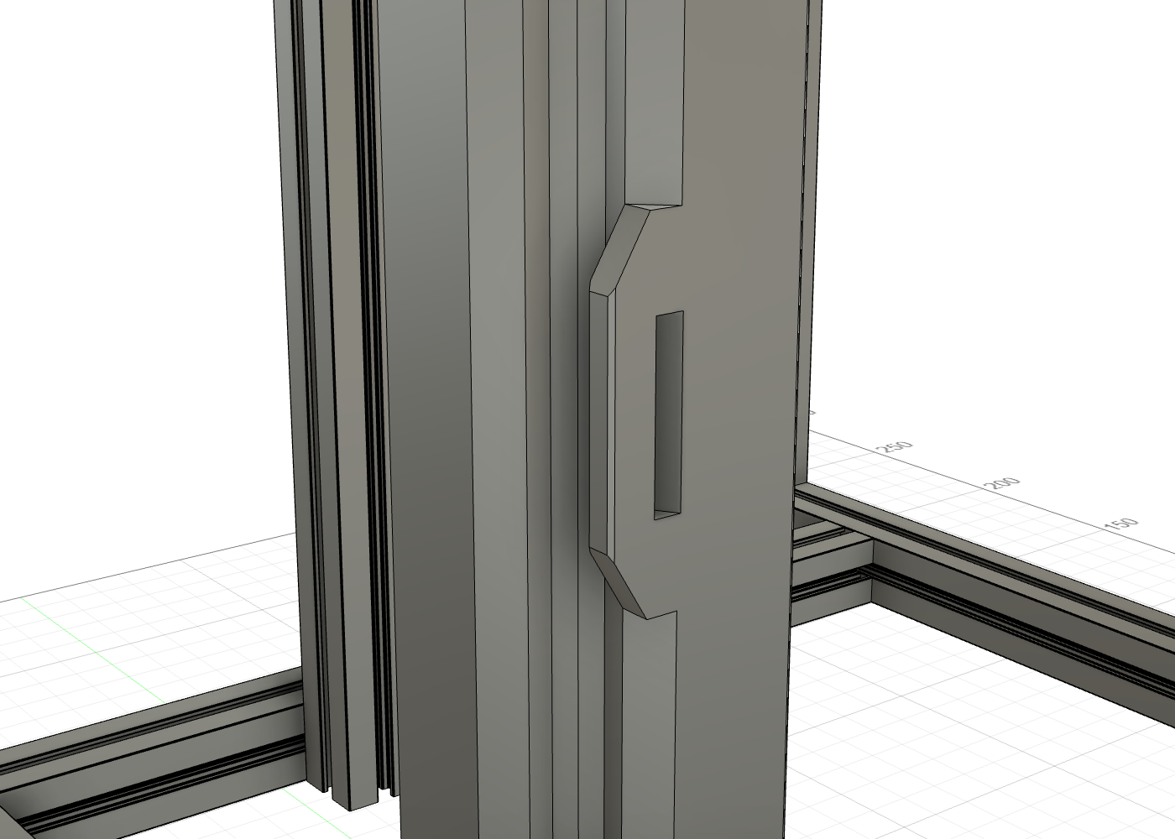
v12-puxador-3d.png
