rhapsodyv/voron-panel-holder/v13-cores-frente.png

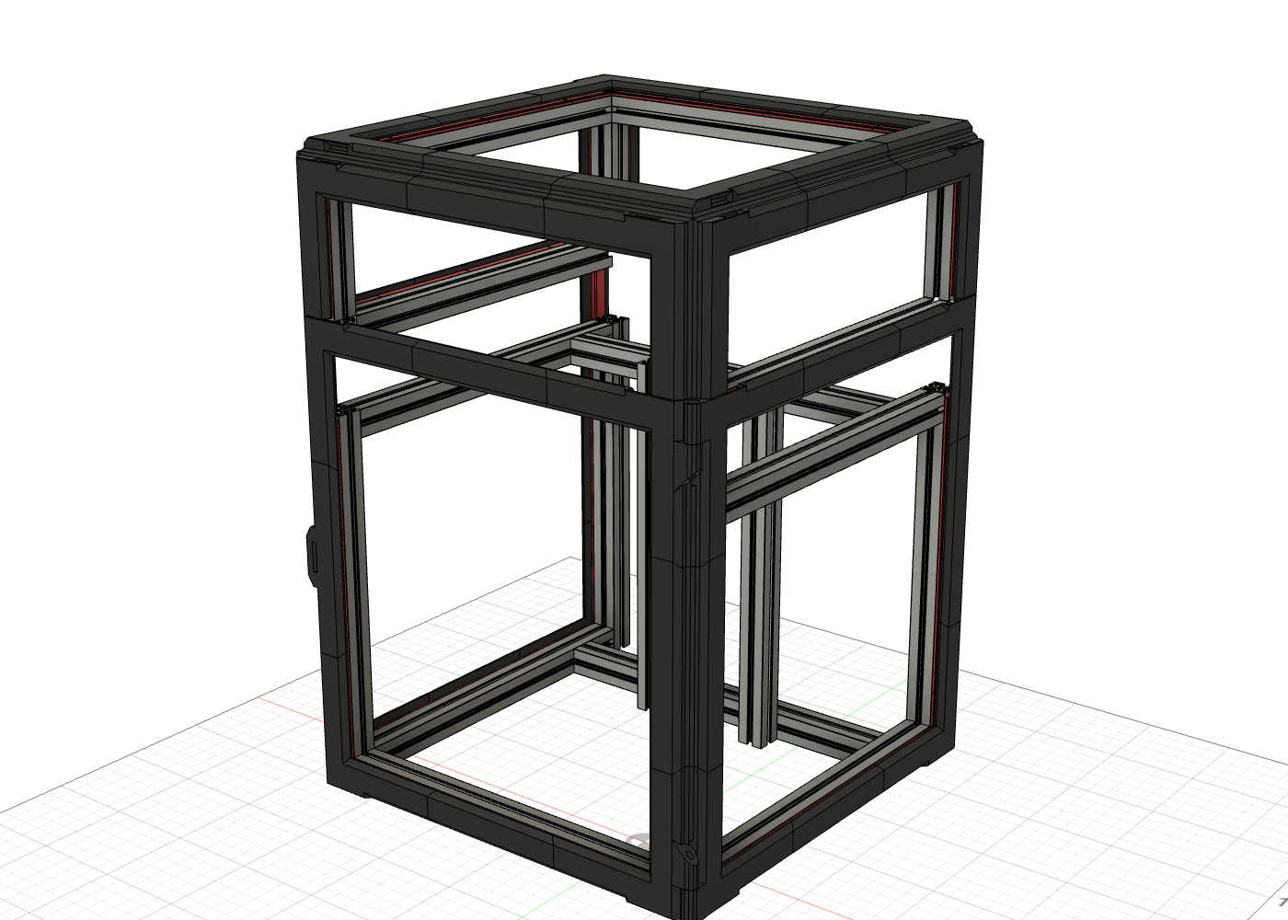
v13-cores-frente.png
