rhapsodyv/voron-panel-holder/v13-cores-tras.png

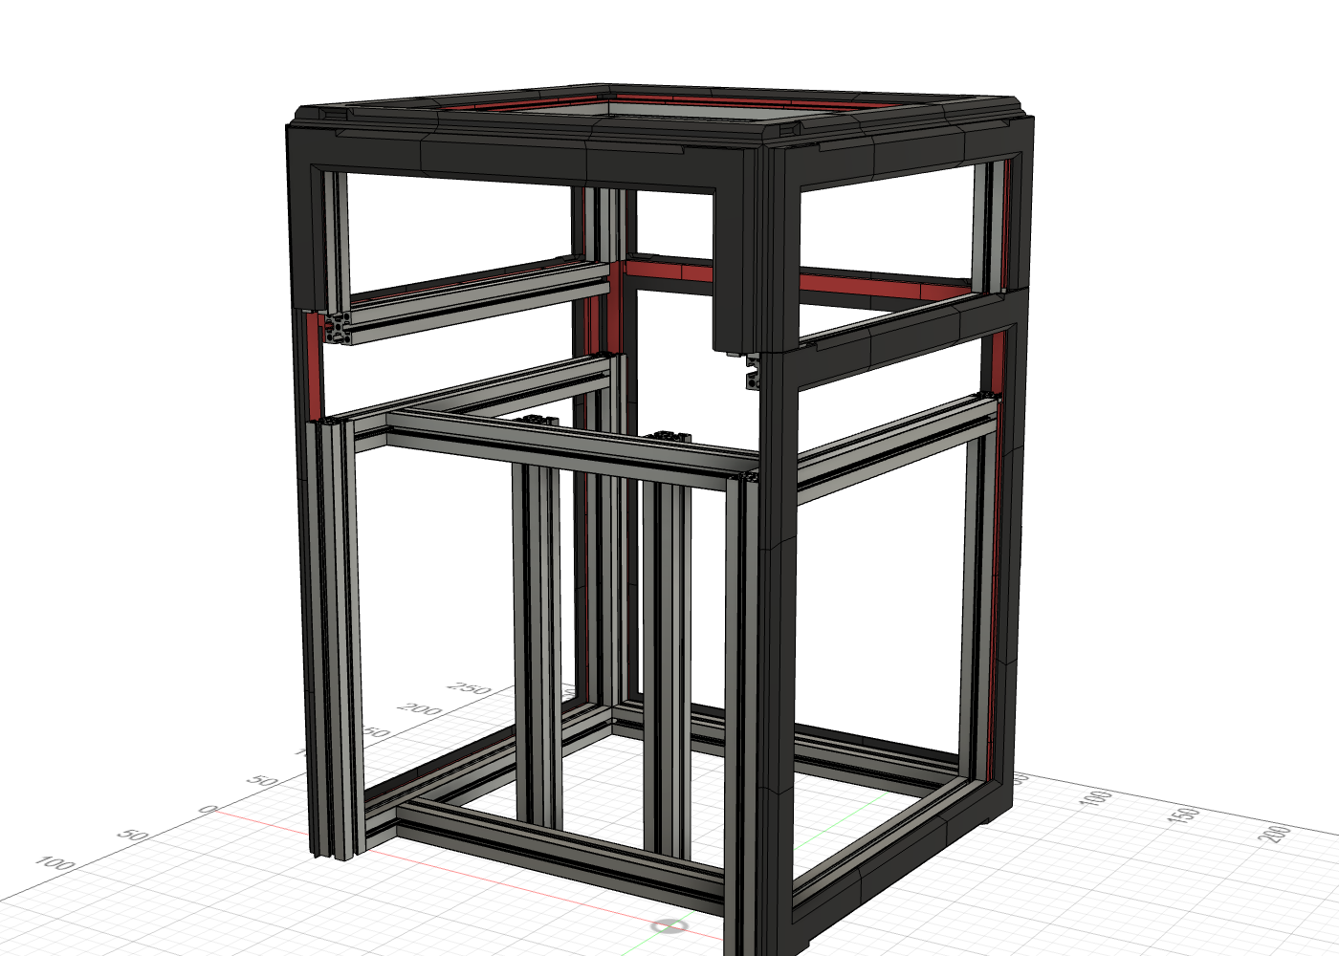
v13-cores-tras.png
