rhapsodyv/voron-panel-holder/v13-traseira-b.png

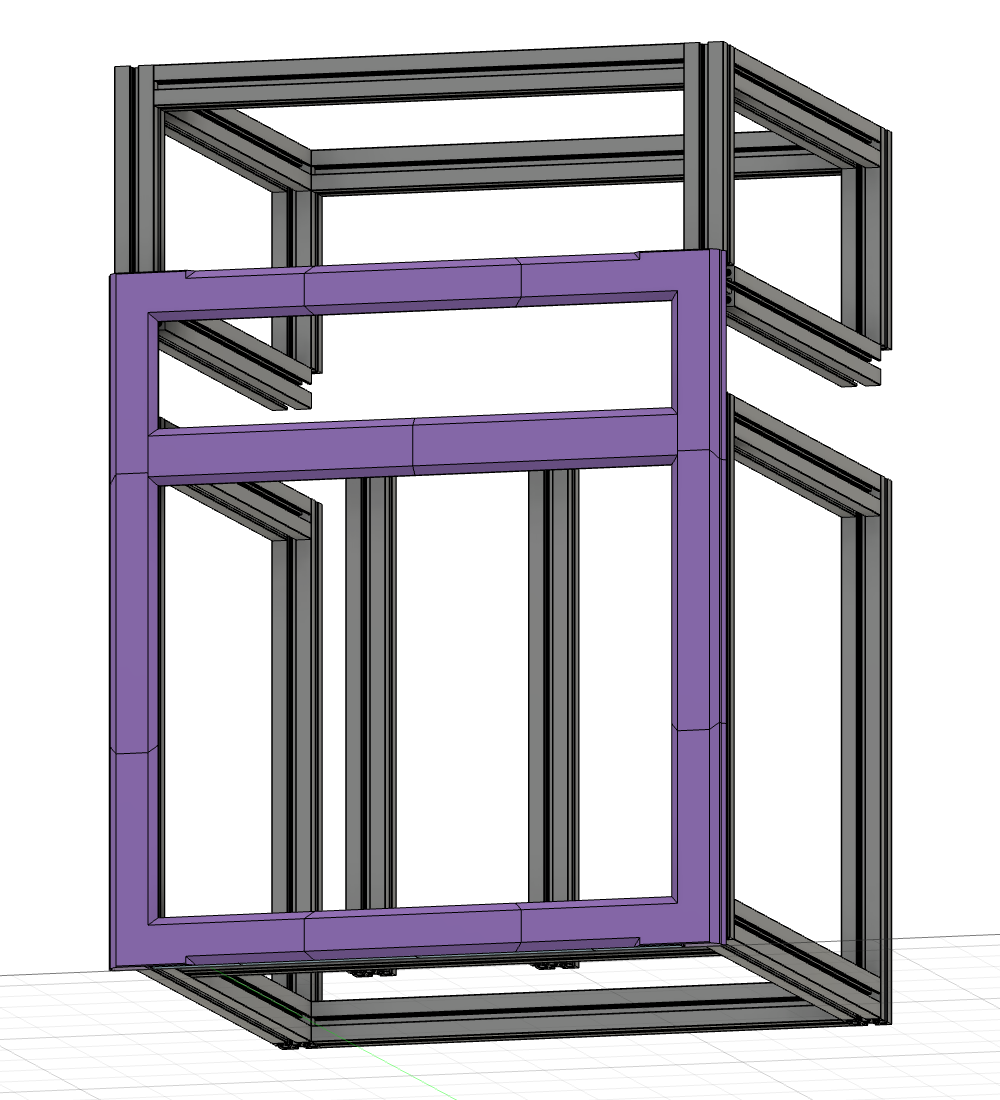
v13-traseira-b.png
