rhapsodyv/voron-panel-holder/v13-traseira.png

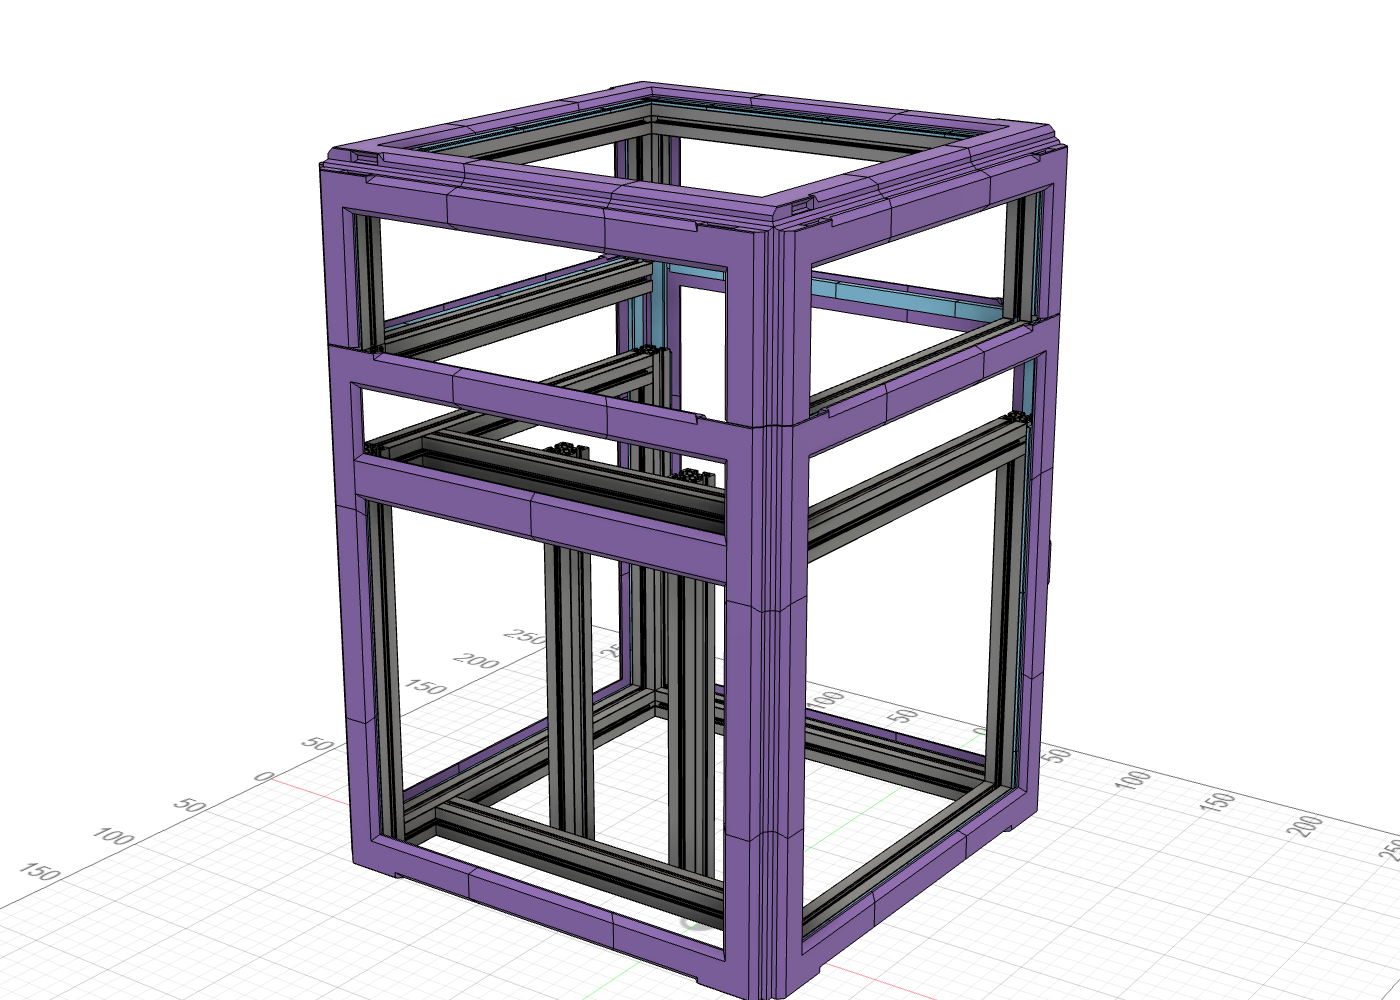
v13-traseira.png
