rhapsodyv/voron-panel-holder/ideias-trava/peca-unica-base-inteira-parede-1.5.stl

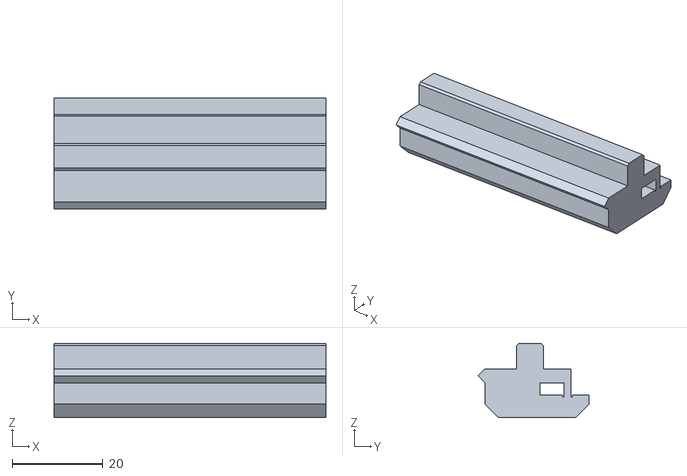
[picture p75: CAD file, 2026-11-03]
ideias-trava/peca-unica-base-inteira-parede-1.5.stl
60.0 x 24.5 x 16.4
