rhapsodyv/voron-panel-holder/stl/provas-peca-unica-trava-v1/trava-capa-1x.stl

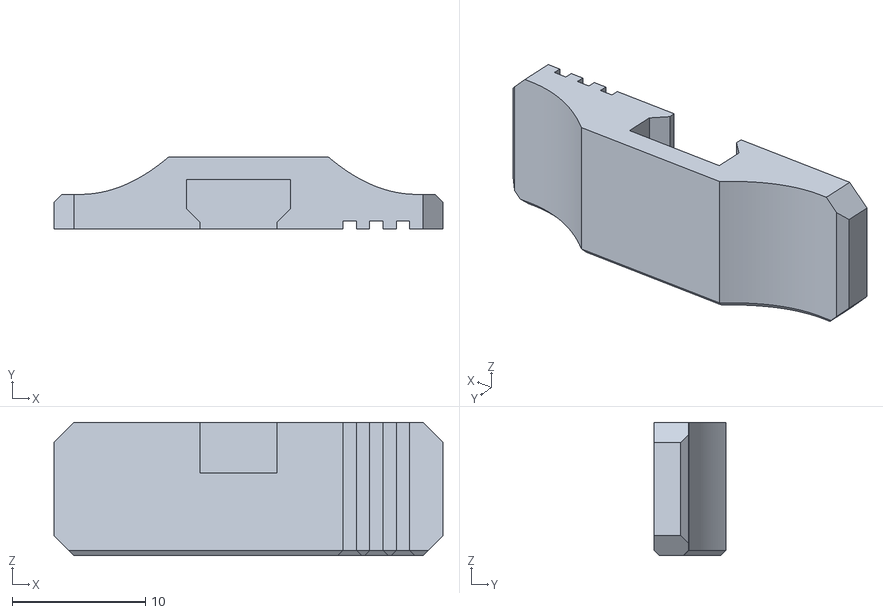
[picture p76: CAD file, 2026-11-03]
stl/provas-peca-unica-trava-v1/trava-capa-1x.stl
29.2 x 5.40 x 10.0
