rhapsodyv/voron-panel-holder/stl/provas-trava-v3/trava-indicador-1x.stl

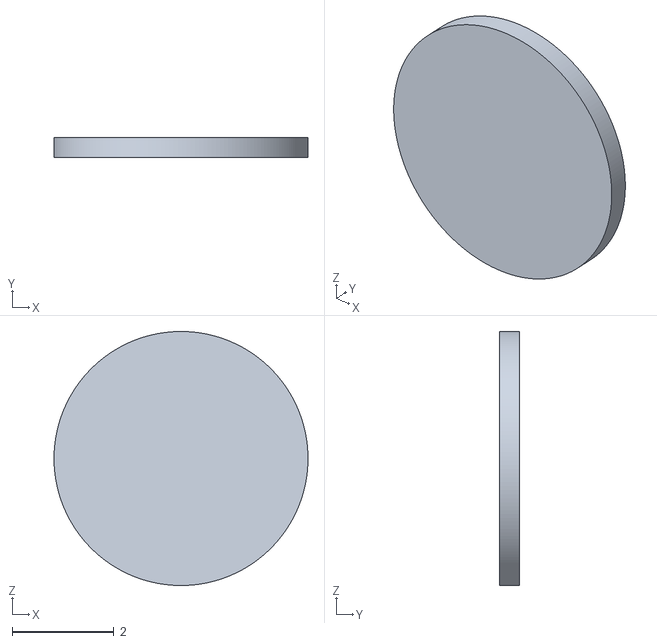
[picture p77: CAD file, 2026-11-03]
stl/provas-trava-v3/trava-indicador-1x.stl
5.00 x 0.4 x 5.00
