rhapsodyv/voron-panel-holder/stl/trident-provas-peca-unica-trava-v8/trava-cursor-gancho-020.step

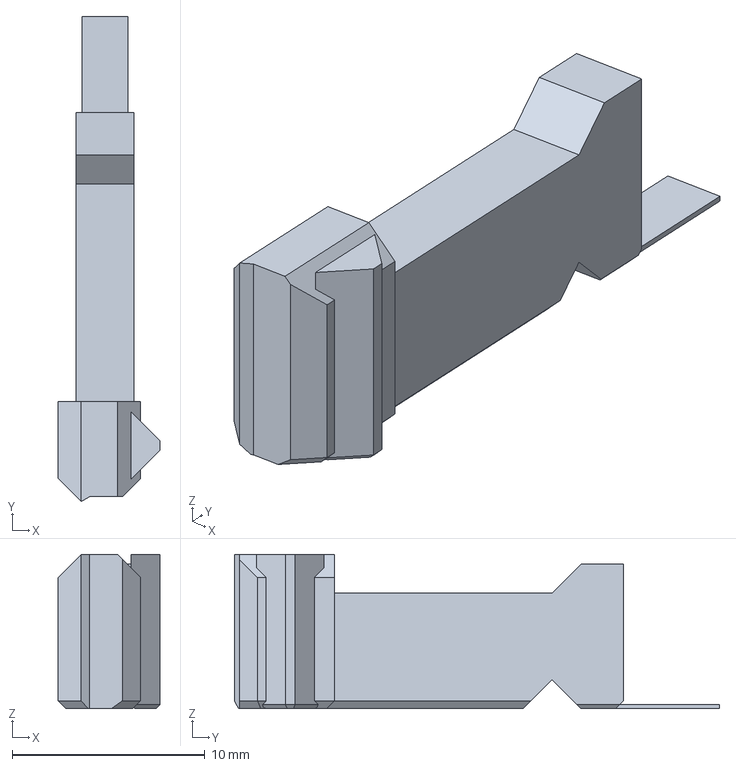
[picture p78: CAD file, 2026-11-03]
stl/trident-provas-peca-unica-trava-v8/trava-cursor-gancho-020.step
5.29 x 25.2 x 8.00 mm
