rhapsodyv/voron-panel-holder/stl/provas-peca-unica-trava-v1/trava-cursor-gancho-010-1x.stl

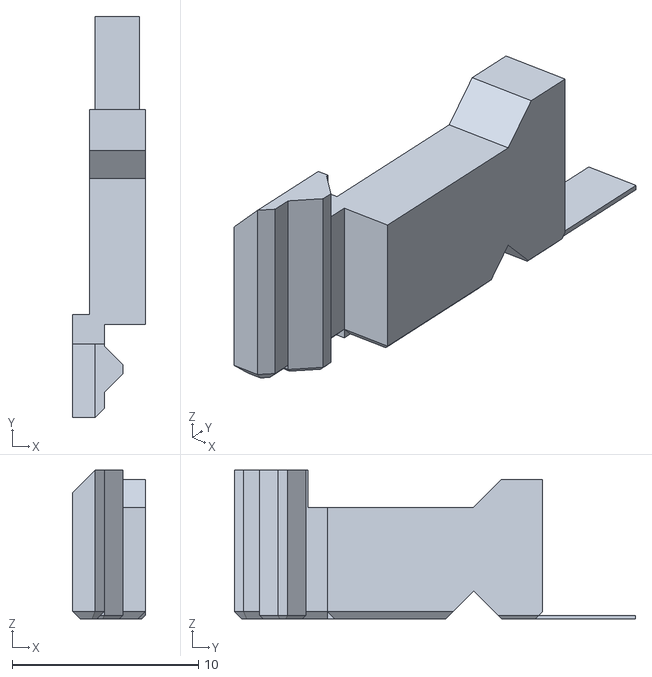
[picture p79: CAD file, 2026-11-03]
stl/provas-peca-unica-trava-v1/trava-cursor-gancho-010-1x.stl
3.90 x 21.6 x 8.00
