rhapsodyv/voron-panel-holder/stl/trident-provas-peca-unica-trava-v7/trava-capa-final.step

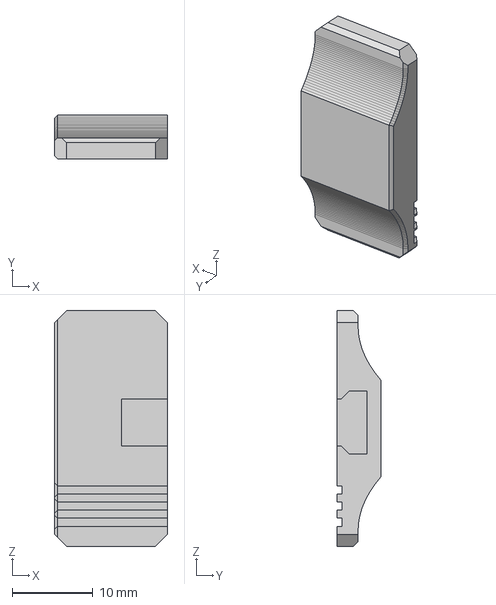
[picture p80: CAD file, 2026-11-03, an earlier design]
stl/trident-provas-peca-unica-trava-v7/trava-capa-final.step
14.0 x 5.40 x 29.2 mm
