rhapsodyv/voron-panel-holder/stl/trident-provas-peca-unica-trava-v7/trava-cursor-final.step

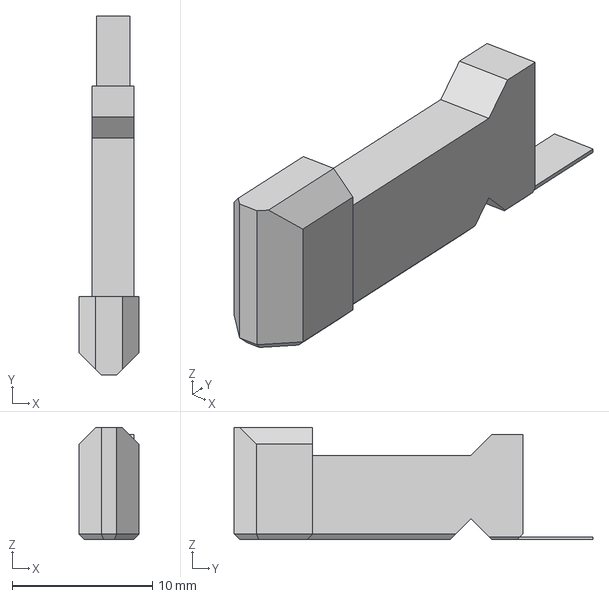
[picture p81: CAD file, 2026-11-03, an earlier design]
stl/trident-provas-peca-unica-trava-v7/trava-cursor-final.step
4.29 x 25.6 x 8.00 mm
