rhapsodyv/voron-panel-holder/(list of files, cad)

Other CAD files:
stl/trident-provas-peca-unica-trava-v8/trava-cursor-gancho-020-1x.stl
stl/trident-provas-peca-unica-trava-v5/trava-indicador-1x.stl
stl/trident-provas-peca-unica-trava-v7/trava-capa-final-2x.stl
