rhapsodyv/voron-panel-holder/v12-fase2-montagem.png

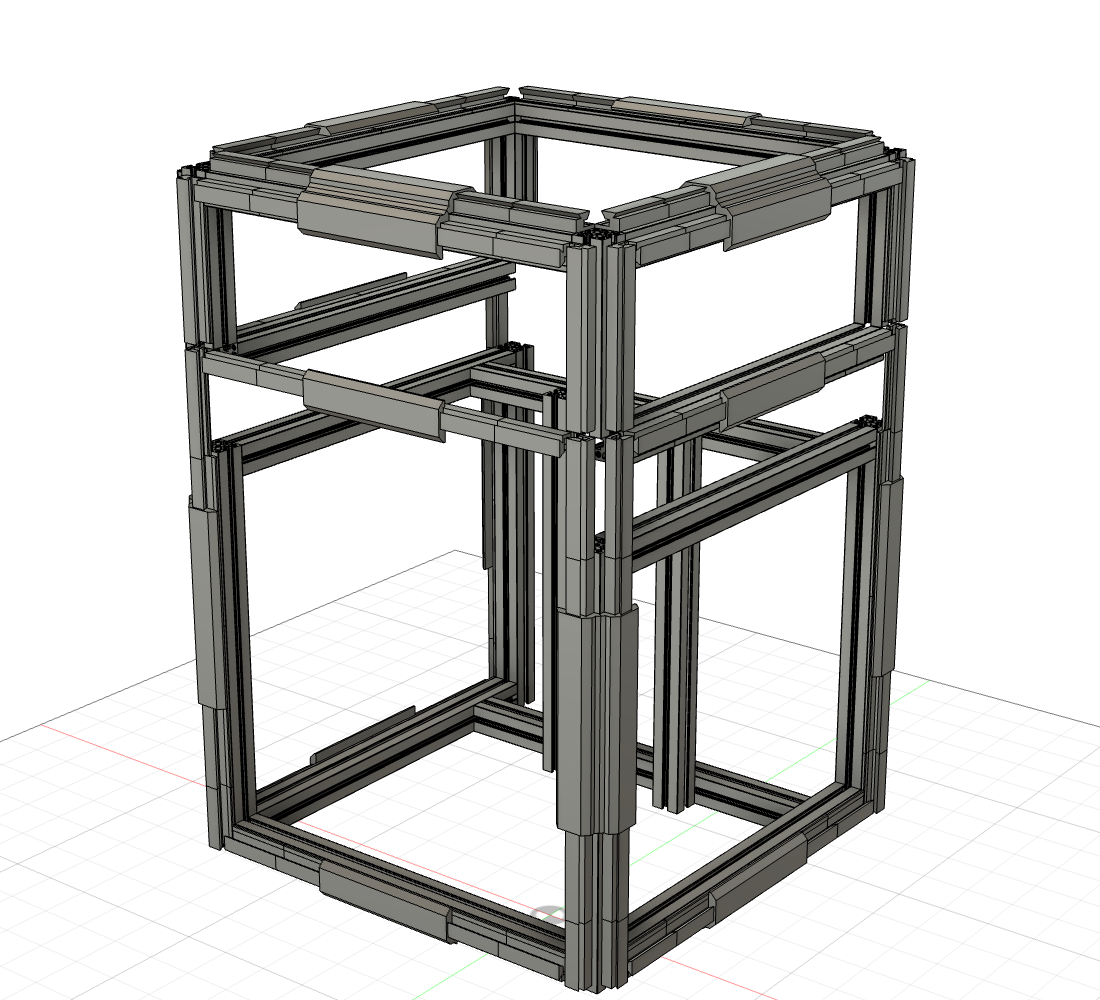
v12-fase2-montagem.png
