rhapsodyv/voron-panel-holder/v12-fase3-montagem.png

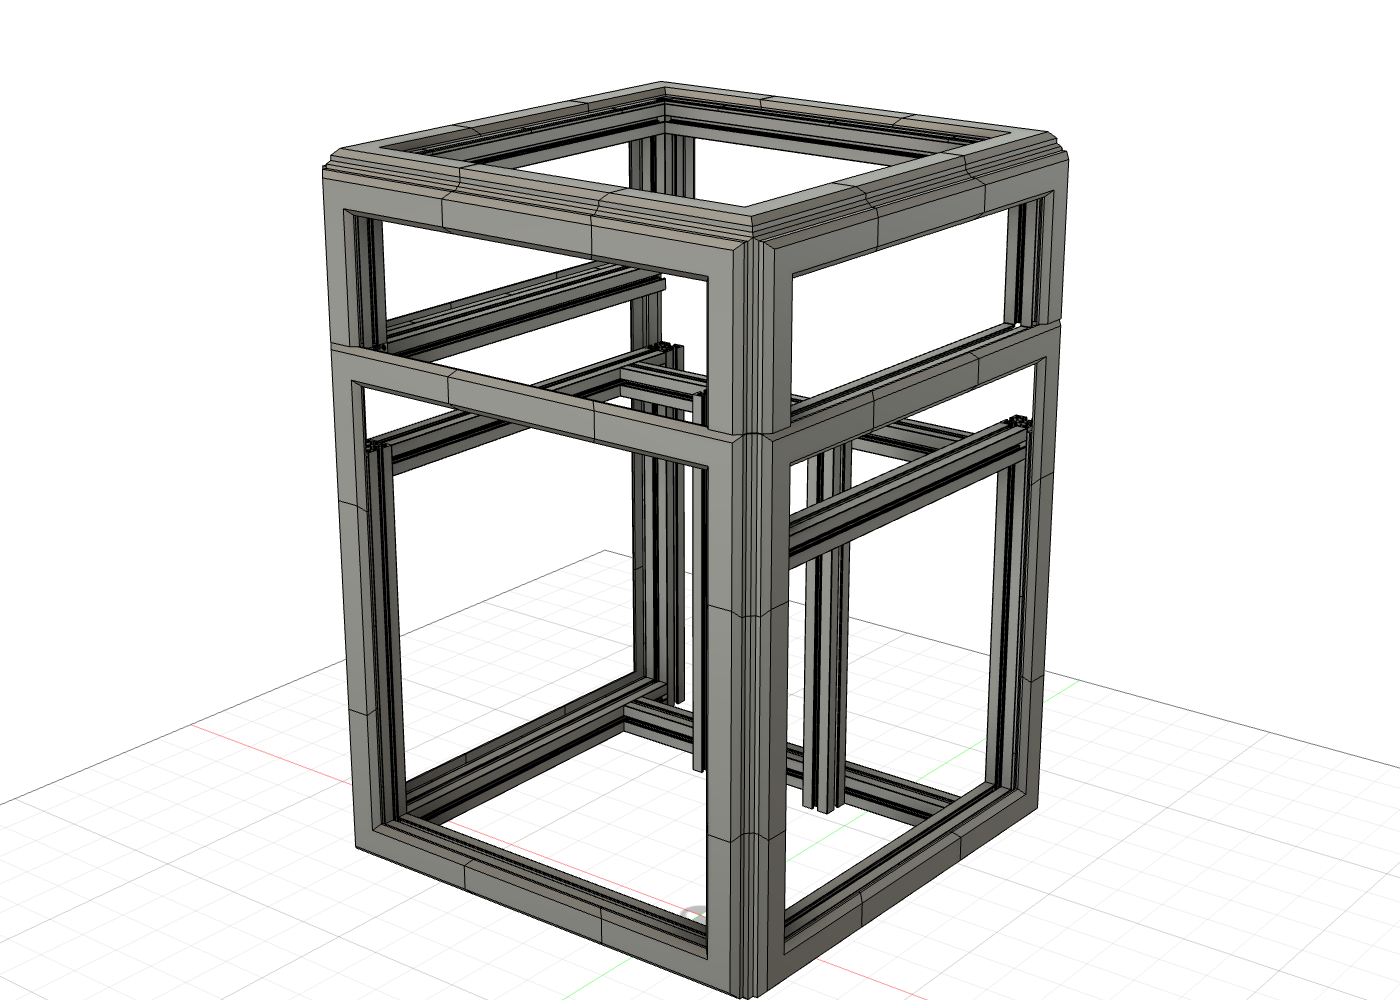
v12-fase3-montagem.png
