rhapsodyv/voron-panel-holder/verificacao-secoes.png

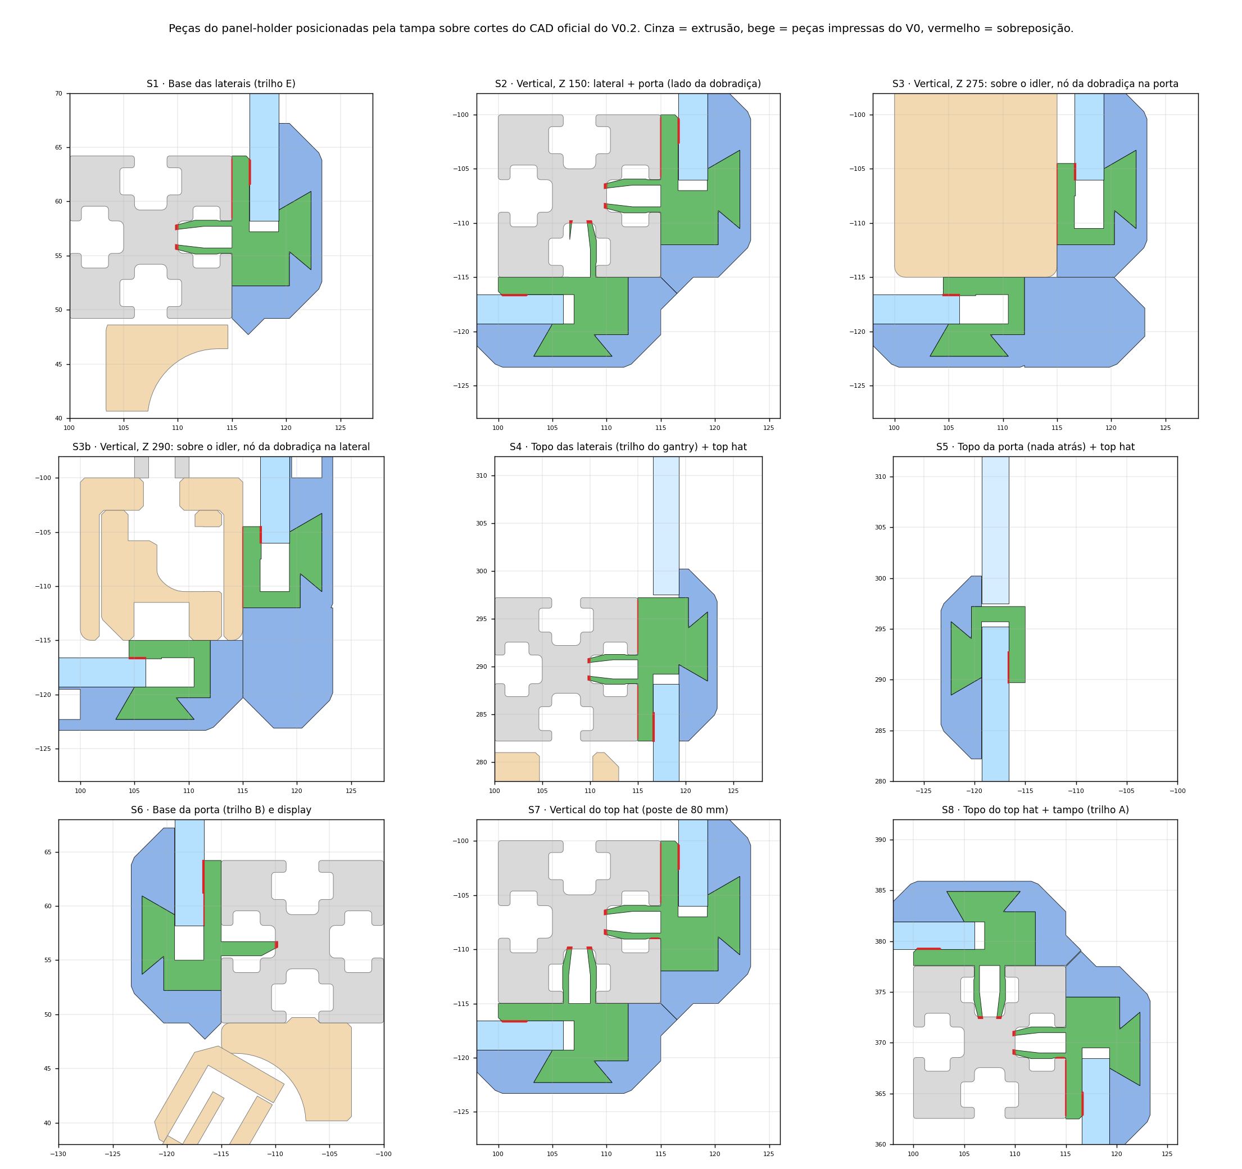
verificacao-secoes.png
