rhapsodyv/voron-panel-holder/gerador/trident/parametros.py

"""Parameters of the Trident 350 panel holder (copied from the V0 set, 2020 slot and fin values changed).

Three groups:
  geometria  - measured from the reference (Misumi HFSB5-2020 in the Trident CAD, the user's sheets: same as on the V0)
  projeto    - design choices
  ajuste     - print/material fits, tuned with test coupons (defaults are the values that worked in v11)

Each entry: (group, name, expression, unit, comment)
"""

PARAMS = [
    # --- geometria: Misumi 1515 slot, measured on the V0.2 CAD profile
    ('geometria', 'frame_size', '20 mm', 'mm', 'Perfil 2020'),
    ('geometria', 'slot_opening', '6.35 mm', 'mm', 'Abertura do rasgo: medida no frame do usuário (6,3 a 6,4); o Misumi HFSB5-2020 do CAD tem 6,0'),
    ('geometria', 'slot_lip', '2 mm', 'mm', 'Espessura da aba do rasgo'),
    ('geometria', 'slot_cavity_width', '12 mm', 'mm', 'Largura da cavidade atrás da aba (afunila a 45° a partir de 2,94 de profundidade)'),
    ('geometria', 'slot_cavity_depth', '5 mm', 'mm', 'Até onde a farpa cabe na cavidade (afunilada, ±3,94 em 5 mm)'),
    ('geometria', 'slot_depth', '6 mm', 'mm', 'Fundo do rasgo (com um V de 0,3 no centro)'),
    ('geometria', 'panel_thickness', '2.7 mm', 'mm', 'Chapa de acrílico, medida'),
    ('geometria', 'frame_width', '510 mm', 'mm', 'Frame: largura externa (X), Trident 350'),
    ('geometria', 'frame_depth', '510 mm', 'mm', 'Frame: profundidade externa (Y), Trident 350'),
    ('geometria', 'frame_z0', '0 mm', 'mm', 'Frame: altura da face de baixo (z = 0 no pé do frame)'),
    ('geometria', 'body_height', '500 mm', 'mm', 'Frame: altura total (postes de 500)'),
    ('geometria', 'post_height', '500 mm', 'mm', 'Postes 2020'),
    ('geometria', 'tophat_gap', '0.3 mm', 'mm', 'Entre o topo do gantry e o frame do top hat'),
    ('geometria', 'tophat_height', '80 mm', 'mm', 'Postes 1515 do top hat'),
    ('geometria', 'rear_lower_sheet', '185 mm', 'mm', 'Traseira: altura da chapa de baixo (a original do V0.2 tem 185)'),
    ('geometria', 'door_sheet_width', '241.5 mm', 'mm', 'Portas: largura da chapa original da 350 (191,5 da 250 do CAD + 50; altura 473)'),
    ('geometria', 'exhaust_notch_width', '147 mm', 'mm', 'Traseira: recorte do exaustor no meio da borda de cima da chapa original, largura (CAD)'),
    ('geometria', 'exhaust_notch_depth', '42.5 mm', 'mm', 'Traseira: recorte do exaustor, da borda de cima da chapa para baixo (CAD; cantos de baixo r 3,5)'),

    # --- projeto
    ('projeto', 'frame_contact_width', '( frame_size - slot_opening ) / 2', 'mm', 'Face do perfil de cada lado do rasgo'),
    ('projeto', 'panel_frame_spacing', '3 mm', 'mm', 'Base do clip entre o perfil e o acrílico: 3 como a espuma original das laterais da Trident (juntas XY e carros do Z passam 0,3 além da face do frame)'),
    ('projeto', 'base_inset', '1 mm', 'mm', 'Base do clip sob o acrílico: começa isto antes da borda de dentro do perfil (os carros do Z e as juntas XY passam rente à borda do poste)'),
    ('projeto', 'wall_width', '3 mm', 'mm', 'Parede da tampa na faixa externa do perfil'),
    ('projeto', 'cover_height', '5 mm', 'mm', 'Espessura da tampa acima do acrílico (5 na Trident: 2,0 de parede sobre o canal do rabo-de-andorinha; no V0, 4 deixa 1,0)'),
    ('projeto', 'cover_overlap', '3 mm', 'mm', 'Quanto a tampa passa da borda interna do perfil'),
    ('projeto', 'cover_cut', '3 mm', 'mm', 'Chanfro de 45° nas bordas da tampa'),
    ('projeto', 'cover_recess', '1 mm', 'mm', 'Rebaixo da tampa sobre o bloco do clip'),
    ('projeto', 'dovetail_height', '3 mm', 'mm', 'Altura do rabo-de-andorinha'),
    ('projeto', 'dovetail_angle_in', '30 deg', 'deg', 'Flanco interno do rabo-de-andorinha'),
    ('projeto', 'dovetail_angle_out', '40 deg', 'deg', 'Flanco externo do rabo-de-andorinha'),
    ('projeto', 'dovetail_inset', '0 mm', 'mm', 'Do batente do acrílico até a raiz interna do rabo-de-andorinha (0 na Trident: o rabo-de-andorinha fica todo sobre o corpo do clip, sem pescoço fino; no V0 o 1515 não tem espaço e fica 2)'),
    ('projeto', 'dovetail_top_width', '7.25 mm', 'mm', 'Largura do topo do rabo-de-andorinha'),
    ('projeto', 'rib_width', '2.2 mm', 'mm', 'Nervura de pré-carga sob o acrílico'),
    ('projeto', 'rib_inset', '0.4 mm', 'mm', 'Chanfro na quina interna da base'),
    ('projeto', 'fin_leg', '1 mm', 'mm', 'Espessura da perna da aleta na raiz'),
    ('projeto', 'fin_inner_straight', '4.5 mm', 'mm', 'Trecho reto da face interna da perna'),
    ('projeto', 'fin_tip_half', '2 mm', 'mm', 'Meia largura da aleta na ponta'),
    ('projeto', 'fin_tip_leg', '0.8 mm', 'mm', 'Espessura da perna na ponta'),
    ('projeto', 'test_length', '20 mm', 'mm', 'Comprimento dos corpos de prova'),
    ('projeto', 'top_overhang', '0 mm', 'mm', 'Não usado na Trident (no V0: tampa do topo passando do perfil para o top hat)'),
    ('projeto', 'u_base_width', '7.5 mm', 'mm', 'Base do clip em U, a partir do bloco externo'),
    ('projeto', 'u_end_wall', '1.5 mm', 'mm', 'Fundo do U: do batente do acrílico até o bloco externo'),
    ('projeto', 'door_pin_s', 'frame_size / 2 + 5.45 mm', 'mm', 'Pino da dobradiça: distância para fora do centro do rasgo, 5,45 além da borda (era 4,25, do V0): na metade da altura da tampa, como no V0, os nós chegam ao topo da tampa e imprimem sem balanço'),
    ('projeto', 'door_pin_d', '5.45 mm', 'mm', 'Pino da dobradiça: altura sobre a face do perfil, (topo da tampa 10,7 + hinge_clearance) / 2 (era 4,15, do V0)'),
    ('projeto', 'door_arc_outer', '18 mm', 'mm', 'Raio externo da aleta em arco, a partir do pino (18 com o pino em 5,45: raiz de -1,7 a 0,9 no rasgo, como antes)'),
    ('projeto', 'door_arc_thickness', '2.5 mm', 'mm', 'Espessura da aleta em arco'),
    ('projeto', 'door_arc_tip_angle', '-143 deg', 'deg', 'Ângulo da ponta da aleta em arco, medido no pino'),
    ('projeto', 'door_stop_extra', '0 mm', 'mm', 'Portas: batente da chapa além do padrão (no V0, 2,2 para a chapa original da porta)'),

    ('projeto', 'cover_corner', '120 mm', 'mm', 'Perna dos cantos em L das tampas (canto, meio, canto em cada borda)'),
    ('projeto', 'clip_end_gap', '3 mm', 'mm', 'Os clips começam e terminam essa distância antes da borda do frame'),
    ('projeto', 'door_corner', '85 mm', 'mm', 'Portas: perna horizontal dos cantos em L (a porta tem metade da largura: com 120, a tampa do meio de cima e de baixo teria 15 mm)'),
    ('projeto', 'door_corner_v', 'cover_corner', 'mm', 'Portas: perna vertical dos cantos em L, a das laterais: as emendas da porta e da lateral se alinham na dobradiça (era door_corner, 85, até 2026-11-03)'),
    ('projeto', 'door_gap', '0.5 mm', 'mm', 'Portas: folga entre as duas portas no centro (vedação: numa fresta estreita o vazamento cai com o cubo da folga)'),
    ('projeto', 'door_width', 'frame_width / 2 - door_gap / 2', 'mm', 'Portas: largura de cada porta, da borda da dobradiça ao centro'),
    ('projeto', 'door_clip_run', 'door_width - 2 * frame_size', 'mm', 'Portas: clips de cima e de baixo de cada porta (param frame_size antes do poste e do clip em U do centro)'),
    ('projeto', 'bowden_plug_clearance', '0.3 mm', 'mm', 'Passa-bowden: folga do tampão no recorte, por lado'),
    ('projeto', 'bowden_plate_overlap', '8 mm', 'mm', 'Passa-bowden: aba de fora sobre a chapa, nos lados e embaixo do recorte'),
    ('projeto', 'bowden_plate_thickness', '2.4 mm', 'mm', 'Passa-bowden: espessura da aba de fora'),
    ('projeto', 'bowden_plate_chamfer', '3 mm', 'mm', 'Passa-bowden: chanfro dos cantos (os de baixo do tampão livram o raio de 3,5 do recorte)'),
    ('projeto', 'bowden_cover_gap', '0.5 mm', 'mm', 'Passa-bowden: folga entre a aba de fora e a tampa da borda de cima'),
    ('projeto', 'bowden_hole', '10.2 mm', 'mm', 'Passa-bowden: furo passante do conector pneumático de PTFE 4 mm com porca (1/8" BSP do BOM original, ~9,7, ou M10)'),
    ('projeto', 'bowden_hole_x', '0 mm', 'mm', 'Passa-bowden: furo ao longo da borda, a partir do meio (+ = para a direita, olhando a traseira por trás)'),
    ('projeto', 'bowden_hole_up', '16 mm', 'mm', 'Passa-bowden: centro do furo acima do fundo do recorte'),
    ('projeto', 'u_outer_wall', '2.5 mm', 'mm', 'Clip em U com a parede por fora (centro das portas): parede entre a chapa e a outra porta'),
    ('projeto', 'u_outer_clearance', '0.5 mm', 'mm', 'Clip em U com a parede por fora: folga entre a borda da chapa e a parede'),
    ('projeto', 'u_end_wall_thin', '1 mm', 'mm', 'Clip em U de fundo fino (traseira do V0; não usado na Trident)'),
    ('projeto', 'door_hinge_shift', 'door_gap / 2 + u_outer_wall + u_outer_clearance + door_sheet_width - ( frame_width / 2 - frame_size / 2 ) + slot_opening / 2', 'mm',
     'Portas, lado da dobradiça: batente e rabo-de-andorinha deslocados para fora, para a chapa original caber'),
    ('projeto', 'idle_cut', '50 mm', 'mm', 'Trecho final das verticais, sobre o gantry: clip em U, sem aleta'),
    ('projeto', 'clip_run_h', 'frame_width - 2 * frame_size', 'mm', 'Bordas horizontais: comprimento total dos clips (entre os postes)'),
    ('projeto', 'clip_run_v', 'body_height - 2 * clip_end_gap', 'mm', 'Bordas verticais: comprimento total dos clips'),
    ('projeto', 'clip_run_th', 'tophat_height - 2 * clip_end_gap', 'mm', 'Verticais do top hat: comprimento do clip'),
    ('projeto', 'joint_scarf', 'cover_height - cover_recess', 'mm', 'Junta entre tampas: chanfro de 45° em que o trecho do meio passa por cima da perna do canto'),
    ('projeto', 'grip_from', '13.4 mm', 'mm', 'Entalhe do dedo: do canto até o início do rebaixo, na face externa'),
    ('projeto', 'grip_length', '15.3 mm', 'mm', 'Entalhe do dedo: comprimento do rebaixo na face externa (pontas a 45°)'),
    ('projeto', 'grip_depth', '2 mm', 'mm', 'Entalhe do dedo: profundidade do rebaixo'),
    ('projeto', 'grip_lip_chamfer', '0.4 mm', 'mm', 'Entalhe do dedo: chanfro no topo do lábio'),
    ('projeto', 'grip_lip_margin', '0.6 mm', 'mm', 'Entalhe do dedo: quanto o lábio passa do fim do rebaixo'),
    ('projeto', 'hinge_side_len', '18 mm', 'mm', 'Dobradiça: nó da lateral, a partir do canto (segura o parafuso)'),
    ('projeto', 'hinge_door_len', '16 mm', 'mm', 'Dobradiça: nó da porta, medido no pino (a ponta tem reforço a 45°)'),
    ('projeto', 'hinge_head_d', '6 mm', 'mm', 'Dobradiça: rebaixo da cabeça do parafuso, diâmetro'),
    ('projeto', 'hinge_head_depth', '3 mm', 'mm', 'Dobradiça: rebaixo da cabeça do parafuso, profundidade'),
    ('projeto', 'handle_length', '30 mm', 'mm', 'Puxador das portas (como o do V0, para dentro): trecho com a aba inteira, no meio da altura'),
    ('projeto', 'handle_taper', '6 mm', 'mm', 'Puxador: rampa em cada ponta da aba'),
    ('projeto', 'handle_reach', '4 mm', 'mm', 'Puxador: quanto a aba passa da borda de dentro da tampa, sobre a chapa da própria porta'),
    ('projeto', 'handle_edge_chamfer', '0.4 mm', 'mm', 'Puxador: chanfro nas arestas da aba'),
    ('projeto', 'handle_groove_s', '-( frame_size / 2 + cover_overlap ) + 1.95 mm', 'mm', 'Puxador: posição do sulco no topo (perto da borda de dentro, como no V0 perto da de fora)'),
    ('projeto', 'handle_groove_width', '2.6 mm', 'mm', 'Puxador: largura do sulco em V no topo'),
    ('projeto', 'handle_groove_depth', '2 mm', 'mm', 'Puxador: profundidade do sulco em V'),
    ('projeto', 'handle_groove_length', 'handle_length - 4 mm', 'mm', 'Puxador: comprimento do sulco'),
    ('projeto', 'h_web', '1.5 mm', 'mm', 'Traseira, barra em H: alma entre as duas chapas'),
    ('projeto', 'rear_h_half', 'frame_width / 2 - frame_size - cover_overlap', 'mm', 'Traseira, barra em H: do centro até a tampa vertical (cada metade da tampa)'),

    # --- ajuste: print/material fits (v11 values)
    ('ajuste', 'panel_preload', '0.05 mm', 'mm', 'Interferência da nervura contra o acrílico (era 0,1; igual ao V0)'),
    ('ajuste', 'panel_edge_clearance', '1 mm', 'mm', 'Folga entre a borda do acrílico e o batente'),
    ('projeto', 'u_outer_shift', 'wall_width + u_end_wall + panel_edge_clearance - u_outer_wall - u_outer_clearance', 'mm',
     'Clip em U com a parede por fora: rabo-de-andorinha deslocado para manter a distância à borda da chapa do clip em U comum'),
    ('ajuste', 'fin_root_clearance', '0.05 mm', 'mm', 'Folga por lado das pernas da aleta na abertura do rasgo (tolerância de impressão)'),
    ('ajuste', 'fin_barb', '0.12 mm', 'mm', 'Farpa por lado, além da abertura: é o quanto a perna dobra para entrar e para sair (v4 ~0,225 entra e sai bem; v5 0,45 quebra a perna ao tirar). v6 com 0,25, 0,3 e 0,35. v14: adotado o clip 6, o V0 em escala 2x (farpa 0,12, aperto 0,06, face a 23°, perna de 1,0)'),
    ('ajuste', 'fin_neck', 'fin_leg', 'mm', 'Pescoço: espessura da perna perto da raiz, onde ela flexiona (igual a fin_leg = sem pescoço)'),
    ('ajuste', 'fin_neck_length', '2.8 mm', 'mm', 'Pescoço: comprimento a partir da raiz, para baixo da face do perfil (depois alarga a 45° até fin_leg)'),
    ('ajuste', 'fin_relief', '0 mm', 'mm', 'Alívio: a raiz de cada perna sobe isto para dentro da base, entre um sulco por fora e o vão entre as pernas por dentro, para a perna flexionar no comprimento todo (0 = a perna nasce na face do perfil)'),
    ('ajuste', 'fin_relief_gap', '0.6 mm', 'mm', 'Alívio: largura do sulco por fora de cada perna'),
    ('ajuste', 'fin_inset', '0 mm', 'mm', 'Pernas da aleta recolhidas, por lado, em direção ao centro do rasgo (a distância entre elas diminui o dobro): menos força para entrar e sair, e o mesmo tanto a menos de aperto'),
    ('ajuste', 'fin_lip_preload', '0 mm', 'mm', 'Pernas da aleta inclinadas para fora (pressão lateral; v3 testou 0,05 a 0,15: não era a folga)'),
    ('ajuste', 'fin_squeeze', '0.06 mm', 'mm', 'Aperto da face da farpa no canto da aba, na horizontal: a perna fica dobrada isso com o clip encaixado, o que tira a folga para cima e para baixo (v5: 0,2 a 0,4 acabou com a folga)'),
    ('ajuste', 'fin_barb_angle', '23 deg', 'deg', 'Face da farpa (a que a aba empurra ao tirar o clip), medida da vertical: menor = mais fácil de tirar'),
    ('ajuste', 'fin_barb_gap', '-( fin_squeeze + fin_root_clearance ) / tan(fin_barb_angle)', 'mm', 'Início da face da farpa abaixo do pé da aba (negativo = acima), calculado do aperto e do ângulo'),
    ('ajuste', 'fin_barb_ramp', '( fin_barb + fin_root_clearance ) / tan(fin_barb_angle)', 'mm', 'Altura da face da farpa, calculada do ângulo'),
    ('ajuste', 'fin_barb_end', '1 mm', 'mm', 'Fim da farpa antes do fim da cavidade (mais alto: rampa de entrada da ponta a ~40°)'),
    ('ajuste', 'fin_anchor_length', '0 mm', 'mm', 'Trechos com farpa: comprimento de cada um (um em cada ponta, os outros espaçados por igual); 0 = farpa no clip inteiro'),
    ('ajuste', 'fin_anchor_gap', '45 mm', 'mm', 'Trechos com farpa: maior vão sem farpa entre dois trechos'),
    ('ajuste', 'fin_min_wall', '0.4 mm', 'mm', 'Parede mínima das pernas da aleta (medida de lado, não na horizontal): abaixo disso o fatiador apaga (perímetro de 0,4, gerador classic)'),
    ('ajuste', 'fin_tip_clearance', '0.3 mm', 'mm', 'Folga entre a ponta da aleta e o fundo do rasgo'),
    ('ajuste', 'dovetail_clearance', '0.1 mm', 'mm', 'Folga por flanco no rabo-de-andorinha da tampa (v9: a tampa 1, com 0,10, deslizou bem; era 0,05)'),
    ('ajuste', 'cover_clip_clearance', '0.15 mm', 'mm', 'Folga da tampa nas faces planas do clip: a face de dentro da parede e o ombro (ao lado do rabo-de-andorinha); v9: 0,15 deslizou bem (era 0, e o clip travava)'),
    ('ajuste', 'door_fin_clearance', '0.2 mm', 'mm', 'Folga por lado da aleta maciça da porta no rasgo'),
    ('ajuste', 'door_fin_chamfer', '0.5 mm', 'mm', 'Chanfro de entrada na ponta da aleta maciça da porta'),
    ('ajuste', 'hinge_gap', '0.1 mm', 'mm', 'Dobradiça: folga entre os nós ao longo do pino'),
    ('ajuste', 'hinge_clearance', '0.2 mm', 'mm', 'Dobradiça: folga do arco de cada nó até a face do outro painel, no giro'),
    ('ajuste', 'hinge_hole_side', '3 mm', 'mm', 'Dobradiça: furo no nó da lateral (o parafuso M3 rosqueia no plástico)'),
    ('ajuste', 'hinge_hole_door', '3.2 mm', 'mm', 'Dobradiça: furo no nó da porta (gira livre no parafuso)'),
    ('ajuste', 'bed_chamfer', '0.4 mm', 'mm', 'Chanfro nas arestas que encostam na mesa (pé de elefante): pontas dos clips (menos a aleta) e contorno da face de fora das tampas e cantos'),

    # --- trava deslizante (corpo de prova), v8. Cursor (lingueta + pescoço) e capa separada por cima. Aberta, a
    # lingueta fica num trecho do clip sem pernas; deslizando, entra no vão entre as pernas e elas não conseguem
    # mais dobrar. O cursor entra por baixo, pelo lado do frame; só o pescoço atravessa o clip e a tampa. Ele
    # imprime de costas (em pé sobre a ponta de trás): camadas ao longo do pescoço e larguras em XY, como os
    # rasgos e o vão das pernas, então os encaixes não levam folga de compensação da impressora. A capa
    # imprime de lado, sobre a ponta de dentro (v11): o perfil do encaixe sai em XY, como a altura do toco
    ('projeto', 'trava_comprimento', '45 mm', 'mm', 'Trava: comprimento do clip e da tampa do corpo de prova'),
    ('projeto', 'trava_lingueta', '8 mm', 'mm', 'Trava: comprimento da lingueta ao longo da borda'),
    ('projeto', 'trava_inicio', '13 mm', 'mm', 'Trava: início da lingueta na posição aberta, a partir da ponta do corpo de prova'),
    ('projeto', 'trava_curso', '10 mm', 'mm', 'Trava: quanto ela desliza entre aberta e travada (v4: as pernas voltam a 45° do lado da ponta, então travada a lingueta só precisa sair da janela; era 16)'),
    ('projeto', 'trava_haste', '3 mm', 'mm', 'Trava: largura do pescoço (haste), rente à lingueta do lado de fora (v6: 3,0; deixa 1,2 de parede do clip até o batente do acrílico; era 2,4)'),
    ('projeto', 'trava_pescoco_largura', 'trava_haste', 'mm', 'Trava: largura do pescoço acima da base do clip, e do toco, a partir da face de dentro do pescoço (na V0, 3,0 sobre um pescoço de 1,5; aqui o mesmo trava_haste: sem degrau)'),
    ('projeto', 'trava_haste_comprimento', '6 mm', 'mm', 'Trava: comprimento da haste ao longo da borda, a partir da ponta de trás da lingueta (v8: rente a ela, as duas na mesa com o cursor de costas; era centrada)'),
    ('projeto', 'trava_lingueta_topo', '0.4 mm', 'mm', 'Trava: a lingueta começa isto abaixo da face do perfil'),
    ('projeto', 'trava_lingueta_fundo', '4.4 mm', 'mm', 'Trava: fundo da parte reta da lingueta, abaixo da face do perfil (até onde as pernas começam a fechar; v6: 4,4, era 4)'),
    ('projeto', 'trava_quilha_fundo', 'slot_depth', 'mm', 'Trava: a quilha embaixo da lingueta desce até aqui (o fundo do rasgo do perfil: encosta no frame), com os lados a 45°'),
    ('projeto', 'trava_quilha_angulo', '45 deg', 'deg', 'Trava: os lados da quilha fecham com este ângulo da vertical, do fim da parte reta da lingueta até o fundo do rasgo'),
    ('projeto', 'trava_farpa_sobra', '1 mm', 'mm', 'Trava: o clip só tem farpa onde a lingueta fica travada, mais isto de cada lado; no resto as pernas são lisas, com a medida do canal, e entram e saem sem força (v8)'),
    ('projeto', 'trava_entrada', '1.2 mm', 'mm', 'Trava: quanto a ponta da lingueta (bico) é mais estreita, por lado'),
    ('projeto', 'trava_entrada_comprimento', 'trava_entrada', 'mm', 'Trava: comprimento do bico, até a lingueta ficar com a largura cheia (= trava_entrada: 45°; era 3)'),
    ('projeto', 'trava_toco_altura', '2.7 mm', 'mm', 'Trava: altura do rabo-de-andorinha na ponta do pescoço, acima da tampa, onde a capa encaixa (v15, ideia do usuário: 2 -> 2,7; deixa 1,7 de teto na capa embaixo da crista, 1,3 no canto da frente, e o encaixe só vai até o meio dela)'),
    ('projeto', 'trava_toco_aba', '1.1 mm', 'mm', 'Trava: quanto o toco alarga na ponta da frente, da base ao topo (flanco a 22° da vertical; v15: 0,8 -> 1,1 com o toco mais alto, no mesmo ângulo)'),
    ('projeto', 'trava_toco_aba_tras', '1.5 mm', 'mm', 'Trava: atrás, o flanco do rabo-de-andorinha desce a 45° do pé do toco até a mesa (com o cursor de costas), alargando isto; o resto da ponta de trás do toco fica plano na mesa (trava_toco_altura menos isto: 1,2 na v15, era 0,5). Segura dos dois lados e imprime sem suporte (v10, ideia do usuário; a v9 tinha um /\\ com a ponta em gume na mesa, a v8 o lado de trás reto). v12 (usuário): 1 -> 1,5, a base plana pela metade e o lábio de trás da capa de 1,5 × 1,5'),
    ('projeto', 'trava_capa_labio', '0.5 mm', 'mm', 'Trava: o lábio de trás da capa (embaixo do flanco de 45°) termina reto, com isto de altura, antes do pé do toco: a ponta em gume era mais fina que um filete e não imprime. O cursor não muda; fica um vão de 0,5 × 0,5 no pé do flanco (v13, ideia do usuário)'),
    ('projeto', 'trava_pescoco_chanfro', 'trava_toco_aba_tras', 'mm', 'Trava: a ponta de cima do pescoço, atrás (embaixo do lábio da capa), também cai a 45°, do pé do toco até a mesa (um /\\ sobre a mesa). O lábio da capa só encosta no flanco do toco, e a capa se apoia só no topo do toco: antes o lábio ficava preso sem folga entre o pescoço e o flanco, e uma variação da impressão apertava a capa (v16, ideia do usuário). No máximo trava_toco_aba_tras; 0 = reto como antes'),
    ('projeto', 'trava_orelha_comprimento', '5 mm', 'mm', 'Trava: orelha de uma camada na mesa, saindo da base plana do toco para fora, além do topo dele, para a ponta não soltar da mesa ao imprimir; o usuário tira antes de montar (v14, ideia do usuário: um "auto brim"). Larga como o toco menos trava_chanfro_encaixe + 0,1 de cada lado (2,4), longe dos chanfros dos lados, que passam pelos rasgos. 0 = sem orelha'),
    ('projeto', 'trava_orelha_altura', '0.2 mm', 'mm', 'Trava: altura da orelha (uma camada)'),
    ('ajuste', 'trava_orelha_recuo', '0.2 mm', 'mm', 'Trava: com orelha, a aresta de fora da base do toco leva um chanfro a 45° da altura da orelha mais isto (0,4), e a orelha sai do pé dele: a quebra, no topo da orelha, fica isto para dentro da face onde assenta o teto do encaixe da capa'),
    ('projeto', 'trava_toco_comprimento', 'trava_haste_comprimento', 'mm', 'Trava: até onde vai o pé do toco ao longo da borda, a partir da ponta de trás da lingueta (o pé começa trava_toco_aba_tras depois dela; pode passar da haste, fica em cima da tampa)'),
    ('projeto', 'trava_toco_largura', 'trava_pescoco_largura', 'mm', 'Trava: largura do toco a partir do lado de fora (v6: a do pescoço, porque ele sobe pelos rasgos; v5 tinha 7)'),
    ('projeto', 'trava_capa_largura', '14 mm', 'mm', 'Trava: largura da capa, centrada no topo plano da tampa'),
    ('projeto', 'trava_capa_sobra', '1.5 mm', 'mm', 'Trava: quanto a capa passa do rasgo em cada ponta, aberta e travada (o comprimento sai disso)'),
    ('projeto', 'trava_capa_aba', '2.6 mm', 'mm', 'Trava: espessura das abas da capa (as pontas planas)'),
    ('projeto', 'trava_capa_crista', '4.6 mm', 'mm', 'Trava: altura da crista da capa acima da tampa'),
    ('projeto', 'trava_capa_crista_largura', '7 mm', 'mm', 'Trava: trecho plano no alto da crista'),
    ('projeto', 'trava_capa_concavo', '5 mm', 'mm', 'Trava: comprimento de cada lado côncavo, da crista até a aba'),
    ('projeto', 'trava_capa_canto', '1.5 mm', 'mm', 'Trava: chanfro dos quatro cantos da capa, vista de cima'),
    ('projeto', 'trava_capa_chanfro', '0.6 mm', 'mm', 'Trava: chanfro da aresta de cima nas pontas da capa'),
    ('projeto', 'trava_capa_sulcos', '3', '', 'Trava: sulcos de través embaixo da capa, perto da ponta de trás (1 de largura, 0,6 de fundo, a cada 2 mm). 2026-10-29 (usuário): vieram como marca da capa de 0,15 e ficaram, porque ajudam a segurar a capa e fazem um barulhinho ao deslizar'),
    ('projeto', 'trava_indicador_diametro', '5 mm', 'mm', 'Trava: círculo no topo da tampa, à frente da capa aberta, no meio do curso: aparece com a trava aberta, a capa esconde travada (v8, ideia do usuário)'),
    ('projeto', 'trava_indicador_profundidade', '0.4 mm', 'mm', 'Trava: rebaixo do círculo; o disco trava-indicador enche ele, para imprimir em outra cor como o logo'),
    ('ajuste', 'trava_folga_lingueta', '0 mm', 'mm', 'Trava: folga por lado da lingueta entre as pernas (v8: 0, o vão das pernas; v7 tinha almofadas de 0,1 nas pernas e uma camada a mais na lingueta, para compensar a trava deitada)'),
    ('ajuste', 'trava_folga_haste', '0 mm', 'mm', 'Trava: folga por lado do pescoço e do toco nos rasgos, tirada do cursor (v8: os rasgos têm a largura do pescoço no desenho, 3,0; a variante folga-005 tem 0,05); 2026-10-29: o sem folga ficou bom na V0'),
    ('ajuste', 'trava_folga_degrau', '0.4 mm', 'mm', 'Trava: folga entre o degrau do pescoço e o topo da base do clip (só na V0, onde o pescoço alarga; aqui não tem degrau)'),
    ('ajuste', 'trava_folga_rasgo', '0.1 mm', 'mm', 'Trava: folga do pescoço nas pontas dos rasgos, ao longo da borda'),
    ('ajuste', 'trava_folga_janela', '0.5 mm', 'mm', 'Trava: folga da lingueta em cada ponta do trecho sem pernas'),
    ('ajuste', 'trava_folga_capa', '0.2 mm', 'mm', 'Trava: folga entre a capa e o topo da tampa'),
    ('ajuste', 'trava_folga_toco', '0.15 mm', 'mm', 'Trava: folga dos flancos do rabo-de-andorinha no encaixe da capa, ao longo da borda; o teto fica no topo do toco. 2026-10-29 (usuário): sem folga a capa não entrava bem; das capas encaixe-005/010/015 ficou a de 0,15 (marca 3), impressa na V0 com o cursor sem folga (v8: 0, a capa dançava com 0,15 com o teto também afastado e ela deitada)'),
    ('ajuste', 'trava_chanfro_mesa', '0.4 mm', 'mm', 'Trava: chanfro nas arestas que encostam na mesa (pé de elefante): ponta de trás do clip, face de fora da tampa, ponta de trás do cursor, ponta de dentro da capa (v11; era a face de baixo)'),
    ('ajuste', 'trava_chanfro_encaixe', '0.2 mm', 'mm', 'Trava: chanfro de mesa nas arestas do rabo-de-andorinha que encostam na mesa (o topo do pescoço embaixo do lábio da capa; desde a v16, com trava_pescoco_chanfro, só as arestas de lado da base do toco): só contra o pé de elefante, porque o encaixe não tem folga; o de 0,4 comia o lábio (v9, pedido do usuário). Com a capa de lado (v11), a boca do encaixe dela não toca mais a mesa'),
]
