rhapsodyv/voron-panel-holder/(commit log)

2026-11-03 Panel holder para Voron V0.2 e Trident 350
    Geradores em build123d (gerador/): clipes e tampas (V0, V0 com trava, Trident, Trident com trava)
    e a peça única com trava (Trident e top hat da V0), com as conferências e as referências. Os
    STLs exportados ficam fora do git; de stl/ vão só os arquivos dos kits de trava impressos que o
    gerador da peça única reaproveita. Os estudos da trava em ideias-trava/.
    Configurador web estático (web/), que roda o gerador no navegador (Pyodide e OCP.wasm), com as
    faces padrão prontas em web/pre/. O workflow .github/workflows/pages.yml publica no GitHub Pages.
    README e licença MIT.
    [peca-unica-base-inteira-parede-1.5.stl, trava-capa-1x.stl, trava-capa-final-2x.stl, trava-capa-final.step, trava-cursor-final.step, trava-cursor-gancho-010-1x.stl, trava-cursor-gancho-020-1x.stl, trava-cursor-gancho-020.step]
2026-11-03 Portas da Trident: perna vertical dos cantos com 120, como as laterais
    A perna horizontal continua 85 (door_corner): a porta tem metade da largura e, com 120, a tampa
    do meio de cima e de baixo ficaria com 15 mm. A vertical (door_corner_v) passa a cover_corner, 120:
    na linha da dobradiça as emendas da porta e da lateral se alinham, e as tampas verticais da porta
    ficam com 267 mm, como as das laterais. Mudam os 4 cantos e as 2 tampas verticais de cada porta.
    Conferido na Trident e na Trident com trava (interferência, entre faces, giro a 15/45/90/110°).
    Faces prontas do site refeitas para trident, trident-trava e trident-peca-unica.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
    [mapa.py, parametros.py]
